carpe-noctem-cassel/cnc-circuit-boards/optical_flow_sensor/matlab_eval/fussball.jpg

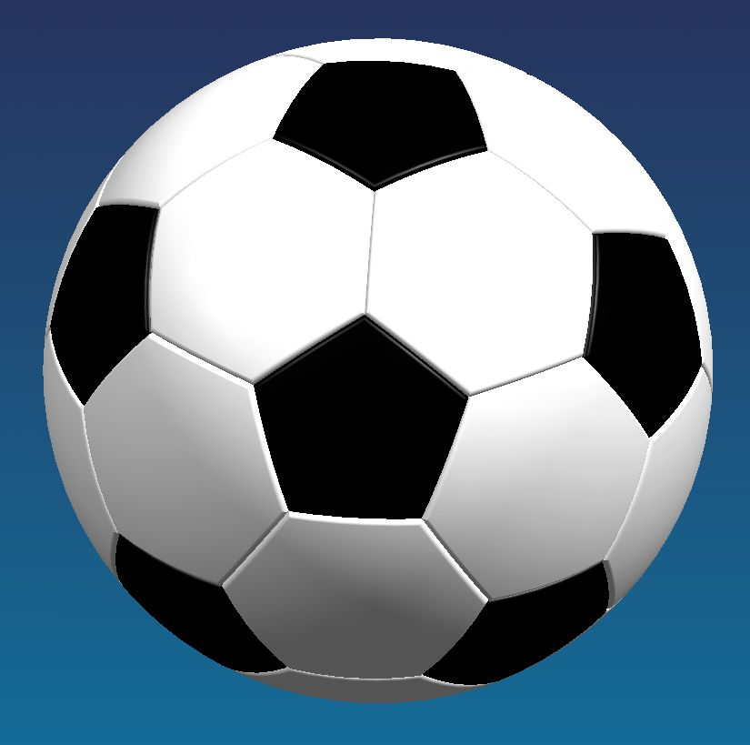
optical_flow_sensor/matlab_eval/fussball.jpg
