carpe-noctem-cassel/cnc-circuit-boards/actuator/actuator/fuses.png

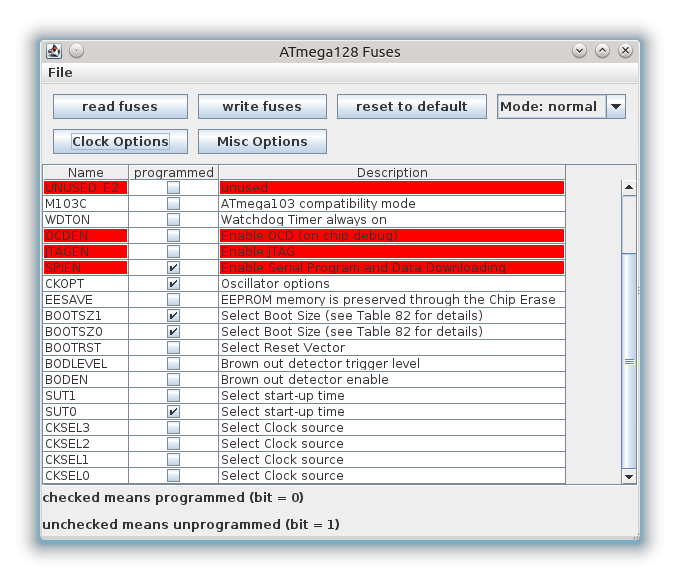
actuator/actuator/fuses.png
