carpe-noctem-cassel/cnc-circuit-boards/eth2can/eth2can/src/uip-0.9/doc/html/a00104.png

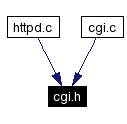
eth2can/eth2can/src/uip-0.9/doc/html/a00104.png
