carpe-noctem-cassel/cnc-circuit-boards/optical_flow_sensor/matlab_eval/Logfiles/20130215T172330/image_000.csv.png

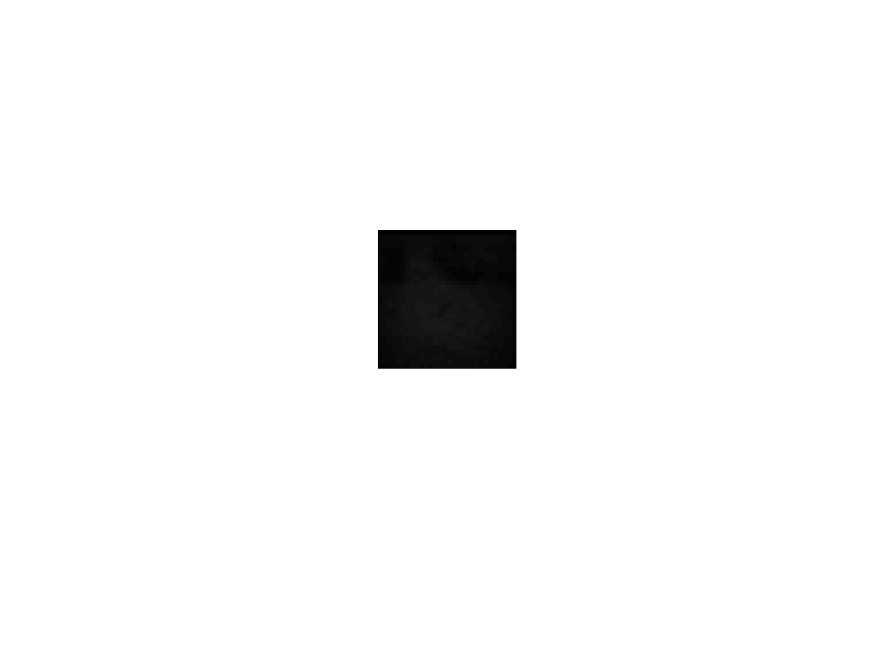
optical_flow_sensor/matlab_eval/Logfiles/20130215T172330/image_000.csv.png
