carpe-noctem-cassel/cnc-circuit-boards/powerSwitch/fuses.png

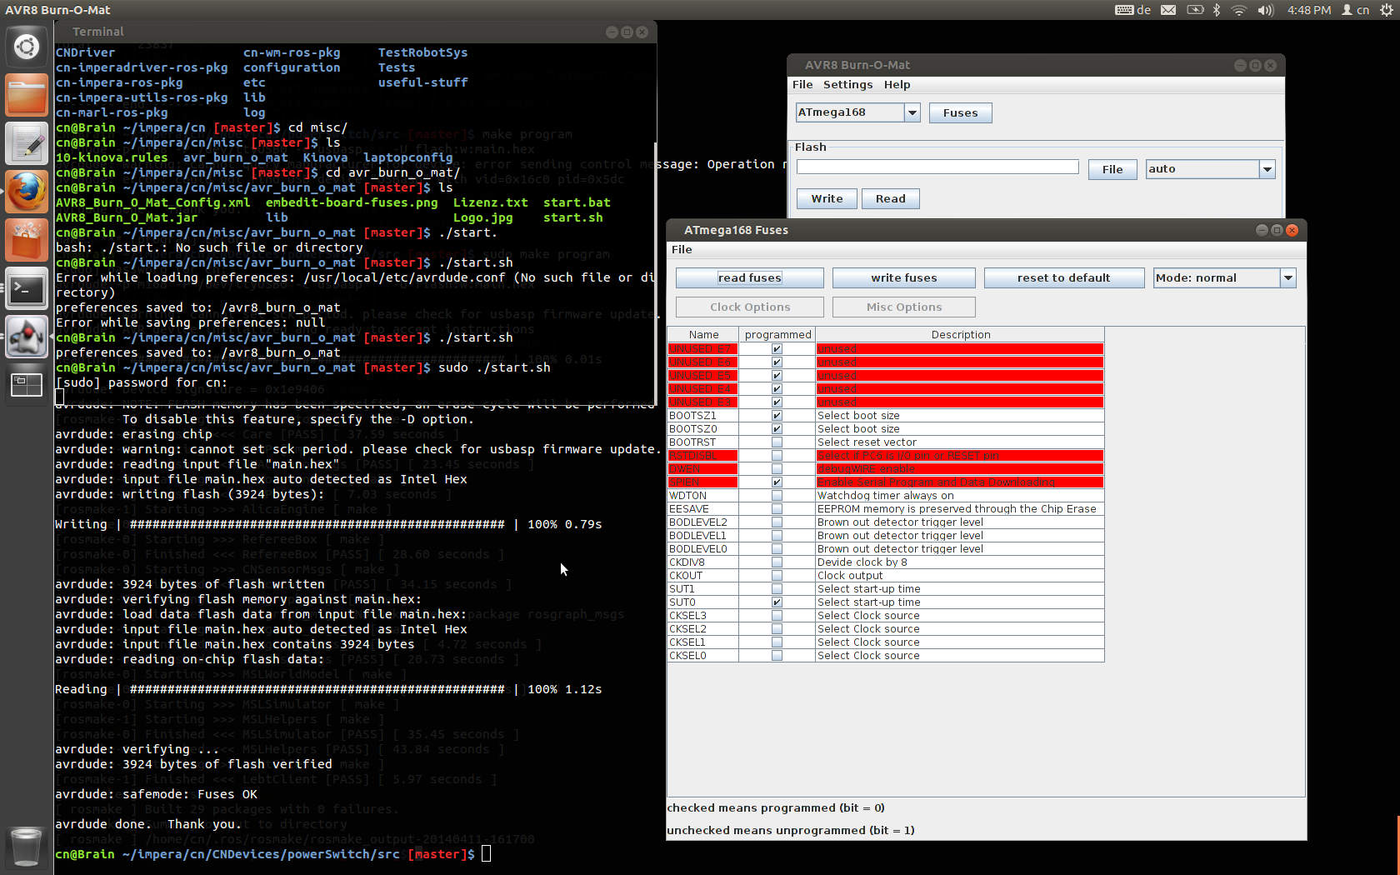
powerSwitch/fuses.png
