carpe-noctem-cassel/cnc-circuit-boards/kicker/rekick2017/pcb/BOM-rekick2017-v0.2.ods

Rekick 2017
Anzahl Boards: | 1
Typ | Name | Bauform | Menge | Menge Ges. | Preis p. Stk | Preis p. Board | Preis Ges. | Lieferant | Artikel-Nr/Bestell-Nr | URL
Operationsverstärker | MCP602-I/SN | SOIC-8 | 1 | 1 | 0.57 € | 0.57 € | 0.57 € | Farnell | 9758666 | http://de.farnell.com/microchip/mcp602-i-sn/op-amp-cmos-rro-p-smd-soic8-602/dp/9758666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
Operationsverstärker, isolierend | ADUM 4190 | SOIC-16N | 1 | 1 | 3.36 € | 3.36 € | 3.36 € | Farnell | 2293509 | http://de.farnell.com/analog-devices/adum4190ariz/getrennter-fehlerverst-5kv-16soic/dp/2293509?st=ADUM%204190
CAN Transceiver | MCP2551 | SOIC-8N | 1 | 1 | 1.10 € | 1.10 € | 1.10 € | Reichelt | MCP 2551-I/SN | http://www.reichelt.de/MCP-2551-I-SN/3/index.html?ACTION=3;ARTICLE=90069;SEARCH=MCP%202551-I/SN
MCU | ATMEGA32M1 | TQFP-32 | 1 | 1 | 6.51 € | 6.51 € | 6.51 € | Farnell | 2443180 | http://de.farnell.com/atmel/atmega32m1-au/mcu-8bit-atmega-16mhz-tqfp-32/dp/2443180?ost=atmega32m1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
Quarz 16MHz | HC49SM | HC49/4SMX | 1 | 1 | 0.36 € | 0.36 € | 0.36 € | Farnell | 1667017 | http://de.farnell.com/multicomp/hc49sm-16-30-50-60-16-atf/quarz-hc-49-4hsmx-16-0mhz/dp/1667017
NOR-Gatter | SN74LVC1G02DBVR | SOT-23-5 | 1 | 1 | 0.28 € | 0.28 € | 0.28 € | Farnell | 1287579 | http://de.farnell.com/texas-instruments/sn74lvc1g02dbvr/nor-gate-single-2-input-smd/dp/1287579
Quad NOR RS Latch | CD4043BD | SOIC-16N | 1 | 1 | 0.44 € | 0.44 € | 0.44 € | Farnell | 1741580 | http://de.farnell.com/texas-instruments/cd4043bd/logik-nor-r-s-latch-3st-quad-16soic/dp/1741580?st=CD4043B
Capacitor Charger | LT3751 | TSSOP-20 | 1 | 1 | 7.10 € | 7.10 € | 7.10 € | Mouser | 584-LT3751EFE#PBF | https://www.mouser.de/ProductDetail/Analog-Devices-Linear-Technology/LT3751EFEPBF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
Stecker ML | ML 10pol | RM 2.54 | 1 | 1 | 0.09 € | 0.09 € | 0.09 € | Reichelt | WSL 10G | http://www.reichelt.de/Pfosten-Wannenstecker/WSL-10G/3/index.html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
Molex Mini-Fit 6 Pin, Gehäuse | Molex Mini-Fit Jr., 6 Pin, Steckverbindergehäuse | 4.2mm | 1 | 1 | 0.27 € | 0.27 € | 0.27 € | Farnell | 151868 | http://de.farnell.com/molex/39-01-2060/mini-fit-geh-use-6pol-crimp/dp/151868
Molex Mini-Fit 6 Pin | Molex Mini-Fit Jr. 5569 6 Pin, Stiftleiste | 4.2mm | 1 | 1 | 1.04 € | 1.04 € | 1.04 € | Farnell | 1697135 | http://de.farnell.com/molex/39-30-0060/stecker-mini-fit-r-a-2reih-6kont/dp/1697135
Molex Mini-Fit 8 Pin, Gehäuse | Molex Mini-Fit Jr., 8 Pin, Steckverbindergehäuse | 4.2mm | 1 | 1 | 0.32 € | 0.32 € | 0.32 € | Farnell | 151869 | http://de.farnell.com/molex/39-01-2080/buchsengeh-use-8pol-crimpbar-mini/dp/151869?st=39-01-2080
Molex Mini-Fit 8 Pin | Molex Mini-Fit Jr. 5569 8 Pin, Stiftleiste | 4.2mm | 1 | 1 | 0.65 € | 0.65 € | 0.65 € | Farnell | 1697136 | http://de.farnell.com/molex/39-30-0080/stecker-mini-fit-r-a-2reih-8kont/dp/1697136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
Fuse | RUEF135 | bedrahtet RM 5.08 | 1 | 1 | 0.53 € | 0.53 € | 0.53 € | Farnell | 1175845 | http://de.farnell.com/te-connectivity-raychem/ruef135/polyswitch-sicherung-ptc-radial/dp/1175845
Diode | ES1A | SMA/DO-214AC | 5 | 5 | 0.13 € | 0.63 € | 0.63 € | Farnell | 1625028 | http://de.farnell.com/multicomp/es1a/diode-ultrakurze-erholzeit-1a/dp/1625028
Diode | DSEI30-10A | TO-247AD | 1 | 1 | 3.59 € | 3.59 € | 3.59 € | Farnell | 9359346 | http://de.farnell.com/ixys-semiconductor/dsei30-10a/diode-kurze-erholzeit-30a/dp/9359346
Diode, Zener 5V | BZX84-A5V1 | SOT23/TO236 | 2 | 2 | 0.16 € | 0.32 € | 0.32 € | Farnell | 2463546 | http://de.farnell.com/on-semiconductor/bzx84b5v1lt1g/zener-diode-225mw-5-1v-sot-23/dp/2463546?st=BZX84
Diode, Zener 12V | SZBZX84C12LT1G | SOT23/TO236 | 2 | 2 | 0.06 € | 0.12 € | 0.12 € | Farnell | 2728101 | http://de.farnell.com/on-semiconductor/szbzx84c12lt1g/zener-diode-aec-q101-12v-0-25w/dp/2728101
Diode, 1kV/8A | STTH810DI | TO-220 | 1 | 1 | 1.12 € | 1.12 € | 1.12 € | Farnell | 1295298 | http://de.farnell.com/stmicroelectronics/stth810di/diode-ultrakurze-erholzeit-8a/dp/1295298?st=STTH810D
LED, 2mA, grün | KP-2012LSGC | 0805 | 7 | 7 | 0.07 € | 0.52 € | 0.52 € | Farnell | 2463991 | http://de.farnell.com/kingbright/kp-2012lsgc/led-gr-n-0-8mcd-568nm-smd/dp/2463991
LED, 2mA, rot | KPT-2012LVSECK-J3-PRV | 0805 | 1 | 1 | 0.30 € | 0.30 € | 0.30 € | Farnell | 2610416 | http://de.farnell.com/kingbright/kpt-2012lvseck-j3-prv/led-rot-40mcd-625nm-smd/dp/2610416
Transistor n-Kanal, 30V/5A | IRLML6344TRPBF | SOT-23 | 4 | 4 | 0.33 € | 1.33 € | 1.33 € | Farnell | 1857299 | http://de.farnell.com/infineon/irlml6344trpbf/mosfet-n-kanal-30v-5a-sot23/dp/1857299
Transistor pnp, 30V/0.1A | BC 859B | SOT-23 | 1 | 1 | 0.03 € | 0.03 € | 0.03 € | Reichelt | BC 859B SMD | https://www.reichelt.de/BC-Transistoren/BC-859B-SMD/3/index.html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
Transistor -40V/-90A | IPD90P04P4L04ATMA1 | TO-252AA | 1 | 1 | 1.64 € | 1.64 € | 1.64 € | Farnell | 2480841 | http://de.farnell.com/infineon/ipd90p04p4l04atma1/mosfet-p-kanal-40v-90a-to-252/dp/2480841
Transistor 120V/70A | PSMN7R8-120PS | TO-220-3 | 2 | 2 | 1.21 € | 2.42 € | 2.42 € | Farnell | 2319894 | http://de.farnell.com/nxp/psmn7r8-120ps/mosfet-n-kanal-120v-70-to-220/dp/2319894?selectedCategoryId=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
Transistor 500V/8A | IRF840PBF | TO-220AB | 1 | 1 | 1.48 € | 1.48 € | 1.48 € | Farnell | 8648581 | http://de.farnell.com/vishay/irf840pbf/mosfet-n-kanal-500v-8a-to-220/dp/8648581
Transistor IGBT 1.2kV/100A | NGTB50N120FL2WG | TO-247 | 1 | 1 | 8.48 € | 8.48 € | 8.48 € | Farnell | 2399116 | http://de.farnell.com/on-semiconductor/ngtb50n120fl2wg/transistor-igbt-2-2v-100a-to-247/dp/2399116
Taster 24V/50mA, 1.47N | B3F-1022 | BF3 (6x6) | 1 | 1 | 0.24 € | 0.24 € | 0.24 € | Farnell | 1829495 | http://de.farnell.com/omron-electronic-components/b3f-1022/taster-6x6-spno-5mm-st-ssel/dp/1829495
Isolated Driver | SI8261ABC | SOIC-8 | 2 | 2 | 1.16 € | 2.32 € | 2.32 € | Farnell | 2423180 | http://de.farnell.com/silicon-labs/si8261abc-c-is/digital-isolator-40ns-nsoic-8/dp/2423180
DC/DC-Wandler 3.3V | LM1117MP-3.3 | SOT-223 | 1 | 1 | 0.90 € | 0.90 € | 0.90 € | Farnell | 9778195 | http://de.farnell.com/texas-instruments/lm1117mp-3-3/v-reg-ldo-3-3v-1117-sot223-3/dp/9778195
DC/DC-Wandler 5V | OKI515W36C | RM 2.54 | 2 | 2 | 5.35 € | 10.70 € | 10.70 € | Reichelt | OKI515W36C | https://www.reichelt.de/Wandler-groesser-1-W/OKI515W36C/3/index.html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
DC/DC-Wandler 12V | R-7812-05 | RM 2.54 | 1 | 1 | 8.60 € | 8.60 € | 8.60 € | Reichelt | R-7812-05 | https://www.reichelt.de/Wandler-bis-1-W/R-7812-05/3/index.html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
DC/DC-Wandler | TMH 2412S | SIP | 1 | 1 | 6.20 € | 6.20 € | 6.20 € | Farnell | 1007565 | http://de.farnell.com/tracopower/tmh-2412s/wandler-dc-dc-2w-12v-0-2a/dp/1007565?selectedCategoryId=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
Transformator | GA3459-BL (alternativ GA3460-BL) |  | 1 | 1 | 5.53 € | 5.53 € | 5.53 € | Farnell | 2458040 | http://de.farnell.com/coilcraft/ga3459-bl/transformator-flyback-lt3751-smd/dp/2458040?ost=GA3459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
Kondensator 10pF/10V | MC0603N100J500CT | 0603 | 2 | 2 | 0.01 € | 0.02 € | 0.02 € | Farnell | 2320799 | http://de.farnell.com/multicomp/mc0603n100j500ct/kondensator-mlcc-c0g-np0-10pf/dp/2320799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
Kondensator 22pF/10V | MCMT18N220F100CT | 0603 | 2 | 2 | 0.06 € | 0.13 € | 0.13 € | Farnell | 1856082 | http://de.farnell.com/multicomp/mcmt18n220f100ct/kondensator-mlcc-c0g-np0-22pf/dp/1856082
Kondensator 22pF/120V | MC1206N220J631CT | 1206 | 1 | 1 | 0.17 € | 0.17 € | 0.17 € | Farnell | 1855816 | http://de.farnell.com/multicomp/mc1206n220j631ct/kondensator-mlcc-c0g-np0-22pf/dp/1855816
Kondensator 100nF/16V | MC0603B104K160CT | 0603 | 15 | 15 | 0.01 € | 0.21 € | 0.21 € | Farnell | 1759016 | http://de.farnell.com/multicomp/mc0603b104k160ct/kondensator-mlcc-x7r-100nf-16v/dp/1759016
Kondensator 1µF/16V | MC0603F105Z100CT | 0603 | 5 | 5 | 0.02 € | 0.11 € | 0.11 € | Farnell | 1759398 | http://de.farnell.com/multicomp/mc0603f105z100ct/kondensator-mlcc-y5v-1uf-10v-0603/dp/1759398
Kondensator 10µF/10V | ZRB18AR61E106ME01L | 0603 | 2 | 2 | 0.27 € | 0.54 € | 0.54 € | Farnell | 2469398 | http://de.farnell.com/murata/zrb18ar61e106me01l/kondensator-mlcc-x5r-10uf-25v/dp/2469398
Kondensator 10µF/50V | GRM31CC8YA106KA12L | 1206 | 10 | 10 | 0.32 € | 3.21 € | 3.21 € | Farnell | 1889298 | http://de.farnell.com/murata/grm31cc8ya106ka12l/kondensator-mlcc-x6s-10uf-35v/dp/1889298
Kondensator 47µF/35V | VF 47/35 P-D | Panasonic D | 5 | 5 | 0.18 € | 0.90 € | 0.90 € | Reichelt | VF 47/35 P-D | http://www.reichelt.de/Elkos-SMD-Low-ESR-105-C/VF-47-35-P-D/3/index.html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
Kondensator 100µF/35V | ECA1VM101 | E2.5-7 | 3 | 3 | 0.17 € | 0.51 € | 0.51 € | Farnell | 9693670 | http://de.farnell.com/panasonic-electronic-components/eca1vm101/kondensator-alu-elko-100uf-35v/dp/9693670
Kondensator 0.1µF/450V | GRM55DR73A104KW01L | 2220 | 1 | 1 | 1.19 € | 1.19 € | 1.19 € | Farnell | 2456120 | http://de.farnell.com/murata/grm55dr73a104kw01l/kondensator-mlcc-x7r-0-1uf-1kv/dp/2456120
Kondensator 10µF/450V | EEU-EE2W100U | E6-10.5 | 1 | 1 | 0.96 € | 0.96 € | 0.96 € | Farnell | 1673499 | http://de.farnell.com/panasonic-electronic-components/eeuee2w100u/kondensator-alu-elko-10uf-450v/dp/1673499
Widerstand 0.002 | LRMAT2512-R002FT4 | 2512 | 2 | 2 | 0.31 € | 0.63 € | 0.63 € | Farnell | 2079420 | http://de.farnell.com/welwyn/lrmat2512-r002ft4/chipwiderstand-metalllegierung/dp/2079420
Widerstand 3.6 | ERJB1BF3R6U | 1020 | 3 | 3 | 0.44 € | 1.32 € | 1.32 € | Farnell | 2294017 | http://de.farnell.com/panasonic-electronic-components/erjb1bf3r6u/dickschichtwiderst-3r6-1-2w-2010/dp/2294017
Widerstand 4.7 | ASC0805-4R7FT5 | 0805 | 2 | 2 | 0.03 € | 0.06 € | 0.06 € | Farnell | 2078939 | http://de.farnell.com/welwyn/asc0805-4r7ft5/dickschichtwiderstand-4r7-1-0/dp/2078939
Widerstand 82Ohm, 5W | RKH214-8R | KH214R-8 | 6 | 6 | 0.44 € | 2.64 € | 2.64 € | Bürklin | 44 E 250 | https://www.buerklin.com/en/wire-wound-resistor/p/44e250
Widerstand 390, 1% | MCWR08X3900FTL | 0805 | 2 | 2 | 0.01 € | 0.01 € | 0.01 € | Farnell | 2447645 | http://de.farnell.com/multicomp/mcwr08x3900ftl/dickschichtwiderst-390-ohm-1-0/dp/2447645
Widerstand 1k, 1% | MC01W080511K | 0805 | 5 | 5 | 0.00 € | 0.01 € | 0.01 € | Farnell | 9332383 | http://de.farnell.com/multicomp/mc01w080511k/dickschichtwiderstand-1k-1-0-1w/dp/9332383
Widerstand 3.3k, 1% | MCWR08X3301FTL | 0805 | 2 | 2 | 0.01 € | 0.01 € | 0.01 € | Farnell | 2447651 | http://de.farnell.com/multicomp/mcwr08x3301ftl/dickschichtwiderstand-3k3-1-0/dp/2447651
Widerstand 4.7k, 1% | MC01W080514K7 | 0805 | 5 | 5 | 0.00 € | 0.01 € | 0.01 € | Farnell | 9333266 | http://de.farnell.com/multicomp/mc01w080514k7/dickschichtwiderstand-4k7-1-0/dp/9333266
Widerstand 5.6k, 1% | MC01W080555K6 | 0805 | 10 | 10 | 0.01 € | 0.05 € | 0.05 € | Farnell | 9334696 | http://de.farnell.com/multicomp/mc01w080555k6/dickschichtwiderstand-5k6-5-0/dp/9334696
Widerstand 10k, 1% | MCWR08X1002FTL | 0805 | 6 | 6 | 0.01 € | 0.04 € | 0.04 € | Farnell | 2447553 | http://de.farnell.com/multicomp/mcwr08x1002ftl/dickschichtwiderstand-10k-1-0/dp/2447553
Widerstand 14k, 1% | MCWR08X1402FTL | 0805 | 1 | 1 | 0.01 € | 0.01 € | 0.01 € | Farnell | 2447571 | http://de.farnell.com/multicomp/mcwr08x1402ftl/dickschichtwiderst-14kohm-1-0/dp/2447571
Widerstand 36.5k, 1% | MCWR08X3652FTL | 0805 | 1 | 1 | 0.01 € | 0.01 € | 0.01 € | Farnell | 2695046 | http://de.farnell.com/multicomp/mcwr08x3652ftl/dicksch-widerstand-36k5-1-0-125w/dp/2695046
Widerstand 50k, 1% | MCWR08X4992FTL | 0805 | 10 | 10 | 0.01 € | 0.07 € | 0.07 € | Farnell | 2447668 | http://de.farnell.com/multicomp/mcwr08x4992ftl/dickschichtwiderst-49k9-1-0-125w/dp/2447668
Widerstand 56k, 1% | MCWR08X5602FTL | 0805 | 1 | 1 | 0.01 € | 0.01 € | 0.01 € | Farnell | 2447687 | http://de.farnell.com/multicomp/mcwr08x5602ftl/dickschichtwiderstand-56k-1-0/dp/2447687
Widerstand 80.6k, 1% | MCMR08X8062FTL | 0805 | 2 | 2 | 0.02 € | 0.04 € | 0.04 € | Farnell | 2073847 | http://de.farnell.com/multicomp/mcmr08x8062ftl/keramikwiderstand-80k6-1-0-125w/dp/2073847
Widerstand 150k, 1% | MCWR08X1503FTL | 0805 | 1 | 1 | 0.01 € | 0.01 € | 0.01 € | Farnell | 2447573 | http://de.farnell.com/multicomp/mcwr08x1503ftl/dickschichtwiderst-150kohm-1-0/dp/2447573
Widerstand 180k, 1% | MCWR08X1803FTL | 0805 | 1 | 1 | 0.01 € | 0.01 € | 0.01 € | Farnell | 2447582 | http://de.farnell.com/multicomp/mcwr08x1803ftl/dickschichtwiderst-180kohm-1-0/dp/2447582
Widerstand 240k, 1% | MC01W08051240K | 0805 | 1 | 1 | 0.00 € | 0.00 € | 0.00 € | Farnell | 9332910 | http://de.farnell.com/multicomp/mc01w08051240k/dickschichtwiderstand-240k-1-0/dp/9332910
Widerstand 330k, 1% | MCWR08X3303FTL | 0805 | 2 | 2 | 0.01 € | 0.01 € | 0.01 € | Farnell | 2447637 | http://de.farnell.com/multicomp/mcwr08x3303ftl/dickschichtwiderst-330kohm-1-0/dp/2447637
Widerstand 560k, 1% | MC01W08051560K | 0805 | 1 | 1 | 0.00 € | 0.00 € | 0.00 € | Farnell | 9333398 | http://de.farnell.com/multicomp/mc01w08051560k/dickschichtwiderstand-560k-1-0/dp/9333398
Widerstand 1M. 1% | MC01W08051910K | 1206 | 3 | 3 | 0.00 € | 0.01 € | 0.01 € | Farnell | 9333657 | http://de.farnell.com/multicomp/mc01w08051910k/dickschichtwiderstand-910k-1-0/dp/9333657
Widerstand, NTC | B57211P0250M301 | - | 1 | 1 | 1.08 € | 1.08 € | 1.08 € | Farnell | 2101623 | http://de.farnell.com/epcos/b57211p0250m301/thermistor-disc-ntc-25-ohm-20/dp/2101623?st=ntc
Ethernet-Modul
Levelshifter
Molex Mini-Fit, Crimpkontakt, Female | Molex Mini-Fit Jr. 5556 Female Crimpkontakt 100Stk
Varistor
Widerstand 120
PinHeader 1x3 |  | RM 2.54 | 2
BuchsenHeader 1x5 |  | RM 2.54 | 2
