carpe-noctem-cassel/cnc-circuit-boards/beagle2can/beagle2can.ods

Beagle2CAN
Anzahl Boards: | 1
Typ | Name | Bauform | Menge | Menge Ges. | Preis p. Stk | Preis p. Board | Preis Ges. | Vorrätig | Lieferant | Artikel-Nr/Bestell-Nr | URL
LED, Diode, Transistor
LED, 2mA, grün | KP-2012LSGC | 0805 | 3 | 3 | 0.07 € | 0.22 € | 0.22 € |  | Farnell | 2463991 | http://de.farnell.com/kingbright/kp-2012lsgc/led-gr-n-0-8mcd-568nm-smd/dp/2463991
IC
CAN Transceiver | MCP2551 | SOIC-8N | 2 | 2 | 1.10 € | 2.20 € | 2.20 € |  | Reichelt | MCP 2551-I/SN | http://www.reichelt.de/MCP-2551-I-SN/3/index.html?ACTION=3;ARTICLE=90069;SEARCH=MCP%202551-I/SN
Pegelwandler | TXB0108PWR | SOP-20N | 1 | 0 | 1.52 € | 1.52 € | 1.52 € | ja | Farnell | 1494945 | http://de.farnell.com/texas-instruments/txb0108pwr/translator-8bit-bidirectional/dp/1494945
BeagleBoard Black | BeagleBoard Black | RM 2,54 2x23 | 1 | 1 | 43.07 € | 43.07 € | 43.07 € |  | Farnell | 2422228 | https://de.farnell.com/element14/bbone-black-4g/beaglebone-black-rev-c-cortex/dp/2422228
Stecker
CAN-Stecker | RJ10 | ? | 2 | 0 |  | 0.00 € | 0.00 € | ja
Stecker ML, gewinkelt | ML 10pol, gewinkelt | RM 2.54 | 1 | 1 | 0.15 € | 0.15 € | 0.15 € |  | Reichelt | WSL 10W | http://www.reichelt.de/?ACTION=3;ARTICLE=22818;SEARCH=Wannenstecker,%2010-polig,%20gew
Stiftleiste | Stiftleiste 2x23 | RM 2.54 | 2 | 2 | 0.24 € | 0.48 € | 0.48 € |  | Reichelt | SL 2X25G 2,54 | http://www.reichelt.de/?ACTION=3;ARTICLE=19494;SEARCH=SL%202X25
Molex Mini-Fit 4 Pin | Molex Mini-Fit Jr. 5569 4 Pin, Stiftleiste | 4.2mm | 2 | 2 | 0.57 € | 1.14 € | 1.14 € |  | Farnell | 1697133 | http://de.farnell.com/molex/39-30-0040/stecker-mini-fit-r-a-2reih-4kont/dp/1697133
Molex Mini-Fit 4 Pin, Gehäuse | Molex Mini-Fit Jr., 4 Pin, Steckverbindergehäuse | 4.2mm | 2 | 2 | 0.19 € | 0.39 € | 0.39 € |  | Farnell | 151867 | http://de.farnell.com/molex/39-01-2040/mini-fit-geh-use-4pol-crimp/dp/151867
Fuse | RUEF135 | bedrahtet RM 5.08 | 1 | 1 | 0.42 € | 0.42 € | 0.42 € |  | Farnell | 1175845 | http://de.farnell.com/te-connectivity-raychem/ruef135/polyswitch-sicherung-ptc-radial/dp/1175845
DC/DC-Wanler 5V, 2.5W | R-78E5.0-0.5 | TO-220 | 1 | 1 | 2.51 € | 2.51 € | 2.51 € |  | Farnell | 2078564 | http://de.farnell.com/recom-power/r-78e5-0-0-5/dc-dc-wandler-5v-2-5w/dp/2078564
Widerstände
Widerstand 120 | MC01W08051120R | 0805 | 2 | 0 | 0.00 € | 0.00 € | 0.00 € | ja | Farnell | 9332480 | http://de.farnell.com/multicomp/mc01w08051120r/dickschichtwiderstand-120r-1-0/dp/9332480
Widerstand 560 | MC01W08051560R | 0805 | 1 | 1 | 0.00 € | 0.00 € | 0.00 € |  | Farnell | 9333363 | http://de.farnell.com/multicomp/mc01w08051560r/dickschichtwiderstand-560r-1-0/dp/9333363
Widerstand 1k, 1% | MC01W080511K | 0805 | 3 | 3 | 0.00 € | 0.01 € | 0.01 € |  | Farnell | 9332383 | http://de.farnell.com/multicomp/mc01w080511k/dickschichtwiderstand-1k-1-0-1w/dp/9332383
Widerstand 10k, 1% | WF08P1002FTL | 0805 | 3 | 3 | 0.01 € | 0.02 € | 0.02 € |  | Farnell | 2502786 | http://de.farnell.com/walsin/wf08p1002ftl/dickschichtwiderstand-10k-1-150v/dp/2502786
Kondensatoren
Kondensator 100nF/16V | MC0603B104K160CT | 0603 | 6 | 6 | 0.01 € | 0.08 € | 0.08 € |  | Farnell | 1759016 | http://de.farnell.com/multicomp/mc0603b104k160ct/kondensator-mlcc-x7r-100nf-16v/dp/1759016
Kondensator 47µF/35V | VF 47/35 P-D | Panasonic D | 2 | 2 | 0.18 € | 0.36 € | 0.36 € |  | Reichelt | VF 47/35 P-D | http://www.reichelt.de/Elkos-SMD-Low-ESR-105-C/VF-47-35-P-D/3/index.html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
 |  |  |  |  | 50.06 € | 52.58 € | 52.58 €
