carpe-noctem-cassel/cnc-circuit-boards/powerSwitch/2016-v0.95.ods

PowerSwitch
Anzahl Boards: | 1
Typ | Name | Bauform | Menge | Menge Ges. | Preis p. Stk | Preis p. Board | Preis Ges. | Vorrätig | Lieferant | Artikel-Nr/Bestell-Nr | URL
LED, Diode, Transistor
LED, 2mA, grün | KP-2012LSGC | 0805 | 4 | 4 | 0.07 € | 0.30 € | 0.30 € |  | Farnell | 2463991 | http://de.farnell.com/kingbright/kp-2012lsgc/led-gr-n-0-8mcd-568nm-smd/dp/2463991
LED, 2mA, gelb | KPT-2012LVSYCK-J3-PRV | 0805 | 2 | 2 | 0.30 € | 0.59 € | 0.59 € |  | Farnell | 2610418 | http://de.farnell.com/kingbright/kpt-2012lvsyck-j3-prv/led-gelb-25mcd-590nm-smd/dp/2610418
LED, 2mA, rot | KPT-2012LVSECK-J3-PRV | 0805 | 1 | 1 | 0.30 € | 0.30 € | 0.30 € |  | Farnell | 2610416 | http://de.farnell.com/kingbright/kpt-2012lvseck-j3-prv/led-rot-40mcd-625nm-smd/dp/2610416
LED, 2mA, blau | KPT-2012LVVBC-D | 0805 | 1 | 1 | 0.35 € | 0.35 € | 0.35 € |  | Farnell | 2610420 | http://de.farnell.com/kingbright/kpt-2012lvvbc-d/led-blau-24mcd-470nm-smd/dp/2610420
Diode | ES1A | SMA/DO-214AC | 3 | 3 | 0.13 € | 0.38 € | 0.38 € |  | Farnell | 1625028 | http://de.farnell.com/multicomp/es1a/diode-ultrakurze-erholzeit-1a/dp/1625028
Spannungsreferenz | TL431FDT | SOT-23 | 6 | 6 | 0.07 € | 0.41 € | 0.41 € |  | Farnell | 2095479 | http://de.farnell.com/nxp/tl431fdt/spannungsref-shunt-2-495v-36v/dp/2095479
Zenerdiode 3.3V | BZX84-A3V3,215 | SOT-23 | 1 | 1 | 0.37 € | 0.37 € | 0.37 € |  | Farnell | 2463632 | http://de.farnell.com/nxp/bzx84-a3v3-215/zener-diode-0-25w-3-3v-sot-23/dp/2463632
Transistor n-Kanal 60V, 270mA | NX7002BK (alternative zu BC 849B SMD) | SOT-23 | 1 | 1 | 0.06 € | 0.06 € | 0.06 € |  | Farnell | 2469640 | http://de.farnell.com/nxp/nx7002bk/mosfet-n-kanal-60v-0-27a-sot-23/dp/2469640?ost=2469640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
Transistor p-Kanal 50V, 130mA | BSS84 (alternative zu BC 859B SMD) | SOT-23 | 2 | 2 | 0.07 € | 0.13 € | 0.13 € |  | Farnell | 1094997 | http://de.farnell.com/fairchild-semiconductor/bss84/mosfet-p-kanal-50v-0-13a-sot23/dp/1094997?ost=1094997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
Transistor n-Kanal | BTS555 | TO220-51 | 1 | 1 | 8.35 € | 8.35 € | 8.35 € |  | Reichelt | BTS 555 | http://www.reichelt.de/BS-Transistoren/BTS-555/3/index.html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
Transistor n-Kanal | BTS6133 | TO252-51 | 2 | 2 | 2.44 € | 4.88 € | 4.88 € |  | Farnell | 1440811 | http://de.farnell.com/infineon/bts6133d/profet-p-to252-5/dp/1440811
Transistor p-Kanal | IPP80P03P4L04AKSA1 | TO-220BV | 4 | 4 | 1.47 € | 5.88 € | 5.88 € |  | Farnell | 2443406 | http://de.farnell.com/infineon/ipp80p03p4l-04/mosfet-p-kanal-30v-80a-to-220/dp/2443406
IC
CAN Transceiver | MCP2551 | SOIC-8N | 1 | 1 | 1.10 € | 1.10 € | 1.10 € |  | Reichelt | MCP 2551-I/SN | http://www.reichelt.de/MCP-2551-I-SN/3/index.html?ACTION=3;ARTICLE=90069;SEARCH=MCP%202551-I/SN
MCU | ATMEGA16M1 | TQFP-32 | 1 | 1 | 6.51 € | 6.51 € | 6.51 € |  | Farnell | 2443180 | http://de.farnell.com/atmel/atmega32m1-au/mcu-8bit-atmega-16mhz-tqfp-32/dp/2443180?exaMfpn=true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
Operationsverstärker | LM 1458D | SOIC-8 | 1 | 1 | 0.12 € | 0.12 € | 0.12 € |  | Reichelt | LM 1458 D | http://www.reichelt.de/index.html?ACTION=3;ARTICLE=39428;SEARCH=LM%201458%20D
Pegelwandler | TXB0108PWR | SOP-20N | 1 | 0 | 1.52 € | 1.52 € | 1.52 € | ja | Farnell | 1494945 | http://de.farnell.com/texas-instruments/txb0108pwr/translator-8bit-bidirectional/dp/1494945
Stecker
CAN-Stecker | RJ10 | ? | 1 | 0 |  | 0.00 € | 0.00 € | ja
Stecker ML | ML 10pol | RM 2.54 | 1 | 1 | 0.09 € | 0.09 € | 0.09 € |  | Reichelt | WSL 10G | http://www.reichelt.de/Pfosten-Wannenstecker/WSL-10G/3/index.html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
Stecker ML, gewinkelt | ML 10pol, gewinkelt | RM 2.54 | 1 | 1 | 0.15 € | 0.15 € | 0.15 € |  | Reichelt | WSL 10W | http://www.reichelt.de/?ACTION=3;ARTICLE=22818;SEARCH=Wannenstecker,%2010-polig,%20gew
Stiftleiste | Stiftleiste 1x5 | RM 2.54 | 2 | 0 | 0.37 € | 0.74 € | 0.74 € | ja | Reichelt | SL 1X50G 2,54 | http://www.reichelt.de/Stiftleisten/SL-1X50G-2-54/3/index.html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
Molex Mini-Fit 4 Pin | Molex Mini-Fit Jr. 5569 4 Pin, Stiftleiste | 4.2mm | 2 | 2 | 0.57 € | 1.14 € | 1.14 € |  | Farnell | 1697133 | http://de.farnell.com/molex/39-30-0040/stecker-mini-fit-r-a-2reih-4kont/dp/1697133
Molex Mini-Fit 6 Pin | Molex Mini-Fit Jr. 5569 6 Pin, Stiftleiste | 4.2mm | 2 | 2 | 1.04 € | 2.08 € | 2.08 € |  | Farnell | 1697135 | http://de.farnell.com/molex/39-30-0060/stecker-mini-fit-r-a-2reih-6kont/dp/1697135
Molex Mini-Fit 4 Pin, Gehäuse | Molex Mini-Fit Jr., 4 Pin, Steckverbindergehäuse | 4.2mm | 2 | 2 | 0.19 € | 0.39 € | 0.39 € |  | Farnell | 151867 | http://de.farnell.com/molex/39-01-2040/mini-fit-geh-use-4pol-crimp/dp/151867
Molex Mini-Fit 6 Pin, Gehäuse | Molex Mini-Fit Jr., 6 Pin, Steckverbindergehäuse | 4.2mm | 2 | 2 | 0.27 € | 0.55 € | 0.55 € |  | Farnell | 151868 | http://de.farnell.com/molex/39-01-2060/mini-fit-geh-use-6pol-crimp/dp/151868
Molex Mini-Fit, Crimpkontakt, Female | Molex Mini-Fit Jr. 5556 Female Crimpkontakt 100Stk | - | 1 | 1 | 8.80 € | 8.80 € | 8.80 € |  | Farnell | 9732195 | http://de.farnell.com/molex/39-00-0039/crimpkontak-buchse-minfit-pk100/dp/9732195
Fuse | RUEF135 | bedrahtet RM 5.08 | 1 | 1 | 0.42 € | 0.42 € | 0.42 € |  | Farnell | 1175845 | http://de.farnell.com/te-connectivity-raychem/ruef135/polyswitch-sicherung-ptc-radial/dp/1175845
Quarz 16MHz | HC49SM | HC49/4SMX | 1 | 1 | 0.36 € | 0.36 € | 0.36 € |  | Farnell | 1667017 | http://de.farnell.com/multicomp/hc49sm-16-30-50-60-16-atf/quarz-hc-49-4hsmx-16-0mhz/dp/1667017
Summer | MCKPX-G1205A-3700 | RM7.6 | 1 | 1 | 0.59 € | 0.59 € | 0.59 € |  | Farnell | 2135914 | http://de.farnell.com/multicomp/mckpx-g1205a-3700/summer-4v-8v-30ma-bei-5vdc/dp/2135914
DC/DC-Wanler 3.3V, 1.65W | R-78E3.3-0.5 | TO-220 | 1 | 1 | 2.53 € | 2.53 € | 2.53 € |  | Farnell | 2218602 | http://de.farnell.com/recom-power/r-78e3-3-0-5/dc-dc-wandler-3-3v-500ma-aus-durchst/dp/2218602
DC/DC-Wanler 5V, 2.5W | R-78E5.0-0.5 | TO-220 | 1 | 1 | 2.51 € | 2.51 € | 2.51 € |  | Farnell | 2078564 | http://de.farnell.com/recom-power/r-78e5-0-0-5/dc-dc-wandler-5v-2-5w/dp/2078564
Ethernet-Modul | ENC28J60-H | Stiftleisten (2x 1x5) | 1 | 1 | 18.17 € | 18.17 € | 18.17 € |  | Farnell | 1701543 | http://de.farnell.com/olimex/enc28j60-h/modul-enc28j60-spi-ethernet/dp/1701543
Kühlkörper | SK 95 25 TO 220 | für TO-220 | 4 | 4 | 2.03 € | 8.12 € | 8.12 € |  | Farnell | 4621554 | http://de.farnell.com/fischer-elektronik/sk-95-25sa-220/k-hlk-rper-to-220-36-c-w/dp/4621554?ost=sk95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
Widerstände
Widerstand 0.002 | LRMAT2512-R002FT4 | 2512 | 1 | 1 | 0.31 € | 0.31 € | 0.31 € |  | Farnell | 2079420 | http://de.farnell.com/welwyn/lrmat2512-r002ft4/chipwiderstand-metalllegierung/dp/2079420
Widerstand 120 | MC01W08051120R | 0805 | 1 | 0 | 0.00 € | 0.00 € | 0.00 € | ja | Farnell | 9332480 | http://de.farnell.com/multicomp/mc01w08051120r/dickschichtwiderstand-120r-1-0/dp/9332480
Widerstand 150 | MC01W08051150R | 0805 | 0 | 0 | 0.00 € | 0.00 € | 0.00 € |  | Farnell | 9332596 | http://de.farnell.com/multicomp/mc01w08051150r/dickschichtwiderstand-150r-1-0/dp/9332596
Widerstand 560 | MC01W08051560R | 0805 | 3 | 3 | 0.00 € | 0.01 € | 0.01 € |  | Farnell | 9333363 | http://de.farnell.com/multicomp/mc01w08051560r/dickschichtwiderstand-560r-1-0/dp/9333363
Widerstand 1k, 1% | MC01W080511K | 0805 | 6 | 6 | 0.00 € | 0.01 € | 0.01 € |  | Farnell | 9332383 | http://de.farnell.com/multicomp/mc01w080511k/dickschichtwiderstand-1k-1-0-1w/dp/9332383
Widerstand 4.7k, 1% | MC01W080514K7 | 0805 | 4 | 4 | 0.00 € | 0.01 € | 0.01 € |  | Farnell | 9333266 | http://de.farnell.com/multicomp/mc01w080514k7/dickschichtwiderstand-4k7-1-0/dp/9333266
Widerstand 10k, 1% | WF08P1002FTL | 0805 | 8 | 8 | 0.01 € | 0.06 € | 0.06 € |  | Farnell | 2502786 | http://de.farnell.com/walsin/wf08p1002ftl/dickschichtwiderstand-10k-1-150v/dp/2502786
Widerstand 20k, 1% | MC01W0805120K | 0805 | 3 | 3 | 0.00 € | 0.01 € | 0.01 € |  | Farnell | 9332774 | http://de.farnell.com/multicomp/mc01w0805120k/dickschichtwiderstand-20k-1-0/dp/9332774
Widerstand 50k, 1% | MC01W0805149K9 | 0805 | 0 | 0 | 0.00 € | 0.00 € | 0.00 € |  | Farnell | 2141884 | http://de.farnell.com/multicomp/mc01w0805149k9/dickschichtwiderstand-49k9-1-0/dp/2141884
Widerstand 100k, 1% | MC01W08051100K | 0805 | 7 | 7 | 0.00 € | 0.02 € | 0.02 € |  | Farnell | 9332405 | http://de.farnell.com/multicomp/mc01w08051100k/dickschichtwiderstand-100k-1-0/dp/9332405
Widerstand 240k, 1% | MC01W08051240K | 0805 | 2 | 2 | 0.00 € | 0.00 € | 0.00 € |  | Farnell | 9332910 | http://de.farnell.com/multicomp/mc01w08051240k/dickschichtwiderstand-240k-1-0/dp/9332910
Widerstand 560k, 1% | MC01W08051560K | 0805 | 1 | 1 | 0.00 € | 0.00 € | 0.00 € |  | Farnell | 9333398 | http://de.farnell.com/multicomp/mc01w08051560k/dickschichtwiderstand-560k-1-0/dp/9333398
Widerstand 910k. 1% | MC01W08051910K | 0805 | 1 | 1 | 0.00 € | 0.00 € | 0.00 € |  | Farnell | 9333657 | http://de.farnell.com/multicomp/mc01w08051910k/dickschichtwiderstand-910k-1-0/dp/9333657
Induktivitäten
Induktivität 68µH | SMD-Power-Induktivität, PISM, Ferrit, 68µ | PISM | 1 | 1 | 0.79 € | 0.79 € | 0.79 € |  | Reichelt | L-PISM 68µ | http://www.reichelt.de/L-PISM-68-/3/index.html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
Kondensatoren
Kondensator 22pF/10V | MCMT18N220F100CT | 0603 | 2 | 2 | 0.06 € | 0.13 € | 0.13 € |  | Farnell | 1856082 | http://de.farnell.com/multicomp/mcmt18n220f100ct/kondensator-mlcc-c0g-np0-22pf/dp/1856082
Kondensator 10nF/50V | MC0603B103K500CT | 0603 | 0 | 0 | 0.01 € | 0.00 € | 0.00 € |  | Farnell | 1759102 | http://de.farnell.com/multicomp/mc0603b103k500ct/kondensator-mlcc-x7r-10nf-50v/dp/1759102
Kondensator 100nF/16V | MC0603B104K160CT | 0603 | 8 | 8 | 0.01 € | 0.11 € | 0.11 € |  | Farnell | 1759016 | http://de.farnell.com/multicomp/mc0603b104k160ct/kondensator-mlcc-x7r-100nf-16v/dp/1759016
Kondensator 47µF/35V | VF 47/35 P-D | Panasonic D | 3 | 3 | 0.18 € | 0.54 € | 0.54 € |  | Reichelt | VF 47/35 P-D | http://www.reichelt.de/Elkos-SMD-Low-ESR-105-C/VF-47-35-P-D/3/index.html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
Kondensator 1000µF/25V | MCGPR25V108M10X21 | E5-10 | 1 | 1 | 0.41 € | 0.41 € | 0.41 € |  | Farnell | 9451226 | http://de.farnell.com/multicomp/mcgpr25v108m10x21/alu-elko-1000uf-25v-radial/dp/9451226
 |  |  |  |  | 63.13 € | 80.29 € | 80.29 €
