carpe-noctem-cassel/cnc-circuit-boards/usbasp_smd/Bestellliste_Reichelt.xls

Part | Reichelt Bestellnummer | Anzahl | Einzelpreis | Gesamtpreis | Note
C1 | RAD 4,7/35 | 1 | 0.041 € | 0.04 € | falsches Rastermaß
C3 | X7R-G0603 100N | 1 | 0.051 € | 0.05 €
C4, C5 | NPO-G0603 22P | 2 | 0.051 € | 0.10 €
IC1 | ATMEGA 48-20 AU | 1 | 1.450 € | 1.45 €
JP1 | JUMPER 2,54 RT | 1 | 0.041 € | 0.04 €
JP2 | JUMPER 2,54 SW | 1 | 0.041 € | 0.04 €
JP3 | JUMPER 2,54 GN | 1 | 0.041 € | 0.04 €
JP* | SL 1X36G 2,54 | 1 | 0.170 € | 0.17 €
L1 | L-PIS2408 47µ |  |  | 0.00 € | nicht lieferbar, egal
LED1 | LED 3MM 2MA GN | 1 | 0.092 € | 0.09 €
LED2 | LED 3MM 2MA RT | 1 | 0.092 € | 0.09 €
Q1 | 12,0000-HC49U-S | 1 | 0.240 € | 0.24 €
R1, R2 | SMD-0805 100 | 2 | 0.100 € | 0.20 €
R3 | SMD-0805 1,50K | 1 | 0.100 € | 0.10 €
R4, R5, R7 | SMD-0805 1,00K | 1 | 0.100 € | 0.10 €
R4, R5, R7 | SMD-0805 2,70K | 2 | 0.100 € | 0.20 €
R6 | SMD-0805 10,0K | 1 | 0.100 € | 0.10 €
S1 | TASTER 3301 | 1 | 0.082 € | 0.08 €
X1 | USB BW | 1 | 0.250 € | 0.25 €
X2 | WSL 10W | 1 | 0.100 € | 0.10 €
 |  |  |  | 3.49 €
