carpe-noctem-cassel/cnc-circuit-boards/usbasp_smd/Bestellliste_Reichelt02.xls

Part | Reichelt Bestellnummer | Anzahl | Einzelpreis | Gesamtpreis | Note
C1 | RAD 4,7/35 | 1 | 0.041 | 0.041 | falsches Rastermaß
C3 | X7R-G0603 100N | 1 | 0.051 | 0.051
C4, C5 | NPO-G0603 22P | 2 | 0.051 | 0.102
D1, D2 | SMD ZD 3,6 | 2 | 0.092 | 0.184
IC1 | ATMEGA 48-20 AU | 1 | 1.45 | 1.45
JP1 | JUMPER 2,54 RT | 1 | 0.041 | 0.041
JP2 | JUMPER 2,54 SW | 1 | 0.041 | 0.041
JP3 | JUMPER 2,54 GN | 1 | 0.041 | 0.041
JP* | SL 1X36G 2,54 | 1 | 0.17 | 0.17
LED1 | LP L2965 | 1 | 0.1 | 0.1
LED2 | LY L29K | 1 | 0.1 | 0.1
LED1 | LED 3MM 2MA GN | 1 | 0.092 | 0.092
LED2 | LED 3MM 2MA RT | 1 | 0.092 | 0.092
Q1 | 12,0000-HC49U-S | 1 | 0.24 | 0.24
R1, R2 | SMD-0805 68,0 | 2 | 0.1 | 0.2
R3 | SMD-0805 2,20K | 1 | 0.1 | 0.1
R7 | SMD-0805 1,00K | 1 | 0.1 | 0.1
R4, R5 | SMD-0805 2,70K | 2 | 0.1 | 0.2
R6 | SMD-0805 10,0K | 1 | 0.1 | 0.1
S1 | TASTER 3301 | 1 | 0.082 | 0.082
X1 | USB BW | 1 | 0.25 | 0.25
X2 | WSL 10W | 1 | 0.1 | 0.1
 |  |  |  | 3.877
