carpe-noctem-cassel/cnc-circuit-boards/actuator/BBB_Cape/CN-Cape1.1.ods

Part List for BBB Cape
Typ | Name | Bauform | Menge | Lieferant | Artikel-Nr/Bestell-Nr | URL
Digital Isolator | ADUM1200 | SOIC-8N | 2 | Farnell | 1078204 | http://de.farnell.com/analog-devices/adum1200arz/digital-isolator-2ch-1200-soic8/dp/1078204?ost=1078204
Digital Isolator | ADUM1300 | SOIC-16N | 2 | Farnell | 1226209 | http://de.farnell.com/analog-devices/adum1300arwz/digital-isolator-3ch-smd-adum1300/dp/1226209
JST Stecker | JST EH Series 7pol Stecker | 7 Pin stehend | 1 | Farnell | 1830717 | http://de.farnell.com/jst-japan-solderless-terminals/b7b-eh-a/stecker-eh-top-7kont-2-5mm/dp/1830717
JST Stecker | JST EH Series 7pol Gehäuse | 7 Pin Gehäuse | 1 | Farnell | 1830709 | http://de.farnell.com/jst-japan-solderless-terminals/ehr-7/steckverbindergeh-eh-7kont-2-5mm/dp/1830709
JST Stecker | JST EH Series 8pol Stecker | 8 Pin liegend | 1 | Farnell | 1830722 | http://de.farnell.com/jst-japan-solderless-terminals/s8b-eh/stecker-eh-side-8kont-2-5mm/dp/1830722
JST Stecker | JST EH Series 8pol Gehäuse | 8 Pin Gehäuse | 1 | Farnell | 1830710 | http://de.farnell.com/jst-japan-solderless-terminals/ehr-8/steckverbindergeh-eh-8kont-2-5mm/dp/1830710
JST Stecker | JST EH Series Krimpkontakt | Krimpkontakt | 15 | Farnell | 2399172 | http://de.farnell.com/jst-japan-solderless-terminals/beh-001t-p0-6/eh-contact-loose-piece/dp/2399172
LED | MULTICOMP LED GRÜN | 0603 | 4 | Farnell | 2112121 | http://de.farnell.com/multicomp/703-0109/led-0603-gr-n-11mcd-572nm/dp/2112121
Pegelwandler | TXB0108PWR | SOP-20N | 2 | Farnell | 1494945 | http://de.farnell.com/texas-instruments/txb0108pwr/translator-8bit-bidirectional/dp/1494945
Spannungsregler 5V 1A | LM340 | SOT-223 | 1 | Farnell | 1469097 | http://de.farnell.com/texas-instruments/lm340mp-5-0-nopb/spannungsregler-linear-5v-smd/dp/1469097
CAN Transceiver | MCP2551 | SOIC-8N | 1 | Reichelt | MCP 2551-I/SN | http://www.reichelt.de/MCP-2551-I-SN/3/index.html?ACTION=3;ARTICLE=90069;SEARCH=MCP%202551-I/SN
Diode | MBRS140 | SMB, DO-214 AA | 1 | Reichelt | MBRS 140 SMD | http://www.reichelt.de/index.html?ACTION=3;ARTICLE=41969;SEARCH=MBRS%20140%20SMD
Diode | MBRS360 | SMC, DO-214 AB | 1 | Reichelt | MBRS 360 SMD | http://www.reichelt.de/index.html?ACTION=3;ARTICLE=41973;SEARCH=MBRS%20360%20SMD
Diode | SD 101BW | SOD123 | 3 | Reichelt | SD 101BW | http://www.reichelt.de/MCP-2551-I-SN/3/index.html?ACTION=3;ARTICLE=95362;SEARCH=SD%20101BW
Diode | BY 550-50 | DO-201AD | 1 | Reichelt | BY 550-50 | http://www.reichelt.de/MCP-2551-I-SN/3/index.html?ACTION=3;ARTICLE=41920;SEARCH=BY%20550-50
Induktivität 100µH | SMD-Power-Induktivität, PISR, Ferrit, 100µ | L-PISR | 1 | Reichelt | L-PISR 100µ | http://www.reichelt.de/Controller-Speicher/0/16/index.html?ACTION=3;ARTICLE=73070;SEARCH=L-PISR%20100%C2%B5
Induktivität 330µH | SMD-Power-Induktivität, PISR, Ferrit, 330µ | L-PISR | 1 | Reichelt | L-PISR 330µ | http://www.reichelt.de/Controller-Speicher/0/16/index.html?ACTION=3;ARTICLE=73073;SEARCH=L-PISR%20330%C2%B5
Schaltregler 5V 1A | LM2575 T5.0 | TO-220-5 | 1 | Reichelt | LM 2575 T5,0 | http://www.reichelt.de/index.html?ACTION=3;ARTICLE=10424;SEARCH=LM%202575%20T5,0
Schaltregler 5V 3A | LM2576 T5.0 | TO-220-5 | 1 | Reichelt | LM 2576 T5,0 | http://www.reichelt.de/index.html?ACTION=3;ARTICLE=10425;SEARCH=LM%202576%20T5,0
Stecker ML | ML 6pol | RM 2.54 | 1 | Reichelt | WSL 6G | http://www.reichelt.de/Pfosten-Wannenstecker/WSL-6G/3/index.html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
Stecker ML | ML 10pol | RM 2.54 | 1 | Reichelt | WSL 10G | http://www.reichelt.de/Pfosten-Wannenstecker/WSL-10G/3/index.html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
Stiftleiste | Stiftleiste 2x25 (für 2x23) | RM 2.54 | 2 | Reichelt | SL 2X25G 2,54 | http://www.reichelt.de/MPE-087-2-064/3/index.html?ACTION=3;ARTICLE=19494;SEARCH=SL%202x25G
Stiftleiste | Stiftleiste 1x02 | RM 2.54 | 3 | Reichelt | MPE 087-1-002 | http://www.reichelt.de/Stiftleisten/MPE-087-1-002/3/index.html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
Stiftleiste | Stiftleiste 1x03 | RM 2.54 | 5 | Reichelt | MPE 087-1-003 | http://www.reichelt.de/Stiftleisten/MPE-087-1-003/3/index.html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
Stiftleiste | Stiftleiste 1x08 | RM 2.54 | 2 | Reichelt | MPE 087-1-008 | http://www.reichelt.de/Stiftleisten/MPE-087-1-008/3/index.html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
Transistor | N-Kanal IRLML 6244 | SOT-23 | 4 | Reichelt | IRLML 6244 | http://www.reichelt.de/IRL-IRFZ-Transistoren/IRLML-6244/3/index.html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
Transistor | P-Kanel IRLML 2244 | SOT-23 | 4 | Reichelt | IRLML 2244 | http://www.reichelt.de/IRL-IRFZ-Transistoren/IRLML-2244/3/index.html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
Kondensatoren
Kondensator | 100nF | 0603 | 12 | Reichelt | X7R-G0603 100N | http://www.reichelt.de/Vielschicht-SMD-G0603/X7R-G0603-100N/3/index.html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
Kondensator | 220µF/35V | E 3.5-8 | 2 | Reichelt | RAD FR 220/35 | http://www.reichelt.de/RAD-FR-220-35/3/index.html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
Kondensator | 220µF/16V | E 2.5-6.3 | 2 | Reichelt | RAD FR 220/16 | http://www.reichelt.de/RAD-FR-220-16/3/index.html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
Kondensator | 470µF/16V | E 3.5-8 | 2 | Reichelt | RAD FR 470/16 | http://www.reichelt.de/RAD-FR-470-16/3/index.html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
Widerstände
Widerstand | 120 | 0805 | 4 | Conrad | 439249 – 62 | http://www.conrad.de/ce/de/product/439249/Dickschicht-Widerstand-120-SMD-0805-0125-W-1-100-ppm-Samsung-Electro-Mechanics-RC2012F1200CS-RC2012F121CS-1-St
Widerstand | 330 | 0805 | 2 | Conrad | 1208657 – 62 | http://www.conrad.de/ce/de/product/1208657/Dickschicht-Widerstand-330-SMD-0805-0125-W-1-100-ppmC-Royalohm-0805S8F3300T5E-1-St
Widerstand | 1000 | 0805 | 5 | Conrad | 440242 - 62 | http://www.conrad.de/ce/de/product/440242/Dickschicht-Widerstand-1-k-SMD-0805-0125-W-1-100-ppm-Samsung-Electro-Mechanics-RC2012F1001CS-RC2012F102CS-1-St
Widerstand | 1200 | 0805 | 1 | Conrad | 440327 - 62 | http://www.conrad.de/ce/de/product/440327/Dickschicht-Widerstand-12-k-SMD-0805-0125-W-1-100-ppm-Samsung-Electro-Mechanics-RC2012F1201CS-RC2012F122CS-1-St
Widerstand | 1800 | 0805 | 4 | Conrad | 1208677 - 62 | http://www.conrad.de/ce/de/product/1208677/Dickschicht-Widerstand-18-k-SMD-0805-0125-W-1-Royalohm-0805S8F1801T5E-1-St
Widerstand | 10000 | 0805 | 18 | Conrad | 439073 - 62 | http://www.conrad.de/ce/de/product/439073/Dickschicht-Widerstand-10-k-SMD-0805-0125-W-1-100-ppm-Samsung-Electro-Mechanics-RC2012F1002CS-RC2012F103CS-1-St
Lichtschranke
Fotodiode | IS471FE |  | 0 | Farnell | 9707840 | http://de.farnell.com/sharp/is471fe/photodiode-lichtdetektor/dp/9707840?ost=is471
Infrarot LED | LD 274-3 | 5mm | 0 | Reichelt | LD 274-3 | http://www.reichelt.de/LD-274-3/3/index.html?ACTION=3&LA=446&ARTICLE=65174&artnr=LD+274-3&SEARCH=ld274
Beagle Board Black | BeagleBoard Black | 2x46 | 1 | Farnell | 2422228 | http://de.farnell.com/element14/bbone-black-4g/beaglebone-black-rev-c-cortex/dp/2422228
IMU | Adafruit LSM9DS0 |  | 0 | RobotShop | RB-Ada-175 | http://www.robotshop.com/eu/en/adafruit-lsm9ds0-9dof-2000-sec-16g-imu.html
Motortreiber | High Power Motortreiber |  | 0 | robotikhardware.de | FEHI24V12 | http://www.shop.robotikhardware.de/shop/catalog/product_info.php?cPath=65&products_id=220
Maussensor LED | VISHAY TLWR7600 | - | 5 | Farnell | 4467814 | http://de.farnell.com/vishay-semiconductor/tlwr7600/led-red-1-35mm-1-47cd-634nm/dp/4467814?ost=TLWR7600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
