carpe-noctem-cassel/cnc-circuit-boards/eth2can/eth2can/bestellung-6fach-ohnereserve-v2.ods

Sheet: Bestellung
Bauteil | Wert | Preis | Stückzahl | Summe | Bestellnr
Kühlkörper | SK104 | 1,15 | 6 | 6,90 | V PR32/25,4
can controler | MCP2515-E/SO | 2,55 | 6 | 15,30 | MCP 2515-I/SO
Can Treiber | PCA82C250 | 1,20 | 6 | 7,20 | PCA 82C250
Diode | BY550 | 0,09 | 6 | 0,54 | 1N 4007
Fuse | FUSESH22,5A | 1,25 | 6 | 7,50 | SMD-HASF 1,0A
Kondensator | 100n | 0,05 | 96 | 4,90 | X7R-G0603 100N
Kondensator | 10n | 0,05 | 24 | 1,22 | X7R-G0603 10N
Kondensator | 10uF/35V | 0,04 | 6 | 0,25 | RAD 10/35
Kondensator | 22 p | 0,05 | 36 | 1,84 | NPO-G0603 22P
Kondensator | 220 uF / 25V | 0,07 | 6 | 0,43 | RAD 220/25
Kondensator | 66p -> 68p | 0,05 | 6 | 0,31 | NPO-G0603 68P
LED_ACT | red | 0,09 | 12 | 1,08 | SMD-LED 0805 RT
LED_ACT | green | 0,09 | 12 | 1,08 | SMD-LED 0805 GN
Quartz | 16 mhz | 0,24 | 12 | 2,88 | 16,0000-HC49U-S
Quartz | 20 mhz | 0,24 | 6 | 1,44 | 20,0000-HC49U-S
rs232 treiber | MAX3232CSE | 1,20 | 6 | 7,20 | MAX 202 CSE
uC | At Mega 128 | 8,05 | 6 | 48,30 | ATMEGA 128-16 TQ
Widerstand | 200 | 0,10 | 6 | 0,60 | SMD 1/4W 200
Widerstand | 10k | 0,10 | 6 | 0,60 | SMD-0805 10,0K
Widerstand | 1k | 0,10 | 6 | 0,60 | SMD-0805 1,00K
Widerstand | 150 | 0,10 | 30 | 3,00 | SMD-0805 150
Widerstand | 4k7 | 0,10 | 30 | 3,00 | SMD-0805 4,70K
CAN |  | 0,36 | 6 | 2,16 | AKL 182-04
COM |  | 0,28 | 6 | 1,68 | D-SUB BU 09EU
ETH |  | 0,62 | 6 | 3,72 | MEBP 8-8G
Spannungswandler | 78XXS | 0,36 | 6 | 2,16 | µA 78S05
ISP | MA05-2 | 0,22 | 4 | 0,88 | SL 2X25G 2,54
Stecker | CAN | 0,63 | 30 | 18,90 | AKL 169-04
Sicherung |  | 0,40 | 6 | 2,40 | SMD-SF 1,0A
X2 | AK500/2-H | 0,17 | 6 | 1,02 | AKL 230-02
Stecker X2 |  | 0,38 | 6 | 2,28 | AKL 249-02
sockel für PCA82C250 |  | 0,03 | 6 | 0,19 | GS 8
Jumper |  | 0,04 | 12 | 0,49 | JUMPER 2,54 SW
Sub-D Buchse |  | 0,46 | 0 | 0,00 | D-SUB BU 09FB
Sub-D Stecker |  | 0,46 | 0 | 0,00 | D-SUB ST 09FB
Sub-D Stecker |  | 0,08 | 6 | 0,50 | D-SUB ST 09
Sub-D Buchse |  | 0,10 | 6 | 0,60 | D-SUB BU 09
 |  |  |  | 153,14

Sheet: Sheet1
Part | Value | Package | Library
R10 | 0 | R0805 | rcl
R1 | 200 | R0805 | rcl
C12 | 100n | C0603 | rcl
C13 | 100n | C0603 | rcl
C15 | 100n | C0603 | rcl
C16 | 100n | C0603 | rcl
C24 | 100n | C0603 | rcl
C25 | 100n | C0603 | rcl
C26 | 100n | C0603 | rcl
C27 | 100n | C0603 | rcl
C30 | 100n | C0603 | rcl
C31 | 100n | C0603 | rcl
C32 | 100n | C0603 | rcl
C33 | 100n | C0603 | rcl
C34 | 100n | C0603 | rcl
C37 | 100n | C0603 | rcl
C38 | 100n | C0603 | rcl
C39 | 100n | C0603 | rcl
C40 | 100n | C0603 | rcl
C41 | 100n | C0603 | rcl
C42 | 100n | C0603 | rcl
C5 | 100n | C0603 | rcl
C6 | 100n | C0603 | rcl
C7 | 100n | C0603 | rcl
R11 | 10k | R0805 | rcl
R2 | 10k | R0805 | rcl
C14 | 10n | C0603 | rcl
C2 | 10n | C0603 | rcl
C3 | 10n | C0603 | rcl
C4 | 10n | C0603 | rcl
C11 | 10µF/35V | E2-5 | rcl
Q4 | 12MHz | HC49/S | crystal
Q1 | 16MHz | HC49U-V | crystal
Q3 | 16MHz | HC49U-V | crystal
R3 | 1k | R0805 | rcl
Q2 | 20MHz | HC49U-V | crystal
C10 | 220µF/25V | E3,5-8 | rcl
C28 | 22p | C0603 | rcl
C29 | 22p | C0603 | rcl
C35 | 22p | C0603 | rcl
C36 | 22p | C0603 | rcl
C8 | 22p | C0603 | rcl
C9 | 22p | C0603 | rcl
R13 | 27k | R0805 | rcl
C17 | 27p | C0603 | rcl
C18 | 27p | C0603 | rcl
R15 | 2k7 | R0805 | rcl
R16 | 2k7 | R0805 | rcl
R17 | 2k7 | R0805 | rcl
R18 | 2k7 | R0805 | rcl
R7 | 2k7 | R0805 | rcl
R12 | 4k7 | R0805 | rcl
R14 | 4k7 | R0805 | rcl
R20 | 4k7 | R0805 | rcl
R4 | 4k7 | R0805 | rcl
R5 | 4k7 | R0805 | rcl
R6 | 4k7 | R0805 | rcl
R8 | 4k7 | R0805 | rcl
R9 | 4k7 | R0805 | rcl
C1 | 66p | C0603 | rcl
IC8 | ATMega48 | TQFP32-08 | atmel
D2 | BY550 | DO27-15 | diode
F1 | FUSESH22,5A | SH22,5A | fuse
POWER_LED1 | green | LED3MM | led
IC1 | MAX3232CSE | SO16 | maxim
IC9 | MAX3232CSE | SO16 | maxim
IC4 | MCP2515-E/SO | SO18L | mcp2515
IC2 | MEGA128-A | TQFP64 | atmel
H1 | MOUNT-PAD-ROUND3.0 | 3,0-PAD | holes
H2 | MOUNT-PAD-ROUND3.0 | 3,0-PAD | holes
H3 | MOUNT-PAD-ROUND3.0 | 3,0-PAD | holes
H4 | MOUNT-PAD-ROUND3.0 | 3,0-PAD | holes
IC5 | PCA82C250 | DIL08 | micro-philips
ACT_LED | red | LED3MM | led
LED199 | red | LED3MM | led
U$1 | RTL8019AS | RTL8019AS | rtl8019as
KK1 | SK104 | SK104 | heatsink
LED3 | yellow | LED3MM | led
LINK_LED | yellow | LED3MM | led
CAN |  | 90-4 | con-weidmueller-sl35
COM |  | F09HP | con-subd
ETH |  | 557786-1 | con-amp
IC3 |  | 78XXS | v-reg
ISP |  | MA05-2 | con-lstb
ISP_48 |  | MA05-2 | con-lstb
JTAG |  | MA05-2 | con-lstb
U$2 |  | DIL16/12 | Realtek
X2 |  | AK500/2-H | con-ptr500
