carpe-noctem-cassel/cnc-circuit-boards/eth2can/eth2can/eth2can-0.1.0/eth2can.ods

Sheet: Teile
Bauteil | Wert | Preis | Stückzahl | Summe | Bestellnr | Link
Kühlkörper | SK104 | 1,15 | 1 | 1,15 | V PR32/25,4 | http://www.reichelt.de/?ARTICLE=35374
can controler | MCP2515-E/SO | 2,55 | 1 | 2,55 | MCP 2515-I/SO | http://www.reichelt.de/
Can Treiber | PCA82C250 | 1,2 | 1 | 1,2 | PCA 82C250 | http://www.reichelt.de/
Diode | BY550 | 0,09 | 1 | 0,09 | BY 550-50 | http://www.reichelt.de/
Ethernet Treiber | RTL8019AS |  | 1 | 0 |  | -
Fuse | FUSESH22,5A | 0,57 | 1 | 0,57 | PL 112100 | http://www.reichelt.de/
Kondensator | 100n | 0,05 | 22 | 1,12 | X7R-G0603 100N | http://www.reichelt.de/
Kondensator | 10n | 0,05 | 4 | 0,2 | X7R-G0603 10N | http://www.reichelt.de/
Kondensator | 10uF/35V | 0,04 | 1 | 0,04 | RAD 10/35 | http://www.reichelt.de/
Kondensator | 22 p | 0,05 | 6 | 0,31 | NPO-G0603 22P | http://www.reichelt.de/
Kondensator | 220 uF / 25V | 0,07 | 1 | 0,07 | RAD 220/25 | http://www.reichelt.de/
Kondensator | 27p / 22p | 0,05 | 2 | 0,1 | NPO-G0603 22P | http://www.reichelt.de/
Kondensator | 66p -> 68p | 0,05 | 1 | 0,05 | NPO-G0603 68P | http://www.reichelt.de/
LED 199 | red | 0,09 | 1 | 0,09 | LS 336K | http://www.reichelt.de/
LED Act | red | 0,09 | 1 | 0,09 | LS 336K | http://www.reichelt.de/
LED_ACT | yellow | 0,09 | 1 | 0,09 | LY 336K | http://www.reichelt.de/
LED3 | yellow | 0,09 | 1 | 0,09 | LY 336K | http://www.reichelt.de/
Power LED 1 | green | 0,07 | 1 | 0,07 | LV 543C | http://www.reichelt.de/
Quartz | 12 mhz | 0,24 | 1 | 0,24 | 12,0000-HC49U-S | http://www.reichelt.de/
Quartz | 16 mhz | 0,24 | 2 | 0,48 | 16,0000-HC49U-S | http://www.reichelt.de/
Quartz | 20 mhz | 0,24 | 1 | 0,24 | 20,0000-HC49U-S | http://www.reichelt.de/
rs232 treiber | MAX3232CSE | 3,4 | 2 | 6,8 | MAX 3232 CSE | http://www.reichelt.de/
uC | At Mega 128 | 8,05 | 1 | 8,05 | ATMEGA 128-16 TQ | http://www.reichelt.de/
uC | At Mega 48 | 1,45 | 1 | 1,45 | ATMEGA 48-20 AU | http://www.reichelt.de/
Widerstand | 0 | 0,1 | 1 | 0,1 | SMD 1/4W 0,0 | http://www.reichelt.de/
Widerstand | 200 | 0,1 | 1 | 0,1 | SMD 1/4W 100 | http://www.reichelt.de/
Widerstand | 10k | 0,1 | 2 | 0,2 | SMD 1/4W 10K | http://www.reichelt.de/
Widerstand | 1k | 0,1 | 1 | 0,1 | SMD 1/4W 1,0K | http://www.reichelt.de/
Widerstand | 27 k | 0,1 | 1 | 0,1 | SMD 1/4W 27K | http://www.reichelt.de/
Widerstand | 2k7 | 0,1 | 4 | 0,4 | SMD 1/4W 2,7K | http://www.reichelt.de/
Widerstand | 4k7 | 0,1 | 8 | 0,8 | SMD 1/4W 2,4K | http://www.reichelt.de/
CAN??? | CAN??? | 0,34 | 1 | 0,34 | AKL 382-04 | http://www.reichelt.de/
COM??? | ??? | 0,28 | 1 | 0,28 | D-SUB BU 09EU | http://www.reichelt.de/
ETH?? | ??? | 0,62 | 1 | 0,62 | MEBP 8-8G | http://www.reichelt.de/
IC3 | 78XXS | 0,36 | 1 | 0,36 | µA 78S05 | http://www.reichelt.de/
ISP | MA05-2 | 0,22 | 1 | 0,22 | SL 2X17G 2,54 | http://www.reichelt.de/
ISP_48 | MA05-2 | 0,22 | 1 | 0,22 | SL 2X17G 2,54 | http://www.reichelt.de/
JTAG | MA05-2 | 0,22 | 1 | 0,22 | SL 2X17G 2,54 | http://www.reichelt.de/
U$2 | DIL16/12 | 0,3 | 1 | 0,3 |  | Galwanische Trennung
Stecker | CAN | 0,63 | 2 | 1,26 | AKL 369-04 | http://www.reichelt.de/
Sicherung |  | 0,07 | 1 | 0,07 | FLINK 1,0A | http://www.reichelt.de/
X2 -> Diode | AK500/2-H | 0,2 | 1 | 0,2 | 1N 4007 | http://www.reichelt.de/
 |  |  | 86 | 31,04

Sheet: Sheet1
Part | Value | Package | Library
R10 | 0 | R0805 | rcl
R1 | 200 | R0805 | rcl
C12 | 100n | C0603 | rcl
C13 | 100n | C0603 | rcl
C15 | 100n | C0603 | rcl
C16 | 100n | C0603 | rcl
C24 | 100n | C0603 | rcl
C25 | 100n | C0603 | rcl
C26 | 100n | C0603 | rcl
C27 | 100n | C0603 | rcl
C30 | 100n | C0603 | rcl
C31 | 100n | C0603 | rcl
C32 | 100n | C0603 | rcl
C33 | 100n | C0603 | rcl
C34 | 100n | C0603 | rcl
C37 | 100n | C0603 | rcl
C38 | 100n | C0603 | rcl
C39 | 100n | C0603 | rcl
C40 | 100n | C0603 | rcl
C41 | 100n | C0603 | rcl
C42 | 100n | C0603 | rcl
C5 | 100n | C0603 | rcl
C6 | 100n | C0603 | rcl
C7 | 100n | C0603 | rcl
R11 | 10k | R0805 | rcl
R2 | 10k | R0805 | rcl
C14 | 10n | C0603 | rcl
C2 | 10n | C0603 | rcl
C3 | 10n | C0603 | rcl
C4 | 10n | C0603 | rcl
C11 | 10µF/35V | E2-5 | rcl
Q4 | 12MHz | HC49/S | crystal
Q1 | 16MHz | HC49U-V | crystal
Q3 | 16MHz | HC49U-V | crystal
R3 | 1k | R0805 | rcl
Q2 | 20MHz | HC49U-V | crystal
C10 | 220µF/25V | E3,5-8 | rcl
C28 | 22p | C0603 | rcl
C29 | 22p | C0603 | rcl
C35 | 22p | C0603 | rcl
C36 | 22p | C0603 | rcl
C8 | 22p | C0603 | rcl
C9 | 22p | C0603 | rcl
R13 | 27k | R0805 | rcl
C17 | 27p | C0603 | rcl
C18 | 27p | C0603 | rcl
R15 | 2k7 | R0805 | rcl
R16 | 2k7 | R0805 | rcl
R17 | 2k7 | R0805 | rcl
R18 | 2k7 | R0805 | rcl
R7 | 2k7 | R0805 | rcl
R12 | 4k7 | R0805 | rcl
R14 | 4k7 | R0805 | rcl
R20 | 4k7 | R0805 | rcl
R4 | 4k7 | R0805 | rcl
R5 | 4k7 | R0805 | rcl
R6 | 4k7 | R0805 | rcl
R8 | 4k7 | R0805 | rcl
R9 | 4k7 | R0805 | rcl
C1 | 66p | C0603 | rcl
IC8 | ATMega48 | TQFP32-08 | atmel
D2 | BY550 | DO27-15 | diode
F1 | FUSESH22,5A | SH22,5A | fuse
POWER_LED1 | green | LED3MM | led
IC1 | MAX3232CSE | SO16 | maxim
IC9 | MAX3232CSE | SO16 | maxim
IC4 | MCP2515-E/SO | SO18L | mcp2515
IC2 | MEGA128-A | TQFP64 | atmel
H1 | MOUNT-PAD-ROUND3.0 | 3,0-PAD | holes
H2 | MOUNT-PAD-ROUND3.0 | 3,0-PAD | holes
H3 | MOUNT-PAD-ROUND3.0 | 3,0-PAD | holes
H4 | MOUNT-PAD-ROUND3.0 | 3,0-PAD | holes
IC5 | PCA82C250 | DIL08 | micro-philips
ACT_LED | red | LED3MM | led
LED199 | red | LED3MM | led
U$1 | RTL8019AS | RTL8019AS | rtl8019as
KK1 | SK104 | SK104 | heatsink
LED3 | yellow | LED3MM | led
LINK_LED | yellow | LED3MM | led
CAN |  | 90-4 | con-weidmueller-sl35
COM |  | F09HP | con-subd
ETH |  | 557786-1 | con-amp
IC3 |  | 78XXS | v-reg
ISP |  | MA05-2 | con-lstb
ISP_48 |  | MA05-2 | con-lstb
JTAG |  | MA05-2 | con-lstb
U$2 |  | DIL16/12 | Realtek
X2 |  | AK500/2-H | con-ptr500
