carpe-noctem-cassel/cnc-circuit-boards/eth2can/eth2can/eth2can-1.0.0/bestellung.ods

Sheet: Bestellung
Bauteil | Wert | Preis | Stückzahl | Summe | Bestellnr
Kühlkörper | SK104 | 1,15 | 3 | 3,45 | V PR32/25,4
can controler | MCP2515-E/SO | 2,55 | 8 | 20,40 | MCP 2515-I/SO | vorher Anzahl 2
Can Treiber | PCA82C250 | 1,20 | 2 | 2,40 | PCA 82C250
Diode | BY550 | 0,09 | 2 | 0,18 | 1N 4007
Fuse | FUSESH22,5A | 0,57 | 2 | 1,14 | PL 112100
Kondensator | 100n | 0,05 | 50 | 2,55 | X7R-G0603 100N
Kondensator | 10n | 0,05 | 10 | 0,51 | X7R-G0603 10N
Kondensator | 10uF/35V | 0,04 | 4 | 0,16 | RAD 10/35
Kondensator | 22 p | 0,05 | 20 | 1,02 | NPO-G0603 22P
Kondensator | 220 uF / 25V | 0,07 | 2 | 0,14 | RAD 220/25
Kondensator | 66p -> 68p | 0,05 | 2 | 0,10 | NPO-G0603 68P
LED 199 | red | 0,09 | 4 | 0,36 | LS 336K
LED_ACT | yellow | 0,09 | 4 | 0,36 | LY 336K
Power LED 1 | green | 0,07 | 2 | 0,14 | LV 543C
Quartz | 12 mhz | 0,24 | 2 | 0,48 | 12,0000-HC49U-S
Quartz | 16 mhz | 0,24 | 4 | 0,96 | 16,0000-HC49U-S
Quartz | 20 mhz | 0,24 | 2 | 0,48 | 20,0000-HC49U-S
rs232 treiber | MAX3232CSE | 1,20 | 4 | 4,80 | MAX 202 CSE
uC | At Mega 128 | 8,05 | 4 | 32,20 | ATMEGA 128-16 TQ
uC | At Mega 48 | 1,45 | 2 | 2,90 | ATMEGA 48-20 AU
 |  | 0,10 | 2 | 0,20 | SMD-0805 180
Widerstand | 200 | 0,10 | 2 | 0,20 | SMD 1/4W 200
Widerstand | 10k | 0,10 | 4 | 0,40 | SMD-0805 10,0K
Widerstand | 1k | 0,10 | 2 | 0,20 | SMD-0805 1,00K
Widerstand | 27 k | 0,10 | 2 | 0,20 | SMD-0805 27,0K
Widerstand | 2k7 | 0,10 | 10 | 1,00 | SMD-0805 2,70K | vorher Anzahl 8
Widerstand | 4k7 | 0,10 | 16 | 1,60 | SMD-0805 4,70K
CAN??? | CAN??? | 0,36 | 5 | 1,80 | AKL 182-04
COM??? | ??? | 0,28 | 2 | 0,56 | D-SUB BU 09EU
ETH?? | ??? | 0,62 | 2 | 1,24 | MEBP 8-8G
IC3 | 78XXS | 0,36 | 2 | 0,72 | µA 78S05
ISP | MA05-2 | 0,22 | 2 | 0,44 | SL 2X25G 2,54
Stecker | CAN | 0,63 | 5 | 3,15 | AKL 169-04
Sicherung |  | 0,07 | 10 | 0,72 | FLINK 1,0A
X2 | AK500/2-H | 0,17 | 2 | 0,34 | AKL 230-02 | vorher: akl 220-02 (ungewinkelt)
Stecker X2 |  | 0,38 | 2 | 0,76 | AKL 249-02
sockel für PCA82C250 |  | 0,03 | 4 | 0,12 | GS 8 | neu hinzu
Sub-D Buchse |  | 0,46 | 5 | 2,30 | D-SUB BU 09FB
Sub-D Stecker |  | 0,46 | 5 | 2,30 | D-SUB ST 09FB
Sub-D Stecker |  | 0,08 | 5 | 0,42 | D-SUB ST 09
Sub-D Buchse |  | 0,10 | 5 | 0,50 | D-SUB BU 09
Telefonkabel |  | 6,10 | 1 | 6,10 | YSTY 2X2-25
SMD Sicherung |  | 0,40 | 4 | 1,60 | SMD-SF 0,5A
 |  | 0,82 | 1 | 0,82 | SCHWAMM
 |  | 4,60 | 2 | 9,20 | ATMEGA 32-16 TQ
 |  |  |  | 111,63

Sheet: Sheet1
Part | Value | Package | Library
R10 | 0 | R0805 | rcl
R1 | 200 | R0805 | rcl
C12 | 100n | C0603 | rcl
C13 | 100n | C0603 | rcl
C15 | 100n | C0603 | rcl
C16 | 100n | C0603 | rcl
C24 | 100n | C0603 | rcl
C25 | 100n | C0603 | rcl
C26 | 100n | C0603 | rcl
C27 | 100n | C0603 | rcl
C30 | 100n | C0603 | rcl
C31 | 100n | C0603 | rcl
C32 | 100n | C0603 | rcl
C33 | 100n | C0603 | rcl
C34 | 100n | C0603 | rcl
C37 | 100n | C0603 | rcl
C38 | 100n | C0603 | rcl
C39 | 100n | C0603 | rcl
C40 | 100n | C0603 | rcl
C41 | 100n | C0603 | rcl
C42 | 100n | C0603 | rcl
C5 | 100n | C0603 | rcl
C6 | 100n | C0603 | rcl
C7 | 100n | C0603 | rcl
R11 | 10k | R0805 | rcl
R2 | 10k | R0805 | rcl
C14 | 10n | C0603 | rcl
C2 | 10n | C0603 | rcl
C3 | 10n | C0603 | rcl
C4 | 10n | C0603 | rcl
C11 | 10µF/35V | E2-5 | rcl
Q4 | 12MHz | HC49/S | crystal
Q1 | 16MHz | HC49U-V | crystal
Q3 | 16MHz | HC49U-V | crystal
R3 | 1k | R0805 | rcl
Q2 | 20MHz | HC49U-V | crystal
C10 | 220µF/25V | E3,5-8 | rcl
C28 | 22p | C0603 | rcl
C29 | 22p | C0603 | rcl
C35 | 22p | C0603 | rcl
C36 | 22p | C0603 | rcl
C8 | 22p | C0603 | rcl
C9 | 22p | C0603 | rcl
R13 | 27k | R0805 | rcl
C17 | 27p | C0603 | rcl
C18 | 27p | C0603 | rcl
R15 | 2k7 | R0805 | rcl
R16 | 2k7 | R0805 | rcl
R17 | 2k7 | R0805 | rcl
R18 | 2k7 | R0805 | rcl
R7 | 2k7 | R0805 | rcl
R12 | 4k7 | R0805 | rcl
R14 | 4k7 | R0805 | rcl
R20 | 4k7 | R0805 | rcl
R4 | 4k7 | R0805 | rcl
R5 | 4k7 | R0805 | rcl
R6 | 4k7 | R0805 | rcl
R8 | 4k7 | R0805 | rcl
R9 | 4k7 | R0805 | rcl
C1 | 66p | C0603 | rcl
IC8 | ATMega48 | TQFP32-08 | atmel
D2 | BY550 | DO27-15 | diode
F1 | FUSESH22,5A | SH22,5A | fuse
POWER_LED1 | green | LED3MM | led
IC1 | MAX3232CSE | SO16 | maxim
IC9 | MAX3232CSE | SO16 | maxim
IC4 | MCP2515-E/SO | SO18L | mcp2515
IC2 | MEGA128-A | TQFP64 | atmel
H1 | MOUNT-PAD-ROUND3.0 | 3,0-PAD | holes
H2 | MOUNT-PAD-ROUND3.0 | 3,0-PAD | holes
H3 | MOUNT-PAD-ROUND3.0 | 3,0-PAD | holes
H4 | MOUNT-PAD-ROUND3.0 | 3,0-PAD | holes
IC5 | PCA82C250 | DIL08 | micro-philips
ACT_LED | red | LED3MM | led
LED199 | red | LED3MM | led
U$1 | RTL8019AS | RTL8019AS | rtl8019as
KK1 | SK104 | SK104 | heatsink
LED3 | yellow | LED3MM | led
LINK_LED | yellow | LED3MM | led
CAN |  | 90-4 | con-weidmueller-sl35
COM |  | F09HP | con-subd
ETH |  | 557786-1 | con-amp
IC3 |  | 78XXS | v-reg
ISP |  | MA05-2 | con-lstb
ISP_48 |  | MA05-2 | con-lstb
JTAG |  | MA05-2 | con-lstb
U$2 |  | DIL16/12 | Realtek
X2 |  | AK500/2-H | con-ptr500
