carpe-noctem-cassel/cnc-circuit-boards/powerSwitch/pcb/CNC-PowerSwitch-2016-v0.96.brd

## EAGLE design powerSwitch/pcb/CNC-PowerSwitch-2016-v0.96.brd (2017-02-09)

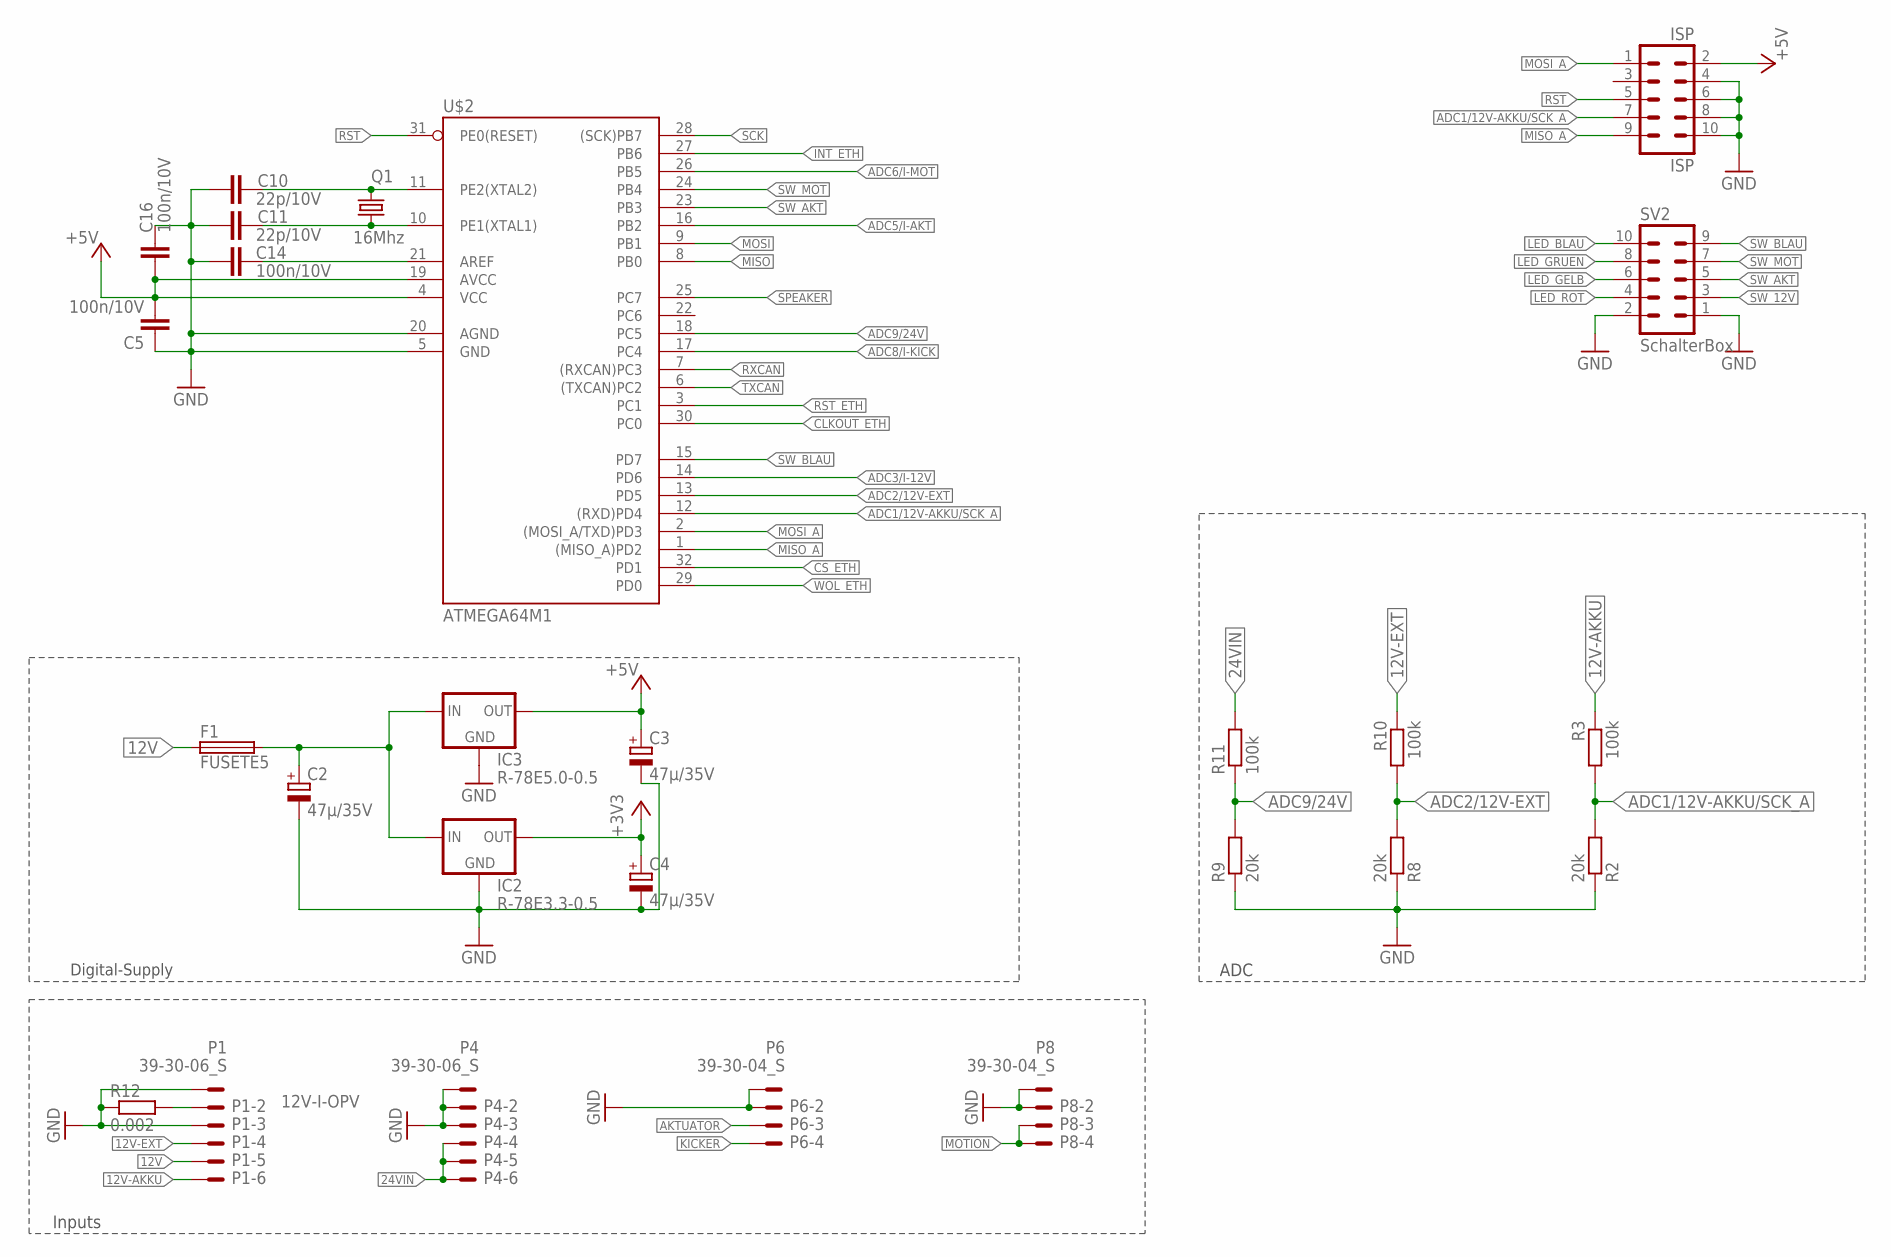
[picture p35: schematic CNC-PowerSwitch-2016-v0.96.sch, sheet 1]

Parts:
C2, C3, C4: 47µ/35V; PANASONIC_D
C5, C14, C16: 100n/10V; C0603
C10, C11: 22p/10V; C0603
F1: FUSETE5; TE5
IC2: R-78E3.3-0.5; SIP3
IC3: R-78E5.0-0.5; SIP3
ISP: ISP; ML10
P1, P4: 39-30-06_S; 39-30-?06?
P6, P8: 39-30-04_S; 39-30-?04?
Q1: 16Mhz; HC49UP
R2, R8, R9: 20k; R0805
R3, R10, R11: 100k; R0805
R12: 0.002; R2512
SV2: SchalterBox; ML10L
U$2: ATMEGA64M1; TQFP32-08

Connections:
12V: F1.1, P1.5; also elsewhere on the board
12V-AKKU: P1.6, R3.1; also elsewhere on the board
12V-EXT: P1.4, R10.1; also elsewhere on the board
12V-I-OPV: P1.2, R12.2; also elsewhere on the board
24VIN: P4.4, P4.5, P4.6, R11.2; also elsewhere on the board
+3V3: C4.+, IC2.3 (OUT); also elsewhere on the board
+5V: C3.+, C5.2, C16.1, IC3.3 (OUT), ISP.2, U$2.4 (VCC), U$2.19 (AVCC); also elsewhere on the board
ADC1/12V-AKKU/SCK_A: ISP.7, R2.2, R3.2, U$2.12 ((RXD)PD4)
ADC2/12V-EXT: R8.2, R10.2, U$2.13 (PD5)
ADC3/I-12V: U$2.14 (PD6); also elsewhere on the board
ADC5/I-AKT: U$2.16 (PB2); also elsewhere on the board
ADC6/I-MOT: U$2.26 (PB5); also elsewhere on the board
ADC8/I-KICK: U$2.17 (PC4); also elsewhere on the board
ADC9/24V: R9.2, R11.1, U$2.18 (PC5)
AKTUATOR: P6.3; also elsewhere on the board
CLKOUT_ETH: U$2.30 (PC0); also elsewhere on the board
CS_ETH: U$2.32 (PD1); also elsewhere on the board
GND: C2.-, C3.-, C4.-, C5.1, C10.1, C11.1, C14.1, C16.2, IC2.2 (GND), IC3.2 (GND), ISP.4, ISP.6, ISP.8, ISP.10, P1.1, P1.3, P4.1, P4.2, P4.3, P6.1, P6.2, P8.1, P8.2, R2.1, R8.1, R9.1, R12.1, SV2.1, SV2.2, U$2.5 (GND), U$2.20 (AGND); also elsewhere on the board
INT_ETH: U$2.27 (PB6); also elsewhere on the board
KICKER: P6.4; also elsewhere on the board
LED_BLAU: SV2.10; also elsewhere on the board
LED_GELB: SV2.6; also elsewhere on the board
LED_GRUEN: SV2.8; also elsewhere on the board
LED_ROT: SV2.4; also elsewhere on the board
MISO: U$2.8 (PB0); also elsewhere on the board
MISO_A: ISP.9, U$2.1 ((MISO_A)PD2)
MOSI: U$2.9 (PB1); also elsewhere on the board
MOSI_A: ISP.1, U$2.2 ((MOSI_A/TXD)PD3)
MOTION: P8.3, P8.4; also elsewhere on the board
unnamed: C10.2, Q1.2, U$2.11 (PE2(XTAL2))
unnamed: C11.2, Q1.1, U$2.10 (PE1(XTAL1))
unnamed: C14.2, U$2.21 (AREF)
unnamed: C2.+, F1.2, IC2.1 (IN), IC3.1 (IN)
RST: ISP.5, U$2.31 (PE0(RESET))
RST_ETH: U$2.3 (PC1); also elsewhere on the board
RXCAN: U$2.7 ((RXCAN)PC3); also elsewhere on the board
SCK: U$2.28 ((SCK)PB7); also elsewhere on the board
SPEAKER: U$2.25 (PC7); also elsewhere on the board
SW_12V: SV2.3; also elsewhere on the board
SW_AKT: SV2.5, U$2.23 (PB3); also elsewhere on the board
SW_BLAU: SV2.9, U$2.15 (PD7)
SW_MOT: SV2.7, U$2.24 (PB4); also elsewhere on the board
TXCAN: U$2.6 ((TXCAN)PC2); also elsewhere on the board
WOL_ETH: U$2.29 (PD0); also elsewhere on the board

Notes on the sheet:
Inputs
ADC
Digital-Supply
