carpe-noctem-cassel/cnc-circuit-boards/powerSwitch/pcb/CNC-PowerSwitch-2016-v0.96.brd

## EAGLE design powerSwitch/pcb/CNC-PowerSwitch-2016-v0.96.brd (continued)

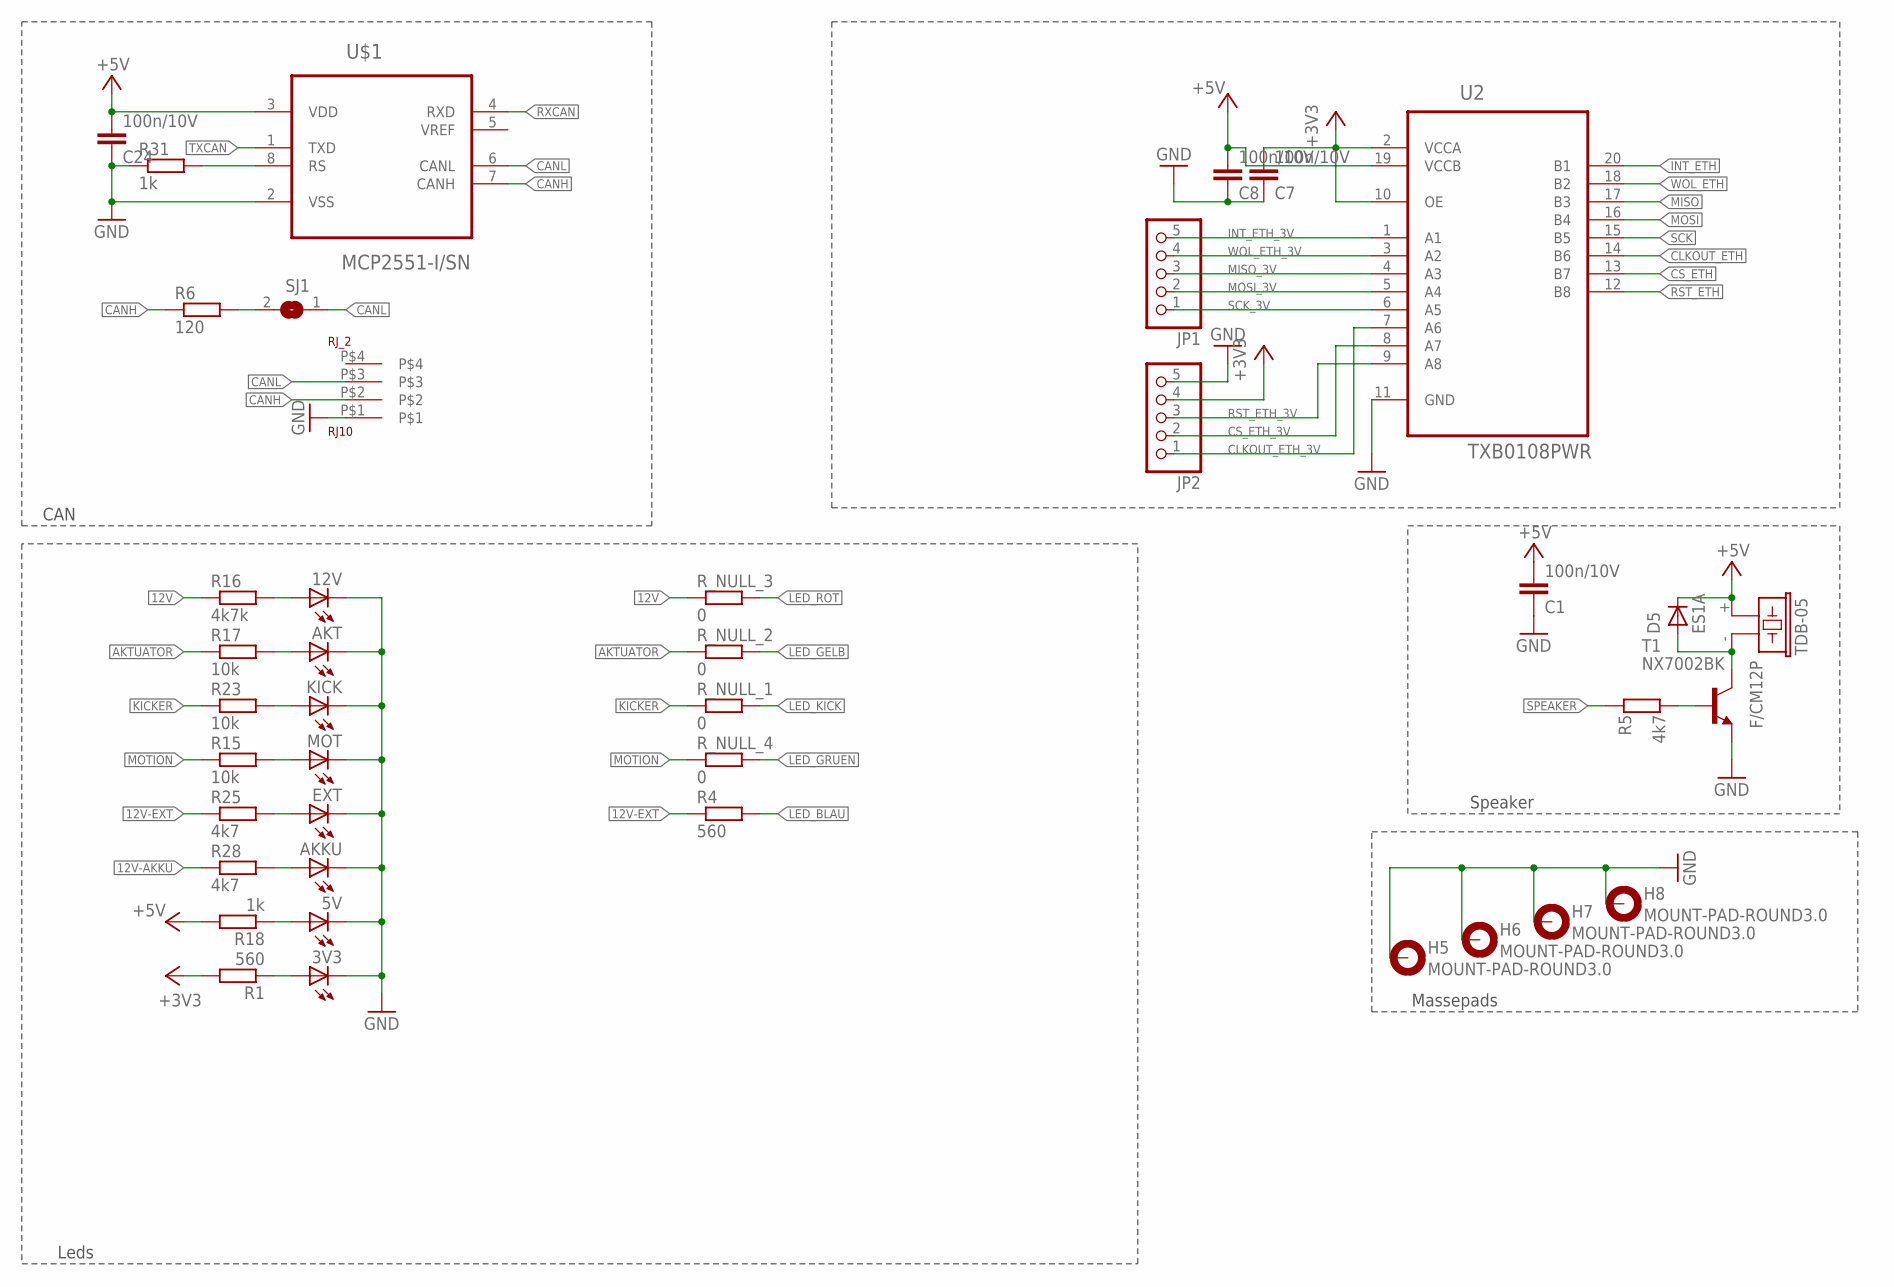
[picture p36: schematic CNC-PowerSwitch-2016-v0.96.sch, sheet 2]

Parts:
3V3, 5V, 12V: LEDCHIPLED_0805; CHIPLED_0805
AKKU: LEDCHIPLED_0805; CHIPLED_0805
AKT: LEDCHIPLED_0805; CHIPLED_0805
C1, C7, C8, C24: 100n/10V; C0603
D5: ES1A; SMA-DO214AC
EXT: LEDCHIPLED_0805; CHIPLED_0805
H5, H6, H7, H8: MOUNT-PAD-ROUND3.0; 3,0-PAD
JP1, JP2: PINHD-1X5; 1X05
KICK: LEDCHIPLED_0805; CHIPLED_0805
MOT: LEDCHIPLED_0805; CHIPLED_0805
R1, R4: 560; R0805
R5, R25, R28: 4k7; R0805
R6: 120; M0805
R15, R17, R23: 10k; R0805
R16: 4k7k; R0805
R18, R31: 1k; R0805
RJ_2: RJ10
R_NULL_1, R_NULL_2, R_NULL_3, R_NULL_4: 0; R0402
SJ1: SJ
T1: NX7002BK; SOT23
TDB-05: F/CM12P
U2: TXB0108PWR; SOP65P640X120-20N
U$1: MCP2551-I/SN; SOIC127P600X175-8N

Connections:
12V: R16.1, R_NULL_3.1; also elsewhere on the board
12V-AKKU: R28.1; also elsewhere on the board
12V-EXT: R4.1, R25.1; also elsewhere on the board
+3V3: C7.2, JP2.4, R1.2, U2.2 (VCCA), U2.10 (OE); also elsewhere on the board
+5V: C1.2, C8.2, C24.2, D5.K (C), R18.2, TDB-05.+ (1), U2.19 (VCCB), U$1.3 (VDD); also elsewhere on the board
AKTUATOR: R17.1, R_NULL_2.1; also elsewhere on the board
CANH: R6.1, RJ_2.P$2, U$1.7 (CANH)
CANL: RJ_2.P$3, SJ1.1, U$1.6 (CANL)
CLKOUT_ETH: U2.14 (B6); also elsewhere on the board
CLKOUT_ETH_3V: JP2.1, U2.7 (A6)
CS_ETH: U2.13 (B7); also elsewhere on the board
CS_ETH_3V: JP2.2, U2.8 (A7)
GND: 3V3.C, 5V.C, 12V.C, AKKU.C, AKT.C, C1.1, C7.1, C8.1, C24.1, EXT.C, H5.B3,0, H6.B3,0, H7.B3,0, H8.B3,0, JP2.5, KICK.C, MOT.C, R31.1, RJ_2.P$1, T1.2 (E), U2.11 (GND), U$1.2 (VSS); also elsewhere on the board
INT_ETH: U2.20 (B1); also elsewhere on the board
INT_ETH_3V: JP1.5, U2.1 (A1)
KICKER: R23.1, R_NULL_1.1; also elsewhere on the board
LED_BLAU: R4.2; also elsewhere on the board
LED_GELB: R_NULL_2.2; also elsewhere on the board
LED_GRUEN: R_NULL_4.2; also elsewhere on the board
LED_KICK: R_NULL_1.2
LED_ROT: R_NULL_3.2; also elsewhere on the board
MISO: U2.17 (B3); also elsewhere on the board
MISO_3V: JP1.3, U2.4 (A3)
MOSI: U2.16 (B4); also elsewhere on the board
MOSI_3V: JP1.2, U2.5 (A4)
MOTION: R15.1, R_NULL_4.1; also elsewhere on the board
unnamed: R5.2, T1.1 (B)
unnamed: EXT.A, R25.2
unnamed: KICK.A, R23.2
unnamed: 3V3.A, R1.1
unnamed: R31.2, U$1.8 (RS)
unnamed: R6.2, SJ1.2
unnamed: D5.A, T1.3 (C), TDB-05.- (2)
unnamed: AKKU.A, R28.2
unnamed: 12V.A, R16.2
unnamed: AKT.A, R17.2
unnamed: MOT.A, R15.2
unnamed: 5V.A, R18.1
RST_ETH: U2.12 (B8); also elsewhere on the board
RST_ETH_3V: JP2.3, U2.9 (A8)
RXCAN: U$1.4 (RXD); also elsewhere on the board
SCK: U2.15 (B5); also elsewhere on the board
SCK_3V: JP1.1, U2.6 (A5)
SPEAKER: R5.1; also elsewhere on the board
TXCAN: U$1.1 (TXD); also elsewhere on the board
WOL_ETH: U2.18 (B2); also elsewhere on the board
WOL_ETH_3V: JP1.4, U2.3 (A2)

Notes on the sheet:
CAN
Speaker
Massepads
Leds

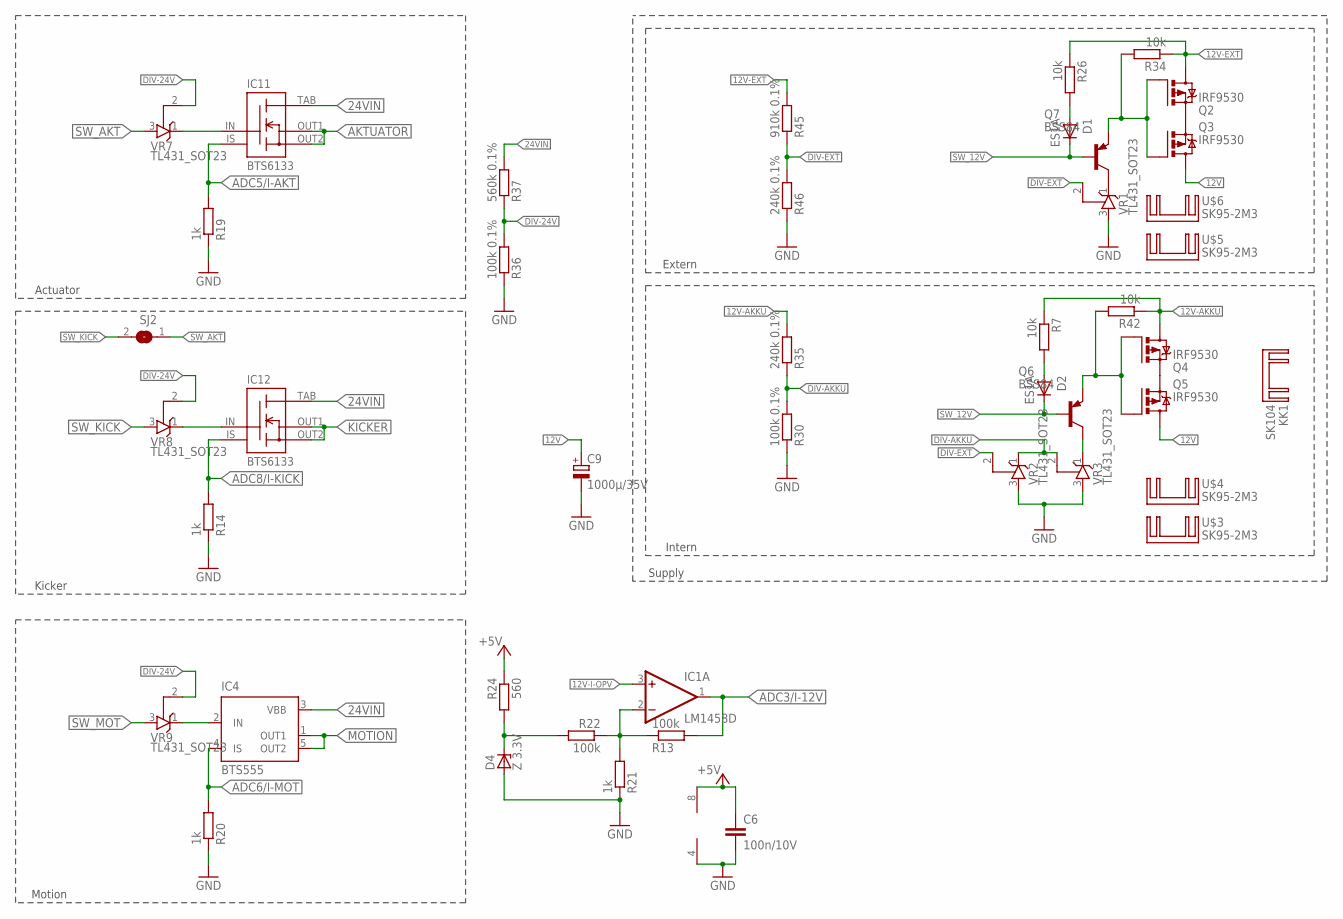
[picture p37: schematic CNC-PowerSwitch-2016-v0.96.sch, sheet 3]

Parts:
C6: 100n/10V; C0603
C9: 1000µ/35V; E5-10,5
D1, D2: ES1A; SMA-DO214AC
D4: Z 3.3V; SOT23
IC1: LM1458D; SO08
IC4: BTS555; TO220-51
IC11, IC12: BTS6133; TO252-51
KK1: SK104
Q2, Q3, Q4, Q5: IRF9530; TO220BV
Q6, Q7: BSS84; SOT23-BEC
R7, R26, R34, R42: 10k; R0805
R13, R22: 100k; R0805
R14, R19, R20, R21: 1k; R0805
R24: 560; R0805
R30, R36: 100k 0.1%; R0805
R35, R46: 240k 0.1%; R0805
R37: 560k 0.1%; R0805
R45: 910k 0.1%; R0805
SJ2: SJ
U$3, U$4, U$5, U$6: SK95-2M3
VR1, VR2, VR3, VR7, VR8, VR9: TL431_SOT23; SOT23

Connections:
12V: C9.+, Q3.D, Q5.D; also elsewhere on the board
12V-AKKU: Q4.D, R7.1, R35.2, R42.1; also elsewhere on the board
12V-EXT: Q2.D, R26.1, R34.1, R45.2; also elsewhere on the board
12V-I-OPV: IC1.3 (+IN); also elsewhere on the board
24VIN: IC4.3 (VBB), IC11.TAB (VBB), IC12.TAB (VBB), R37.2; also elsewhere on the board
+5V: C6.1, IC1.8 (V+), R24.1; also elsewhere on the board
ADC3/I-12V: IC1.1 (OUT), R13.2; also elsewhere on the board
ADC5/I-AKT: IC11.IS, R19.2; also elsewhere on the board
ADC6/I-MOT: IC4.4 (IS), R20.2; also elsewhere on the board
ADC8/I-KICK: IC12.IS, R14.2; also elsewhere on the board
AKTUATOR: IC11.OUT1 (OUT), IC11.OUT2 (OUT); also elsewhere on the board
DIV-24V: R36.2, R37.1, VR7.2 (R), VR8.2 (R), VR9.2 (R)
DIV-AKKU: R30.2, R35.1, VR2.1 (C), VR3.2 (R)
DIV-EXT: R45.1, R46.2, VR1.2 (R), VR2.2 (R)
GND: C6.2, C9.-, D4.1 (A), IC1.4 (V-), R14.1, R19.1, R20.1, R21.1, R30.1, R36.1, R46.1, VR1.3 (A), VR2.3 (A), VR3.3 (A); also elsewhere on the board
KICKER: IC12.OUT1 (OUT), IC12.OUT2 (OUT); also elsewhere on the board
MOTION: IC4.1 (OUT1), IC4.5 (OUT2); also elsewhere on the board
unnamed: Q7.C, VR1.1 (C)
unnamed: Q6.C, VR3.1 (C)
unnamed: D2.A, R7.2
unnamed: D1.A, R26.2
unnamed: IC1.2 (-IN), R13.1, R21.2, R22.1
unnamed: D4.3 (C), R22.2, R24.2
unnamed: Q2.S, Q3.S
unnamed: Q4.G, Q5.G, Q6.E, R42.2
unnamed: Q4.S, Q5.S
unnamed: IC12.IN, VR8.1 (C)
unnamed: IC4.2 (IN), VR9.1 (C)
unnamed: IC11.IN, VR7.1 (C)
unnamed: Q2.G, Q3.G, Q7.E, R34.2
SW_12V: D1.K (C), D2.K (C), Q6.B, Q7.B; also elsewhere on the board
SW_AKT: SJ2.1, VR7.3 (A); also elsewhere on the board
SW_KICK: SJ2.2, VR8.3 (A)
SW_MOT: VR9.3 (A); also elsewhere on the board

Notes on the sheet:
Intern
Extern
Supply
Motion
Kicker
Actuator

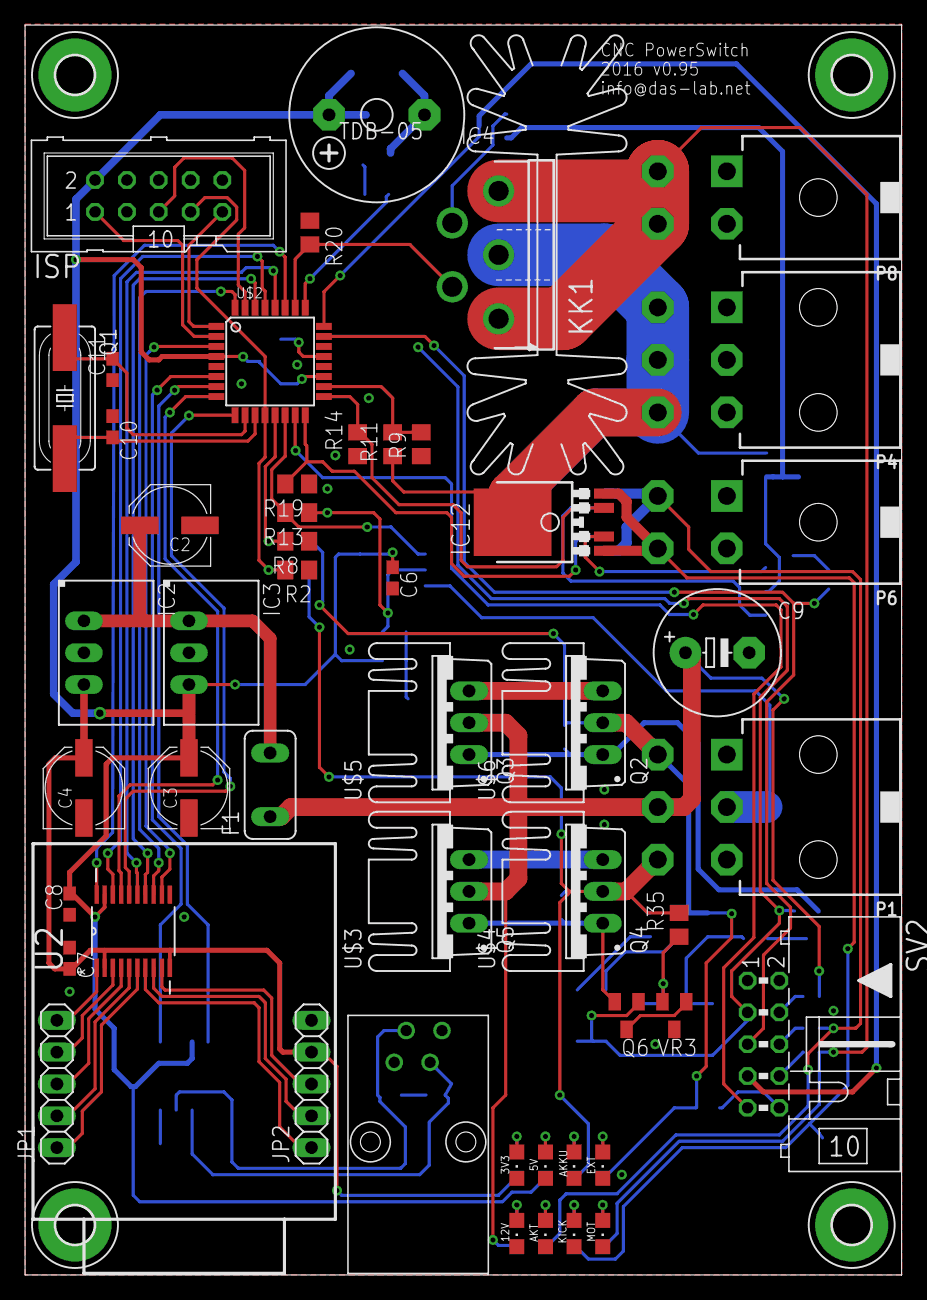
[picture p38: board CNC-PowerSwitch-2016-v0.96.brd from above]

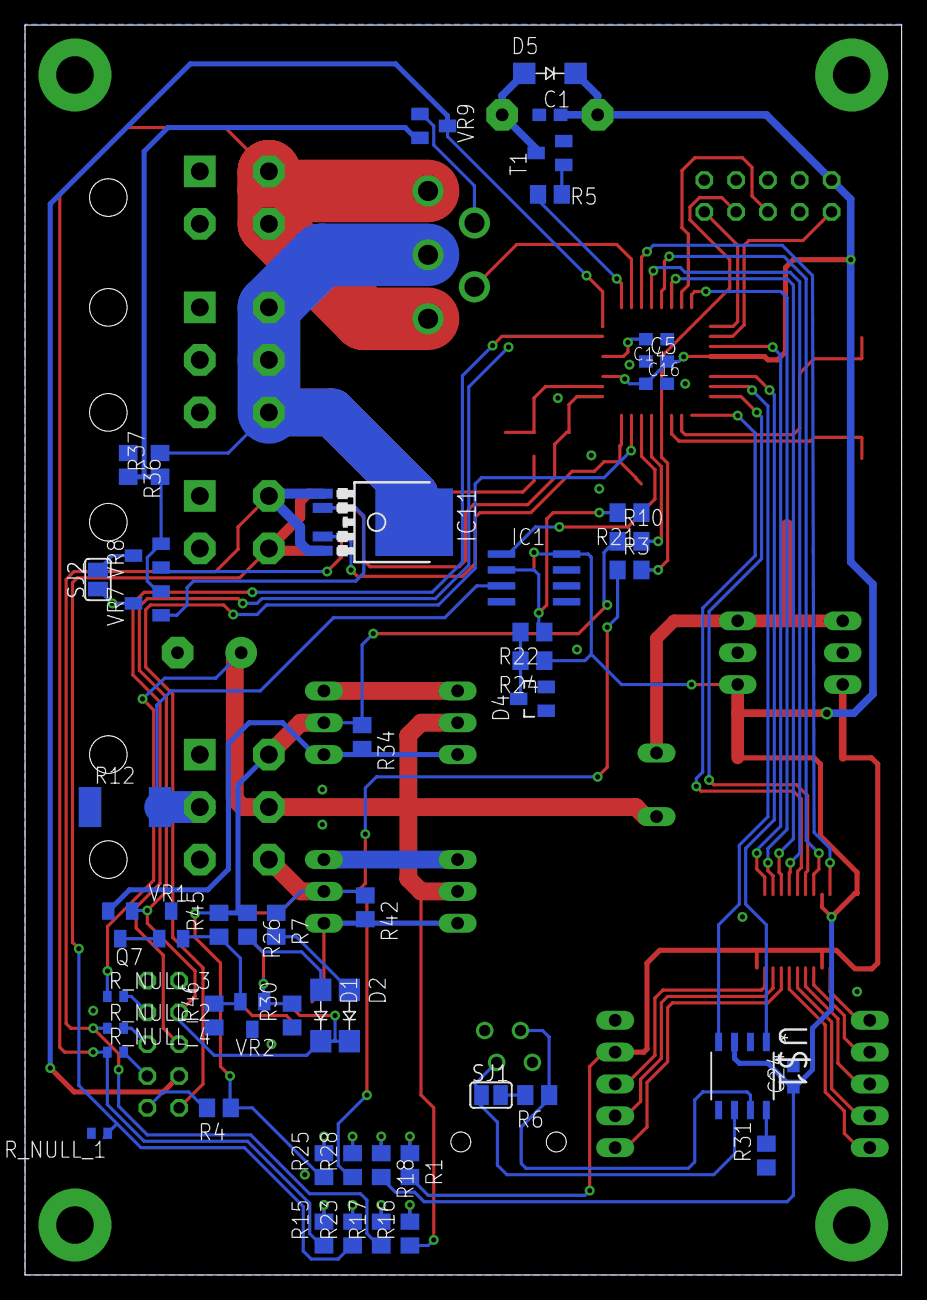
[picture p39: board CNC-PowerSwitch-2016-v0.96.brd from below]

Board: 2 copper layers, 70.0 x 99.7 mm, 111 parts (52 on the bottom side), 83 nets.
