carpe-noctem-cassel/cnc-circuit-boards/beagle2can/pcb/beagle2can.brd

## EAGLE design beagle2can/pcb/beagle2can.brd (2017-01-27)

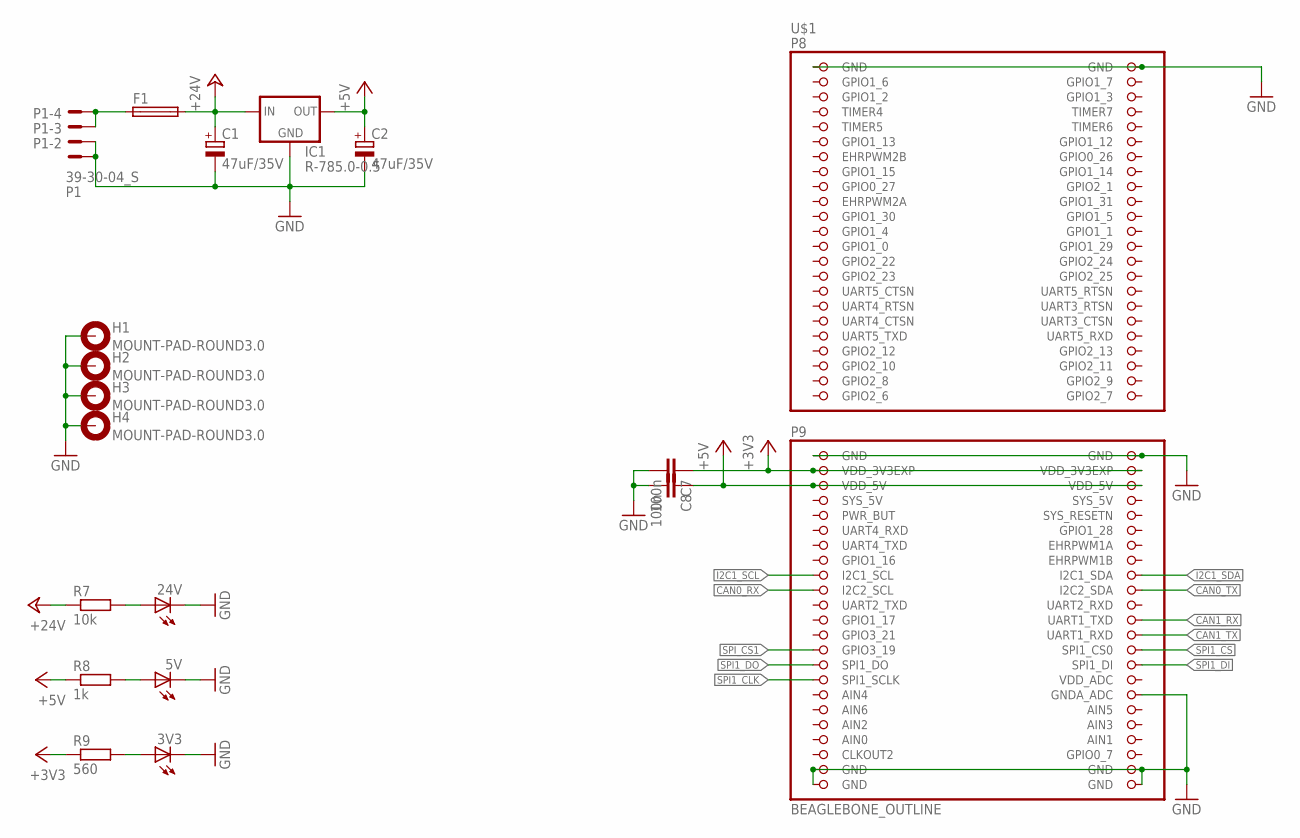
[picture p40: schematic beagle2can.sch, sheet 1]

Parts:
3V3, 5V, 24V: LEDCHIP-LED0805; CHIP-LED0805
C1, C2: 47uF/35V; PANASONIC_D
C7, C8: 100n; C0603
F1: TE5
H1, H2, H3, H4: MOUNT-PAD-ROUND3.0; 3,0-PAD
IC1: R-785.0-0.5; SIP3
P1: 39-30-04_S; 39-30-?04?
R7: 10k; R0805
R8: 1k; R0805
R9: 560; R0805
U$1: BEAGLEBONE_OUTLINE; BEAGLEBONE_SHIELD

Connections:
+3V3: C7.1, R9.1, U$1.49 (VDD_3V3EXP), U$1.50 (VDD_3V3EXP); also elsewhere on the board
+5V: C2.+, C8.1, IC1.3 (OUT), R8.1, U$1.51 (VDD_5V), U$1.52 (VDD_5V); also elsewhere on the board
+24V: C1.+, F1.2, IC1.1 (IN), R7.1
AIN0: U$1.85 (AIN0)
CAN0_RX: U$1.65 (I2C2_SCL); also elsewhere on the board
CAN0_TX: U$1.66 (I2C2_SDA); also elsewhere on the board
CAN1_RX: U$1.70 (UART1_TXD); also elsewhere on the board
CAN1_TX: U$1.72 (UART1_RXD); also elsewhere on the board
CON_24V: F1.1, P1.3, P1.4; also elsewhere on the board
GND: 3V3.C, 5V.C, 24V.C, C1.-, C2.-, C7.2, C8.2, H1.B3,0, H2.B3,0, H3.B3,0, H4.B3,0, IC1.2 (GND), P1.1, P1.2, U$1.1 (GND), U$1.2 (GND), U$1.47 (GND), U$1.48 (GND), U$1.80 (GNDA_ADC), U$1.89 (GND), U$1.90 (GND), U$1.91 (GND), U$1.92 (GND); also elsewhere on the board
I2C1_SCL: U$1.63 (I2C1_SCL); also elsewhere on the board
I2C1_SDA: U$1.64 (I2C1_SDA); also elsewhere on the board
unnamed: 5V.A, R8.2
unnamed: 24V.A, R7.2
unnamed: 3V3.A, R9.2
SPI1_CLK: U$1.77 (SPI1_SCLK); also elsewhere on the board
SPI1_CS: U$1.74 (SPI1_CS0); also elsewhere on the board
SPI1_DI: U$1.76 (SPI1_DI); also elsewhere on the board
SPI1_DO: U$1.75 (SPI1_DO); also elsewhere on the board
SPI_CS1: U$1.73 (GPIO3_19)
SYS_5V: U$1.53 (SYS_5V)

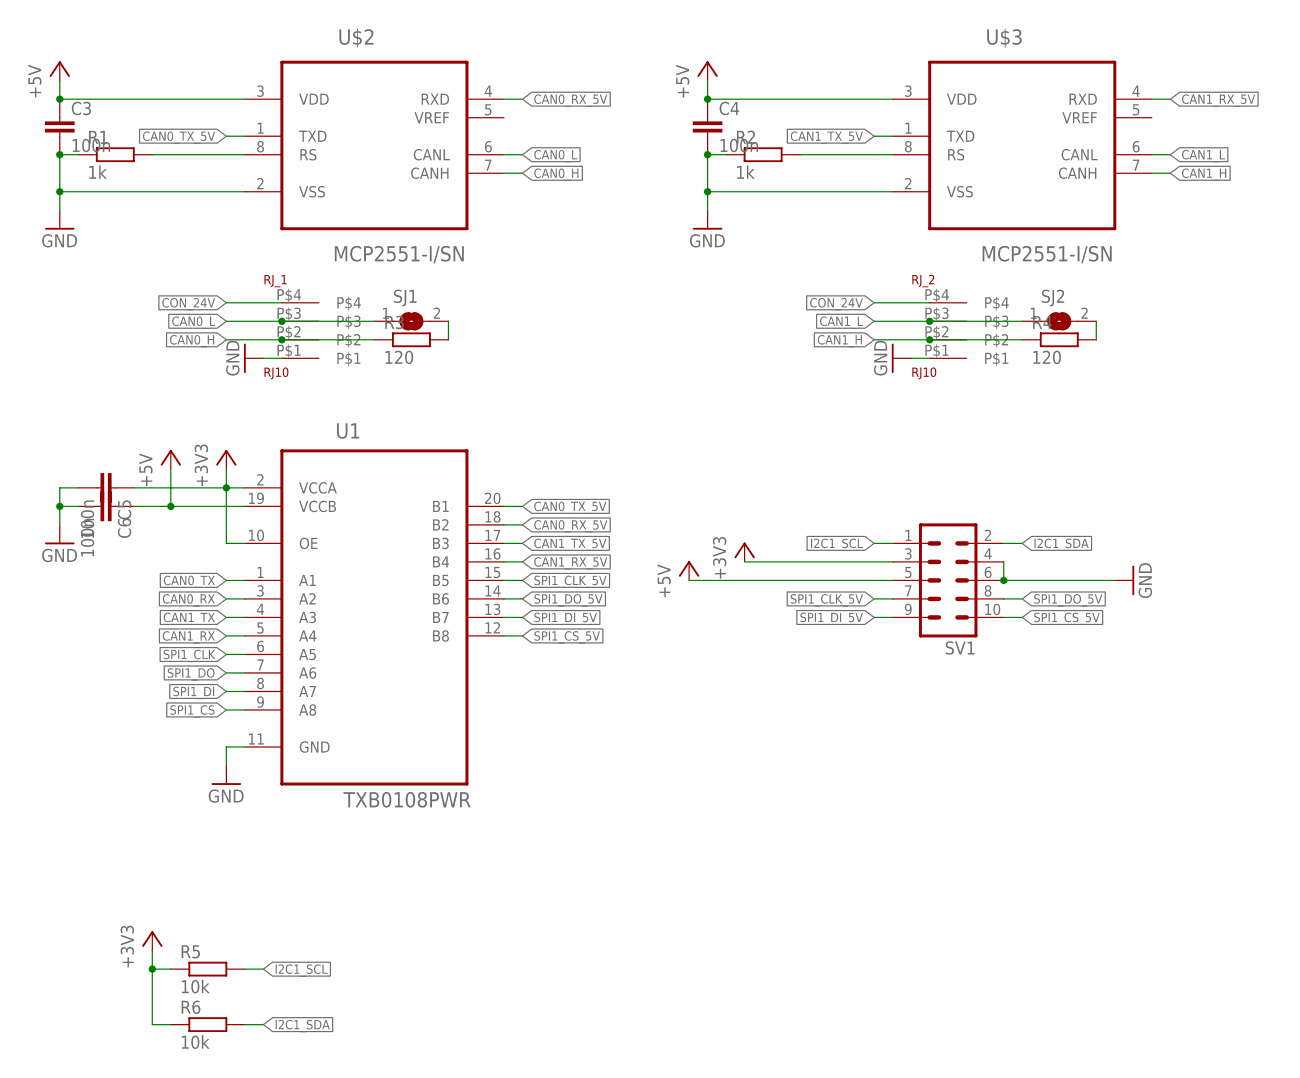
[picture p41: schematic beagle2can.sch, sheet 2]

Parts:
C3, C4, C5, C6: 100n; C0603
R1, R2: 1k; R0805
R3, R4: 120; R0805
R5, R6: 10k; R0805
RJ_1, RJ_2: RJ10
SJ1, SJ2: SJ
SV1: ML10L
U1: TXB0108PWR; SOP65P640X120-20N
U$2, U$3: MCP2551-I/SN; SOIC127P600X175-8N

Connections:
+3V3: C5.1, R5.1, R6.1, SV1.3, U1.2 (VCCA), U1.10 (OE); also elsewhere on the board
+5V: C3.1, C4.1, C6.1, SV1.5, U1.19 (VCCB), U$2.3 (VDD), U$3.3 (VDD); also elsewhere on the board
CAN0_H: R3.1, RJ_1.P$2, U$2.7 (CANH)
CAN0_L: RJ_1.P$3, SJ1.1, U$2.6 (CANL)
CAN0_RS: R1.2, U$2.8 (RS)
CAN0_RX: U1.3 (A2); also elsewhere on the board
CAN0_RX_5V: U1.18 (B2), U$2.4 (RXD)
CAN0_R_TERM: R3.2, SJ1.2
CAN0_TX: U1.1 (A1); also elsewhere on the board
CAN0_TX_5V: U1.20 (B1), U$2.1 (TXD)
CAN1_H: R4.1, RJ_2.P$2, U$3.7 (CANH)
CAN1_L: RJ_2.P$3, SJ2.1, U$3.6 (CANL)
CAN1_RS: R2.2, U$3.8 (RS)
CAN1_RX: U1.5 (A4); also elsewhere on the board
CAN1_RX_5V: U1.16 (B4), U$3.4 (RXD)
CAN1_R_TERM: R4.2, SJ2.2
CAN1_TX: U1.4 (A3); also elsewhere on the board
CAN1_TX_5V: U1.17 (B3), U$3.1 (TXD)
CON_24V: RJ_1.P$4, RJ_2.P$4; also elsewhere on the board
GND: C3.2, C4.2, C5.2, C6.2, R1.1, R2.1, RJ_1.P$1, RJ_2.P$1, SV1.4, SV1.6, U1.11 (GND), U$2.2 (VSS), U$3.2 (VSS); also elsewhere on the board
I2C1_SCL: R5.2, SV1.1; also elsewhere on the board
I2C1_SDA: R6.2, SV1.2; also elsewhere on the board
SPI1_CLK: U1.6 (A5); also elsewhere on the board
SPI1_CLK_5V: SV1.7, U1.15 (B5)
SPI1_CS: U1.9 (A8); also elsewhere on the board
SPI1_CS_5V: SV1.10, U1.12 (B8)
SPI1_DI: U1.8 (A7); also elsewhere on the board
SPI1_DI_5V: SV1.9, U1.13 (B7)
SPI1_DO: U1.7 (A6); also elsewhere on the board
SPI1_DO_5V: SV1.8, U1.14 (B6)

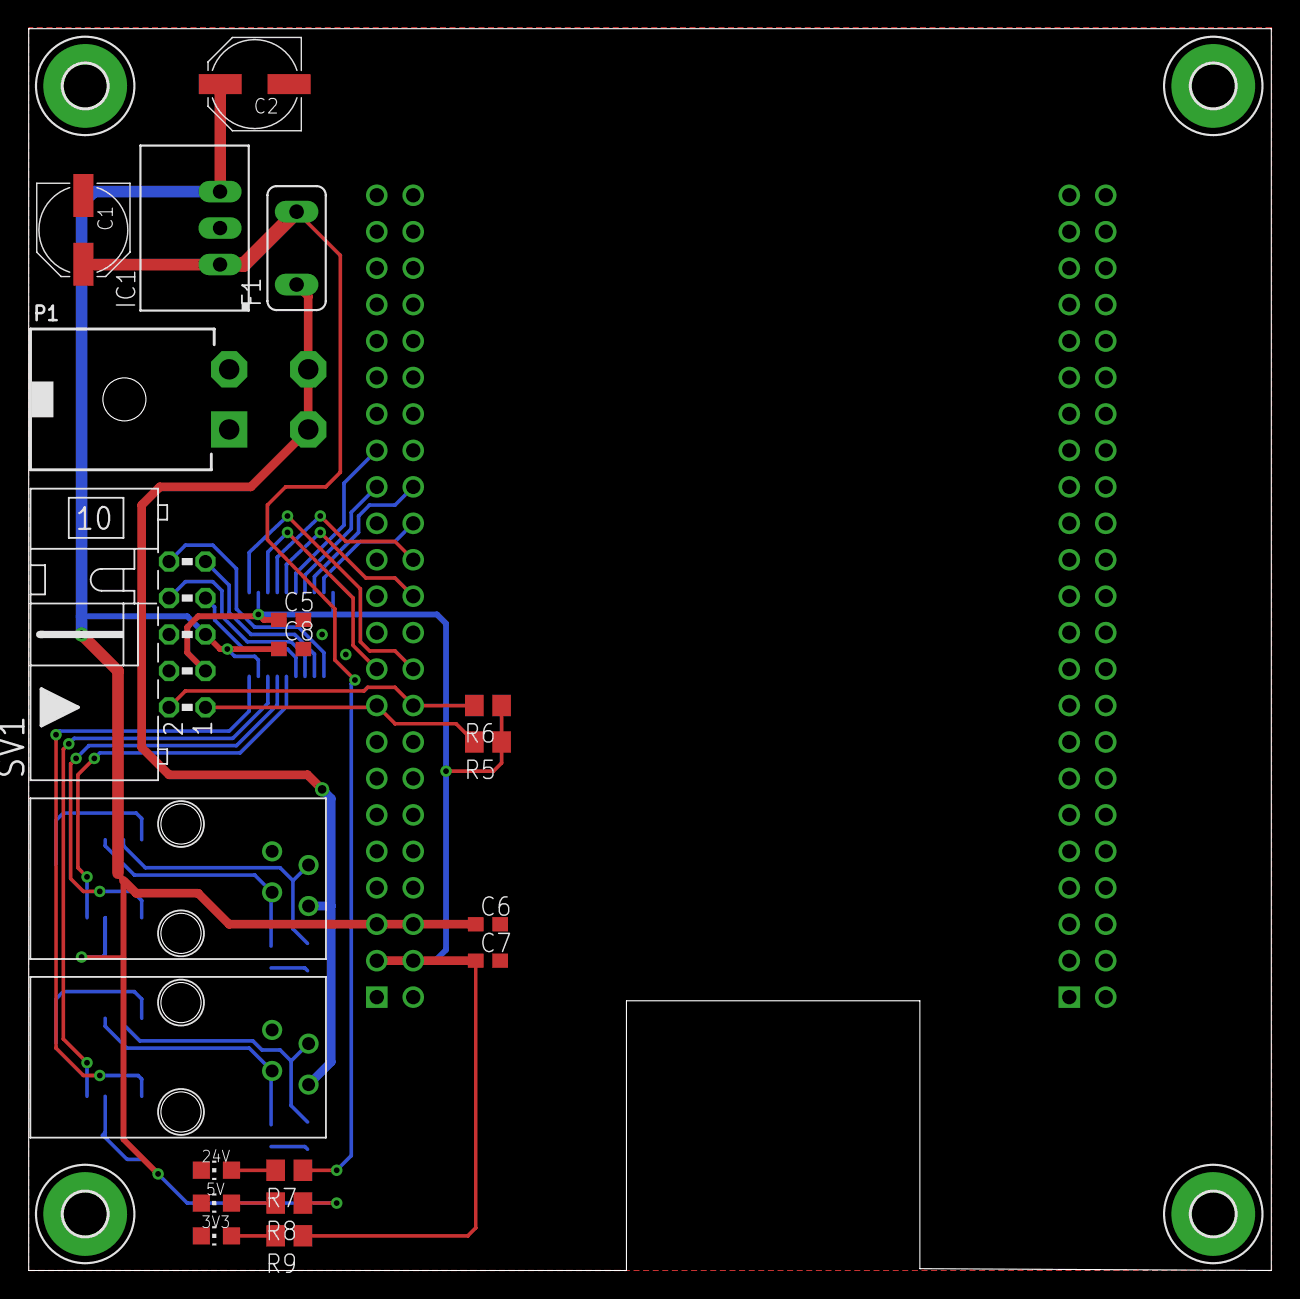
[picture p42: board beagle2can.brd from above]

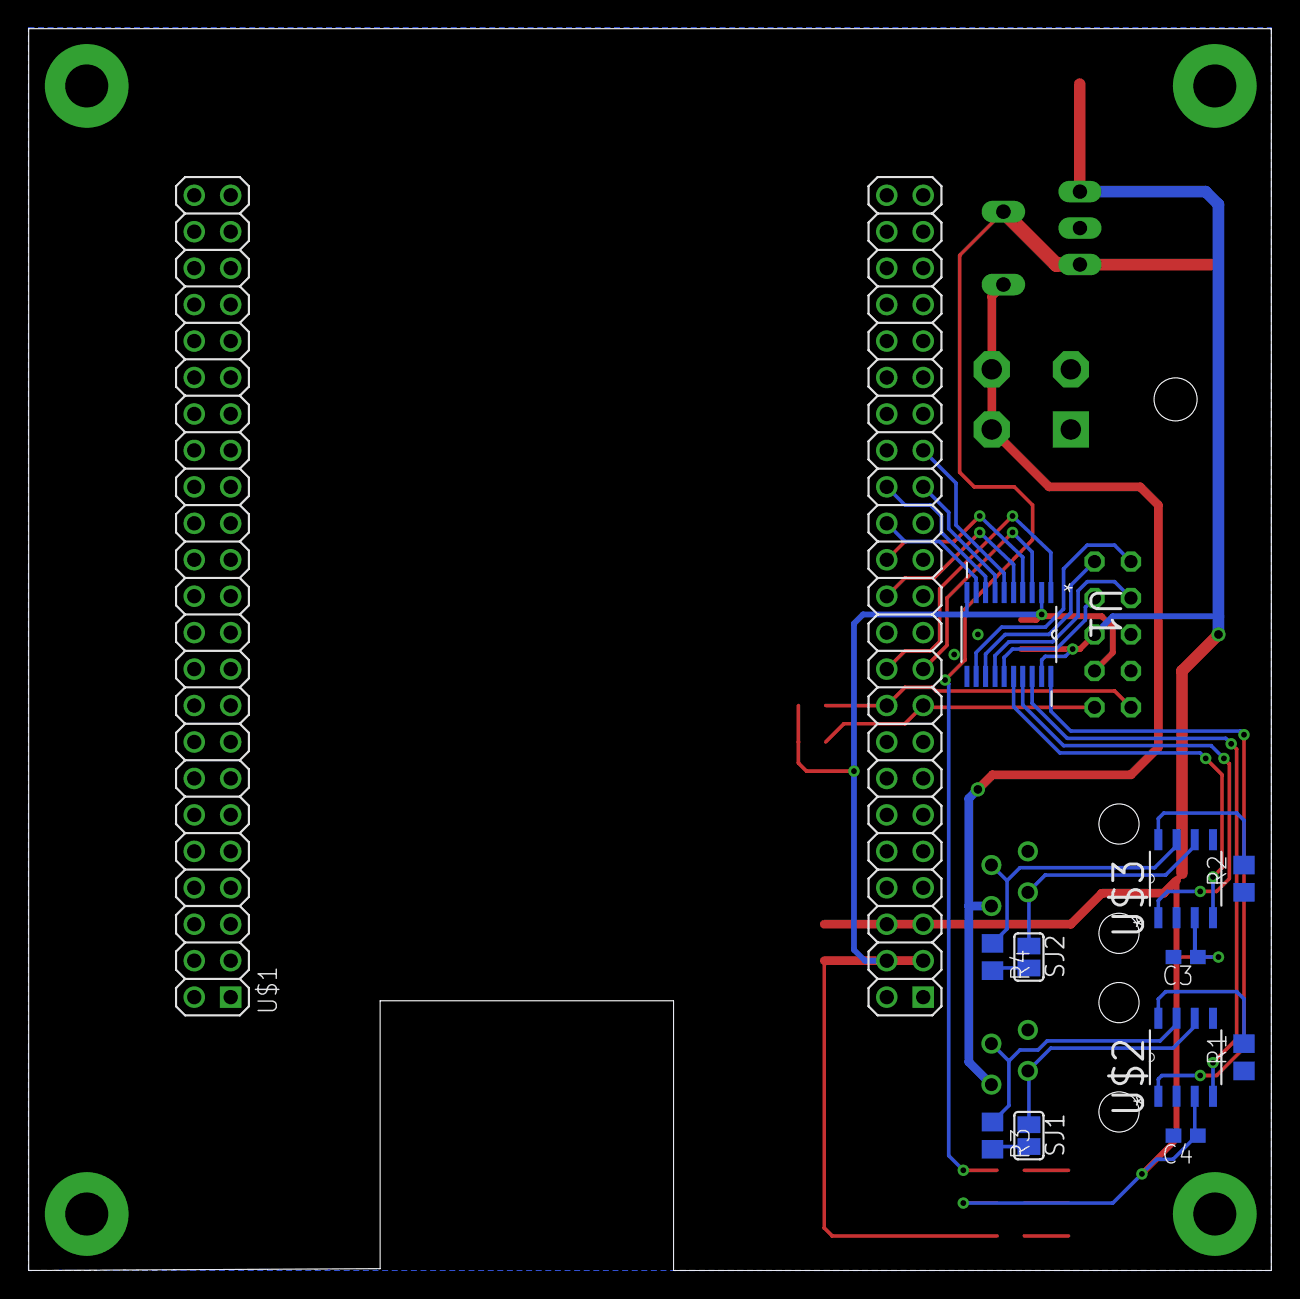
[picture p43: board beagle2can.brd from below]

Board: 2 copper layers, 86.6 x 86.5 mm, 36 parts (12 on the bottom side), 34 nets.
