carpe-noctem-cassel/cnc-circuit-boards/actuator/BBB_Cape/pcb/CN-Cape-1.1.brd

## EAGLE design actuator/BBB_Cape/pcb/CN-Cape-1.1.brd (2017-01-12)

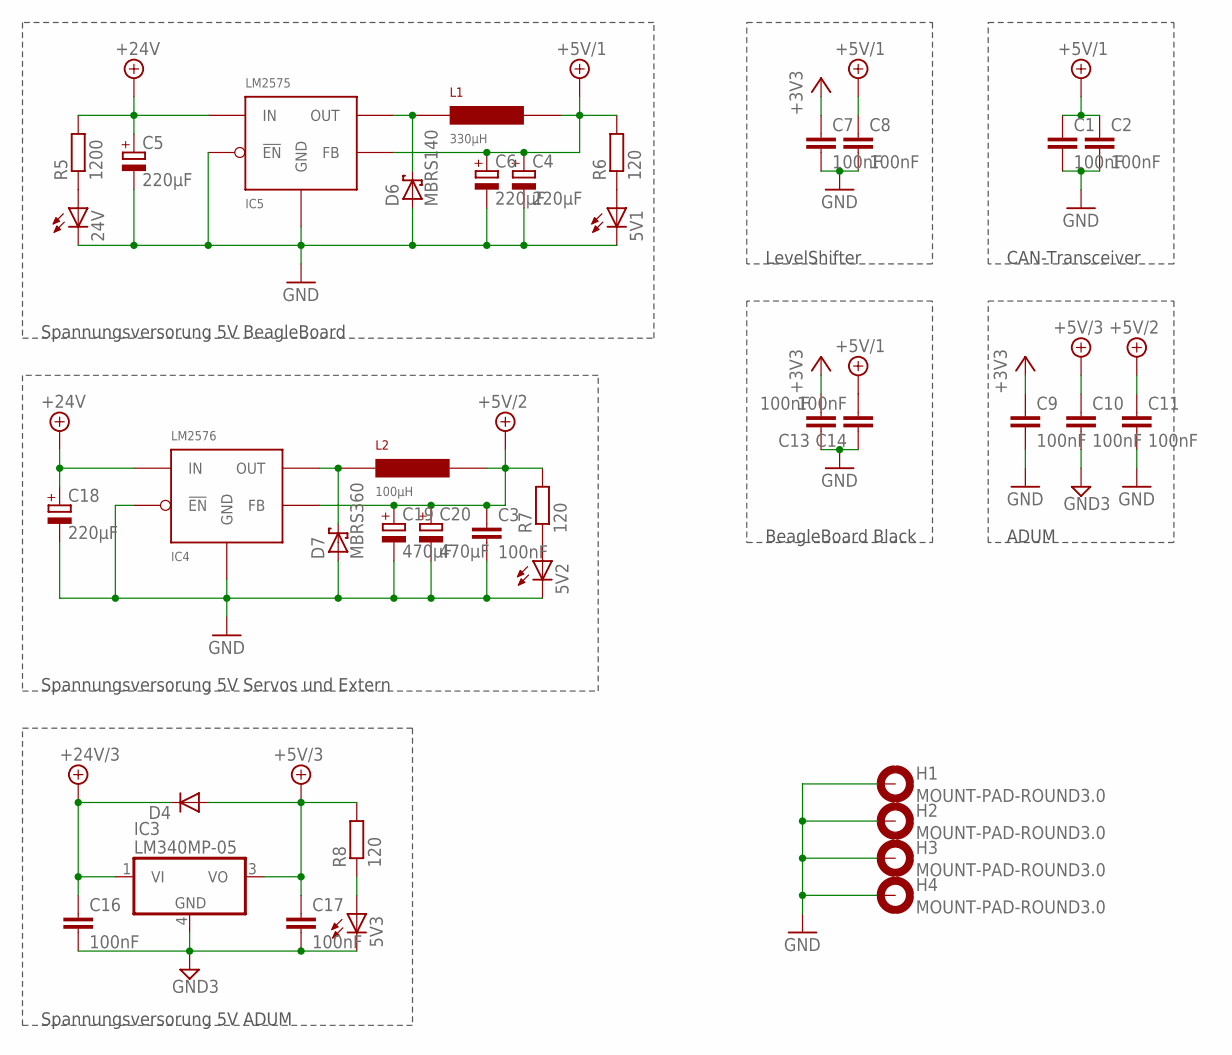
[picture p44: schematic CN-Cape-1.1.sch, sheet 1, Spannungsversorgung]

Parts:
5V1, 5V2, 5V3, 24V: LEDCHIP-LED0603; CHIP-LED0603
C1, C2, C3, C7, C8, C9, C10, C11, C13, C14, C16, C17: 100nF; C0603
C4, C6: 220µF; E2,5-6
C5, C18: 220µF; E3,5-8
C19, C20: 470µF; E3,5-8
D4: DIODE-SOD123; SOD123
D6: MBRS140; SMB
D7: MBRS360; SMC
H1, H2, H3, H4: MOUNT-PAD-ROUND3.0; 3,0-PAD
IC3: LM340MP-05; SOT223
IC4: LM2576; TO220-5_STAGGERED
IC5: LM2575; TO220-5_STAGGERED
L1: 330µH; PISR
L2: 100µH; PISR
R5: 1200; R0805
R6, R7, R8: 120; R0805

Connections:
+3V3: C7.1, C9.1, C13.2; also elsewhere on the board
+5V/1: C1.1, C2.1, C4.+, C6.+, C8.1, C14.2, IC5.FB, L1.P$2, R6.2; also elsewhere on the board
+5V/2: C3.1, C11.1, C19.+, C20.+, IC4.FB, L2.P$2, R7.2; also elsewhere on the board
+5V/3: C10.1, C17.1, D4.A, IC3.3 (VO), R8.2; also elsewhere on the board
+24V: C5.+, C18.+, IC4.IN, IC5.IN, R5.2; also elsewhere on the board
+24V/3: C16.1, D4.C, IC3.1 (VI); also elsewhere on the board
GND: 5V1.C, 5V2.C, 24V.C, C1.2, C2.2, C3.2, C4.-, C5.-, C6.-, C7.2, C8.2, C9.2, C11.2, C13.1, C14.1, C18.-, C19.-, C20.-, D6.A, D7.A, H1.B3,0, H2.B3,0, H3.B3,0, H4.B3,0, IC4.!EN, IC4.GND, IC5.!EN, IC5.GND; also elsewhere on the board
GND3: 5V3.C, C10.2, C16.2, C17.2, IC3.4 (GND); also elsewhere on the board
unnamed: 24V.A, R5.1
unnamed: 5V1.A, R6.1
unnamed: 5V2.A, R7.1
unnamed: D6.C, IC5.OUT, L1.P$1
unnamed: D7.C, IC4.OUT, L2.P$1
unnamed: 5V3.A, R8.1

Notes on the sheet:
LevelShifter
CAN-Transceiver
BeagleBoard Black
Spannungsversorung 5V BeagleBoard
Spannungsversorung 5V Servos und Extern
Spannungsversorung 5V ADUM
ADUM

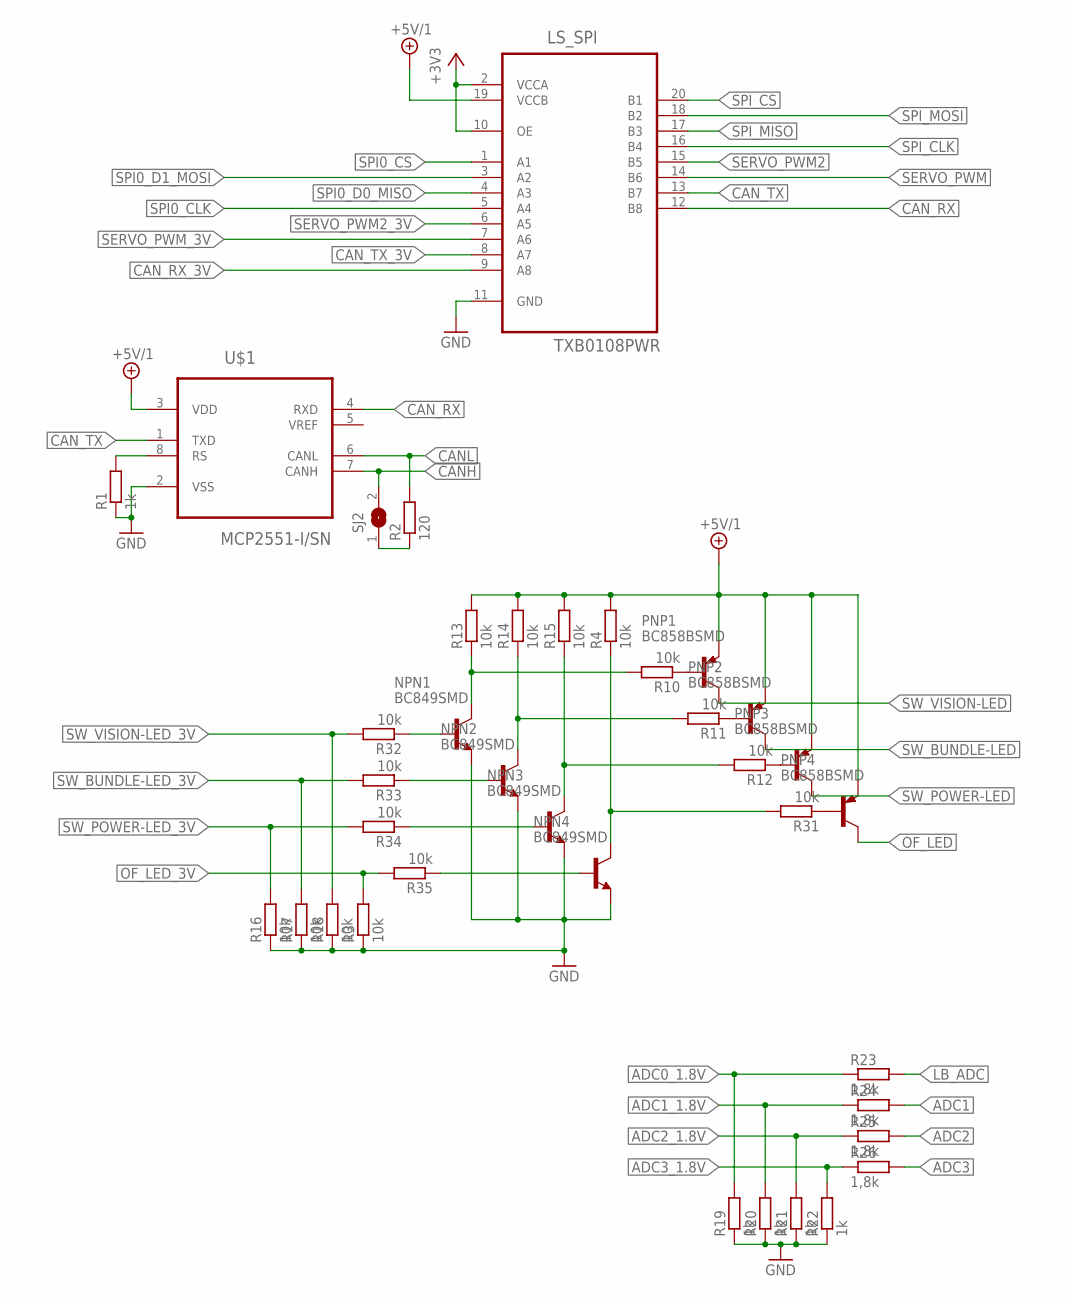
[picture p45: schematic CN-Cape-1.1.sch, sheet 2, LevelShifter, CAN, LEDs, ADC]

Parts:
LS_SPI: TXB0108PWR; SOP65P640X120-20N
NPN1, NPN2, NPN3, NPN4: BC849SMD; SOT23-BEC
PNP1, PNP2, PNP3, PNP4: BC858BSMD; SOT23-BEC
R1, R19, R20, R21, R22: 1k; R0805
R2: 120; R0805
R3, R4, R10, R11, R12, R13, R14, R15, R16, R17, R18, R31, R32, R33, R34, R35: 10k; R0805
R23, R24, R25, R26: 1,8k; R0805
SJ2: SJ
U$1: MCP2551-I/SN; SOIC127P600X175-8N

Connections:
+3V3: LS_SPI.2 (VCCA), LS_SPI.10 (OE); also elsewhere on the board
+5V/1: LS_SPI.19 (VCCB), PNP1.E, PNP2.E, PNP3.E, PNP4.E, R4.2, R13.2, R14.2, R15.2, U$1.3 (VDD); also elsewhere on the board
ADC0_1.8V: R19.2, R23.1; also elsewhere on the board
ADC1: R24.2; also elsewhere on the board
ADC1_1.8V: R20.2, R24.1; also elsewhere on the board
ADC2: R25.2; also elsewhere on the board
ADC2_1.8V: R21.2, R25.1; also elsewhere on the board
ADC3: R26.2; also elsewhere on the board
ADC3_1.8V: R22.2, R26.1; also elsewhere on the board
CANH: SJ2.2, U$1.7 (CANH); also elsewhere on the board
CANL: R2.2, U$1.6 (CANL); also elsewhere on the board
CAN_RX: LS_SPI.12 (B8), U$1.4 (RXD)
CAN_RX_3V: LS_SPI.9 (A8); also elsewhere on the board
CAN_TX: LS_SPI.13 (B7), U$1.1 (TXD)
CAN_TX_3V: LS_SPI.8 (A7); also elsewhere on the board
GND: LS_SPI.11 (GND), NPN1.E, NPN2.E, NPN3.E, NPN4.E, R1.1, R3.1, R16.1, R17.1, R18.1, R19.1, R20.1, R21.1, R22.1, U$1.2 (VSS); also elsewhere on the board
LB_ADC: R23.2; also elsewhere on the board
unnamed: NPN1.C, R10.2, R13.1
unnamed: NPN2.C, R11.2, R14.1
unnamed: NPN4.C, R4.1, R31.2
unnamed: NPN3.C, R12.2, R15.1
unnamed: R1.2, U$1.8 (RS)
unnamed: R2.1, SJ2.1
unnamed: PNP1.B, R10.1
unnamed: PNP2.B, R11.1
unnamed: PNP3.B, R12.1
unnamed: PNP4.B, R31.1
unnamed: NPN1.B, R32.1
unnamed: NPN2.B, R33.1
unnamed: NPN3.B, R34.1
unnamed: NPN4.B, R35.1
OF_LED: PNP4.C; also elsewhere on the board
OF_LED_3V: R3.2, R35.2; also elsewhere on the board
SERVO_PWM: LS_SPI.14 (B6); also elsewhere on the board
SERVO_PWM2: LS_SPI.15 (B5); also elsewhere on the board
SERVO_PWM2_3V: LS_SPI.6 (A5); also elsewhere on the board
SERVO_PWM_3V: LS_SPI.7 (A6); also elsewhere on the board
SPI0_CLK: LS_SPI.5 (A4); also elsewhere on the board
SPI0_CS: LS_SPI.1 (A1); also elsewhere on the board
SPI0_D0_MISO: LS_SPI.4 (A3); also elsewhere on the board
SPI0_D1_MOSI: LS_SPI.3 (A2); also elsewhere on the board
SPI_CLK: LS_SPI.16 (B4); also elsewhere on the board
SPI_CS: LS_SPI.20 (B1); also elsewhere on the board
SPI_MISO: LS_SPI.17 (B3); also elsewhere on the board
SPI_MOSI: LS_SPI.18 (B2); also elsewhere on the board
SW_BUNDLE-LED: PNP2.C; also elsewhere on the board
SW_BUNDLE-LED_3V: R17.2, R33.2; also elsewhere on the board
SW_POWER-LED: PNP3.C; also elsewhere on the board
SW_POWER-LED_3V: R16.2, R34.2; also elsewhere on the board
SW_VISION-LED: PNP1.C; also elsewhere on the board
SW_VISION-LED_3V: R18.2, R32.2; also elsewhere on the board
