carpe-noctem-cassel/cnc-circuit-boards/actuator/BBB_Cape/pcb/CN-Cape-1.1.brd

## EAGLE design actuator/BBB_Cape/pcb/CN-Cape-1.1.brd (continued)

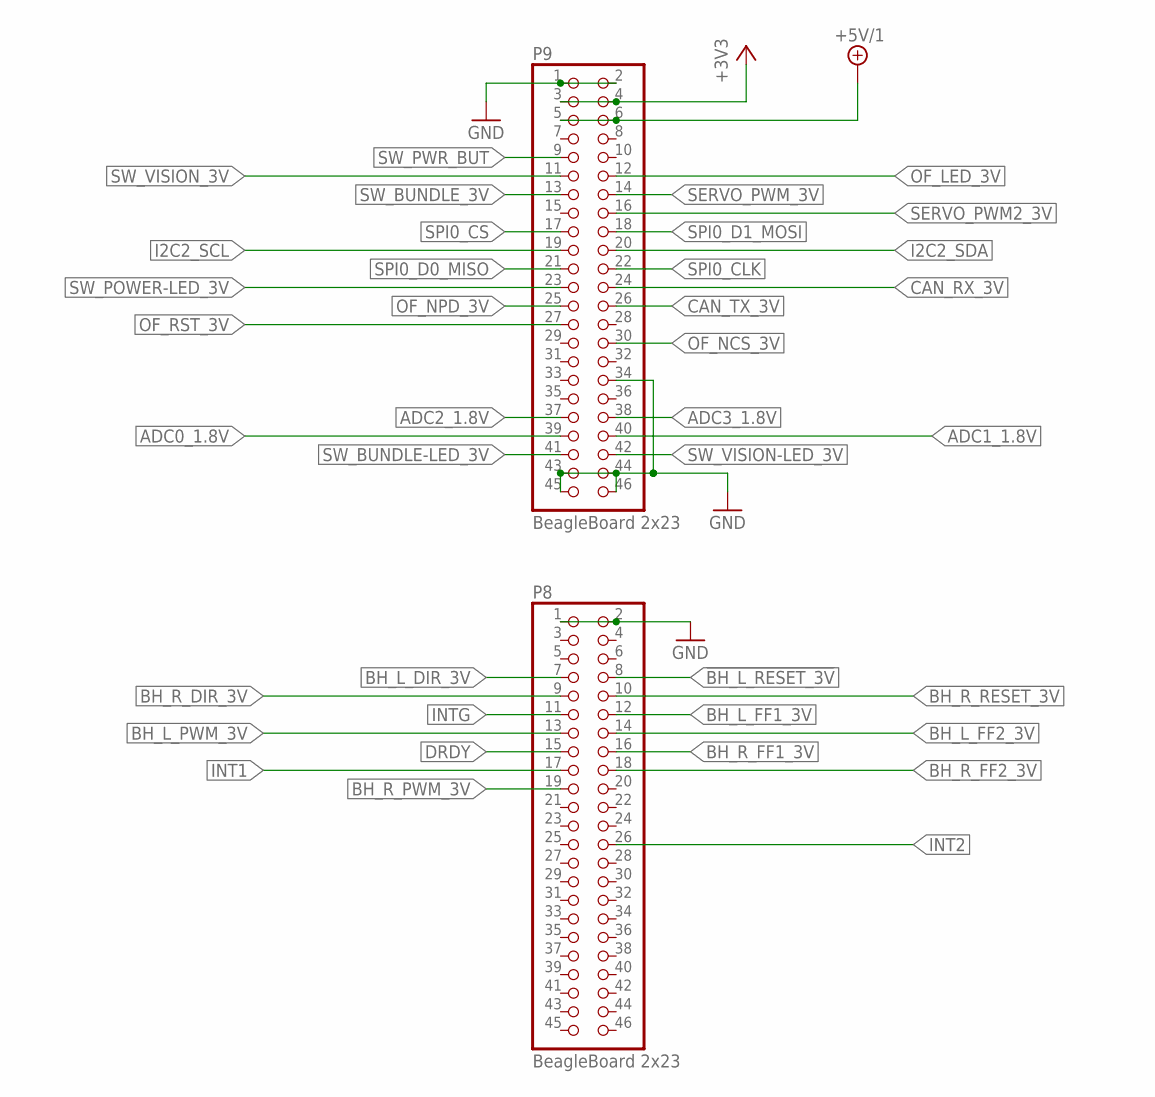
[picture p46: schematic CN-Cape-1.1.sch, sheet 3, Stecker BeagleBoard Black]

Parts:
P8, P9: BeagleBoard 2x23; 2X23

Connections:
!BH_L_RESET_3V: P8.8; also elsewhere on the board
!BH_R_RESET_3V: P8.10; also elsewhere on the board
+3V3: P9.3, P9.4; also elsewhere on the board
+5V/1: P9.5, P9.6; also elsewhere on the board
ADC0_1.8V: P9.39; also elsewhere on the board
ADC1_1.8V: P9.40; also elsewhere on the board
ADC2_1.8V: P9.37; also elsewhere on the board
ADC3_1.8V: P9.38; also elsewhere on the board
BH_L_DIR_3V: P8.7; also elsewhere on the board
BH_L_FF1_3V: P8.12; also elsewhere on the board
BH_L_FF2_3V: P8.14; also elsewhere on the board
BH_L_PWM_3V: P8.13; also elsewhere on the board
BH_R_DIR_3V: P8.9; also elsewhere on the board
BH_R_FF1_3V: P8.16; also elsewhere on the board
BH_R_FF2_3V: P8.18; also elsewhere on the board
BH_R_PWM_3V: P8.19; also elsewhere on the board
CAN_RX_3V: P9.24; also elsewhere on the board
CAN_TX_3V: P9.26; also elsewhere on the board
DRDY: P8.15; also elsewhere on the board
GND: P8.1, P8.2, P9.1, P9.2, P9.34, P9.43, P9.44, P9.45, P9.46; also elsewhere on the board
I2C2_SCL: P9.19; also elsewhere on the board
I2C2_SDA: P9.20; also elsewhere on the board
INT1: P8.17; also elsewhere on the board
INT2: P8.26; also elsewhere on the board
INTG: P8.11; also elsewhere on the board
OF_LED_3V: P9.12; also elsewhere on the board
OF_NCS_3V: P9.30; also elsewhere on the board
OF_NPD_3V: P9.25; also elsewhere on the board
OF_RST_3V: P9.27; also elsewhere on the board
SERVO_PWM2_3V: P9.16; also elsewhere on the board
SERVO_PWM_3V: P9.14; also elsewhere on the board
SPI0_CLK: P9.22; also elsewhere on the board
SPI0_CS: P9.17; also elsewhere on the board
SPI0_D0_MISO: P9.21; also elsewhere on the board
SPI0_D1_MOSI: P9.18; also elsewhere on the board
SW_BUNDLE-LED_3V: P9.41; also elsewhere on the board
SW_BUNDLE_3V: P9.13; also elsewhere on the board
SW_POWER-LED_3V: P9.23; also elsewhere on the board
SW_PWR_BUT: P9.9; also elsewhere on the board
SW_VISION-LED_3V: P9.42; also elsewhere on the board
SW_VISION_3V: P9.11; also elsewhere on the board

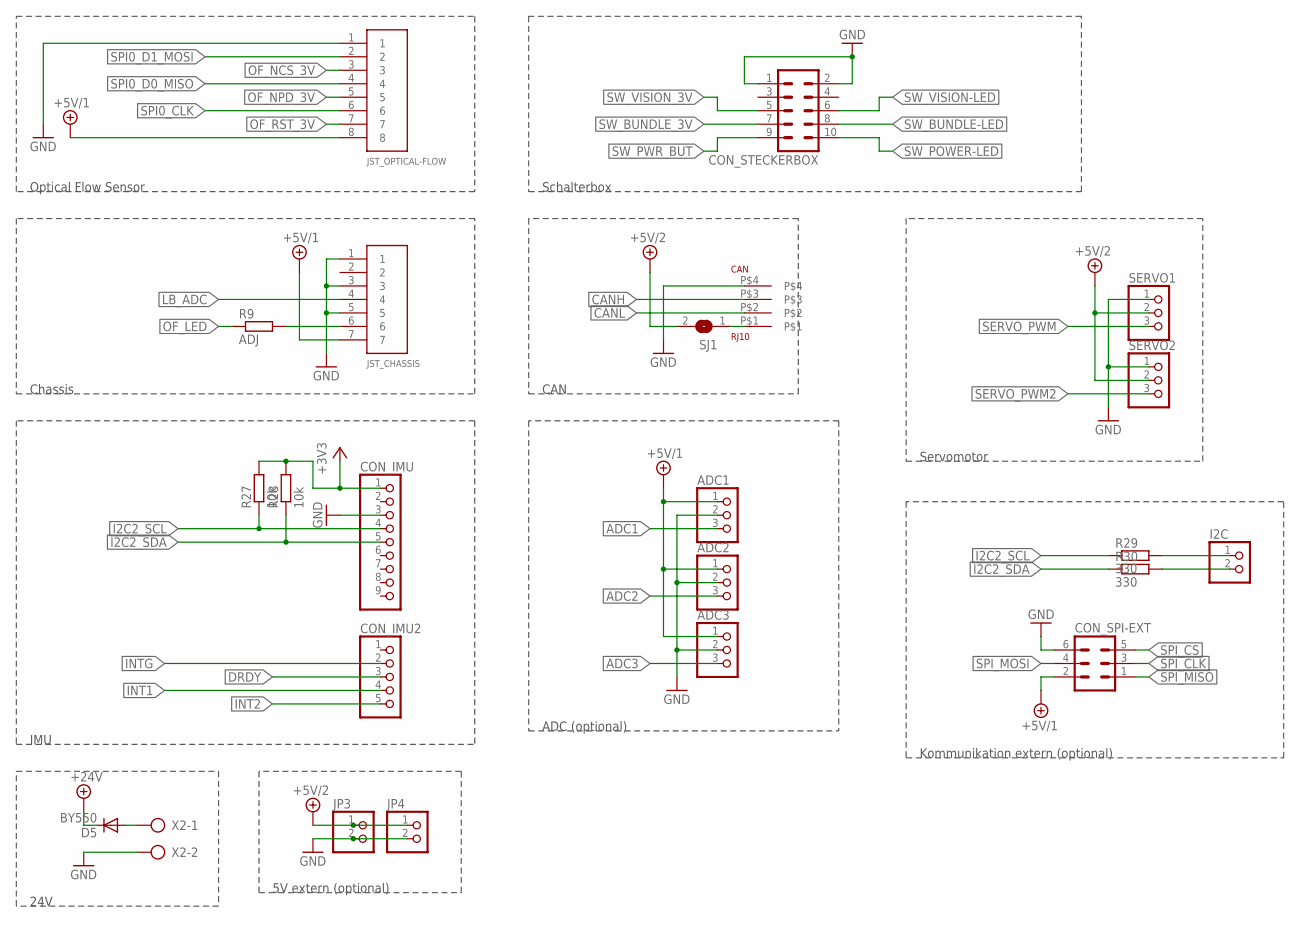
[picture p47: schematic CN-Cape-1.1.sch, sheet 4, Stecker]

Parts:
ADC1, ADC2, ADC3: PINHD-1X3; 1X03
CAN: RJ10
CON_IMU: PINHD-1X9; 1X09
CON_IMU2: PINHD-1X5; 1X05
CON_SPI-EXT: ML6
CON_STECKERBOX: ML10
D5: BY550; DO27-15
I2C: PINHD-1X2; 1X02
JP3, JP4: PINHD-1X2; 1X02
JST_CHASSIS: S7PIN; S7B-EH
JST_OPTICAL-FLOW: S8PIN; S8B-EH
R9: ADJ; R0805
R27, R28: 10k; R0805
R29, R30: 330; R0805
SERVO1, SERVO2: PINHD-1X3; 1X03
SJ1: SJ
X2: AK500/2-H

Connections:
+3V3: CON_IMU.1, R27.2, R28.2; also elsewhere on the board
+5V/1: ADC1.1, ADC2.1, ADC3.1, CON_SPI-EXT.2, JST_CHASSIS.7, JST_OPTICAL-FLOW.8; also elsewhere on the board
+5V/2: JP3.1, JP4.1, SERVO1.2, SERVO2.2, SJ1.2; also elsewhere on the board
+24V: D5.C; also elsewhere on the board
ADC1: ADC1.3; also elsewhere on the board
ADC2: ADC2.3; also elsewhere on the board
ADC3: ADC3.3; also elsewhere on the board
CANH: CAN.P$3; also elsewhere on the board
CANL: CAN.P$2; also elsewhere on the board
DRDY: CON_IMU2.3; also elsewhere on the board
GND: ADC1.2, ADC2.2, ADC3.2, CAN.P$4, CON_IMU.3, CON_SPI-EXT.6, CON_STECKERBOX.1, CON_STECKERBOX.2, JP3.2, JP4.2, JST_CHASSIS.1, JST_CHASSIS.3, JST_CHASSIS.5, JST_OPTICAL-FLOW.1, SERVO1.1, SERVO2.1, X2.2; also elsewhere on the board
I2C2_SCL: CON_IMU.4, R27.1, R29.1; also elsewhere on the board
I2C2_SDA: CON_IMU.5, R28.1, R30.1; also elsewhere on the board
INT1: CON_IMU2.4; also elsewhere on the board
INT2: CON_IMU2.5; also elsewhere on the board
INTG: CON_IMU2.2; also elsewhere on the board
LB_ADC: JST_CHASSIS.4; also elsewhere on the board
unnamed: D5.A, X2.1
unnamed: JST_CHASSIS.6, R9.2
unnamed: I2C.1, R29.2
unnamed: I2C.2, R30.2
unnamed: CAN.P$1, SJ1.1
OF_LED: R9.1; also elsewhere on the board
OF_NCS_3V: JST_OPTICAL-FLOW.3; also elsewhere on the board
OF_NPD_3V: JST_OPTICAL-FLOW.5; also elsewhere on the board
OF_RST_3V: JST_OPTICAL-FLOW.7; also elsewhere on the board
SERVO_PWM: SERVO1.3; also elsewhere on the board
SERVO_PWM2: SERVO2.3; also elsewhere on the board
SPI0_CLK: JST_OPTICAL-FLOW.6; also elsewhere on the board
SPI0_D0_MISO: JST_OPTICAL-FLOW.4; also elsewhere on the board
SPI0_D1_MOSI: JST_OPTICAL-FLOW.2; also elsewhere on the board
SPI_CLK: CON_SPI-EXT.3; also elsewhere on the board
SPI_CS: CON_SPI-EXT.5; also elsewhere on the board
SPI_MISO: CON_SPI-EXT.1; also elsewhere on the board
SPI_MOSI: CON_SPI-EXT.4; also elsewhere on the board
SW_BUNDLE-LED: CON_STECKERBOX.8; also elsewhere on the board
SW_BUNDLE_3V: CON_STECKERBOX.7; also elsewhere on the board
SW_POWER-LED: CON_STECKERBOX.10; also elsewhere on the board
SW_PWR_BUT: CON_STECKERBOX.9; also elsewhere on the board
SW_VISION-LED: CON_STECKERBOX.6; also elsewhere on the board
SW_VISION_3V: CON_STECKERBOX.5; also elsewhere on the board

Notes on the sheet:
Optical Flow Sensor
Chassis
IMU
24V
5V extern (optional)
ADC (optional)
Schalterbox
CAN
Servomotor
Kommunikation extern (optional)

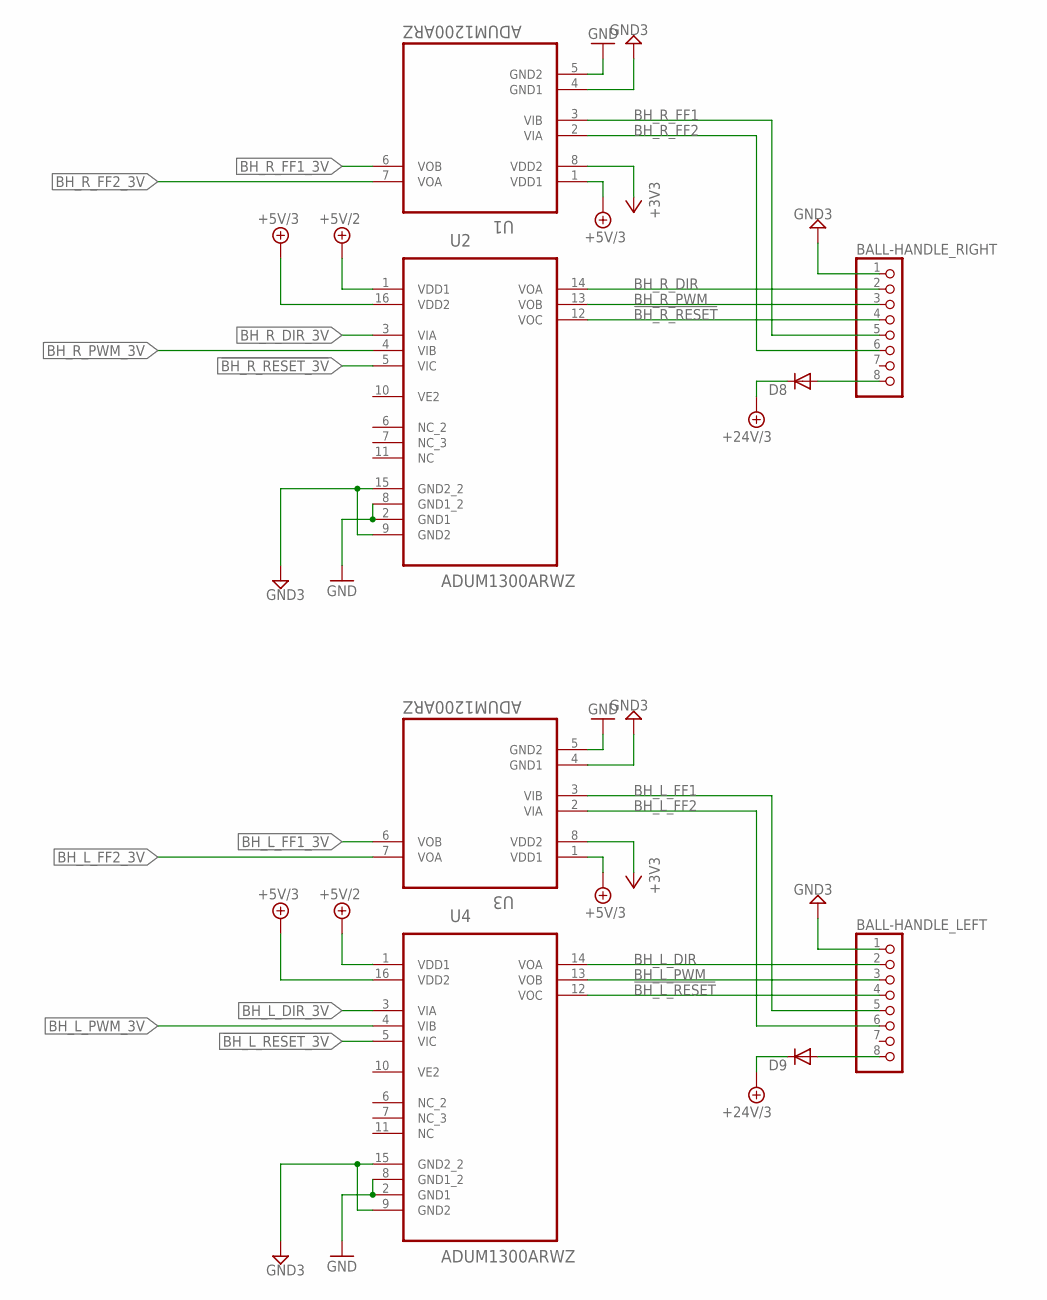
[picture p48: schematic CN-Cape-1.1.sch, sheet 5, Ballführung]

Parts:
BALL-HANDLE_LEFT: PINHD-1X8; 1X08
BALL-HANDLE_RIGHT: PINHD-1X8; 1X08
D8, D9: DIODE-SOD123; SOD123
U1, U3: ADUM1200ARZ; SOIC127P600X175-8N
U2, U4: ADUM1300ARWZ; SOIC127P1032X265-16N

Connections:
!BH_L_RESET: BALL-HANDLE_LEFT.4, U4.12 (VOC)
!BH_L_RESET_3V: U4.5 (VIC); also elsewhere on the board
!BH_R_RESET: BALL-HANDLE_RIGHT.4, U2.12 (VOC)
!BH_R_RESET_3V: U2.5 (VIC); also elsewhere on the board
+3V3: U1.8 (VDD2), U3.8 (VDD2); also elsewhere on the board
+5V/2: U2.1 (VDD1), U4.1 (VDD1); also elsewhere on the board
+5V/3: U1.1 (VDD1), U2.16 (VDD2), U3.1 (VDD1), U4.16 (VDD2); also elsewhere on the board
+24V/3: D8.C, D9.C; also elsewhere on the board
BH_L_DIR: BALL-HANDLE_LEFT.2, U4.14 (VOA)
BH_L_DIR_3V: U4.3 (VIA); also elsewhere on the board
BH_L_FF1: BALL-HANDLE_LEFT.5, U3.3 (VIB)
BH_L_FF1_3V: U3.6 (VOB); also elsewhere on the board
BH_L_FF2: BALL-HANDLE_LEFT.6, U3.2 (VIA)
BH_L_FF2_3V: U3.7 (VOA); also elsewhere on the board
BH_L_PWM: BALL-HANDLE_LEFT.3, U4.13 (VOB)
BH_L_PWM_3V: U4.4 (VIB); also elsewhere on the board
BH_R_DIR: BALL-HANDLE_RIGHT.2, U2.14 (VOA)
BH_R_DIR_3V: U2.3 (VIA); also elsewhere on the board
BH_R_FF1: BALL-HANDLE_RIGHT.5, U1.3 (VIB)
BH_R_FF1_3V: U1.6 (VOB); also elsewhere on the board
BH_R_FF2: BALL-HANDLE_RIGHT.6, U1.2 (VIA)
BH_R_FF2_3V: U1.7 (VOA); also elsewhere on the board
BH_R_PWM: BALL-HANDLE_RIGHT.3, U2.13 (VOB)
BH_R_PWM_3V: U2.4 (VIB); also elsewhere on the board
GND: U1.5 (GND2), U2.2 (GND1), U2.8 (GND1_2), U3.5 (GND2), U4.2 (GND1), U4.8 (GND1_2); also elsewhere on the board
GND3: BALL-HANDLE_LEFT.1, BALL-HANDLE_RIGHT.1, U1.4 (GND1), U2.9 (GND2), U2.15 (GND2_2), U3.4 (GND1), U4.9 (GND2), U4.15 (GND2_2); also elsewhere on the board
unnamed: BALL-HANDLE_LEFT.8, D9.A
unnamed: BALL-HANDLE_RIGHT.8, D8.A

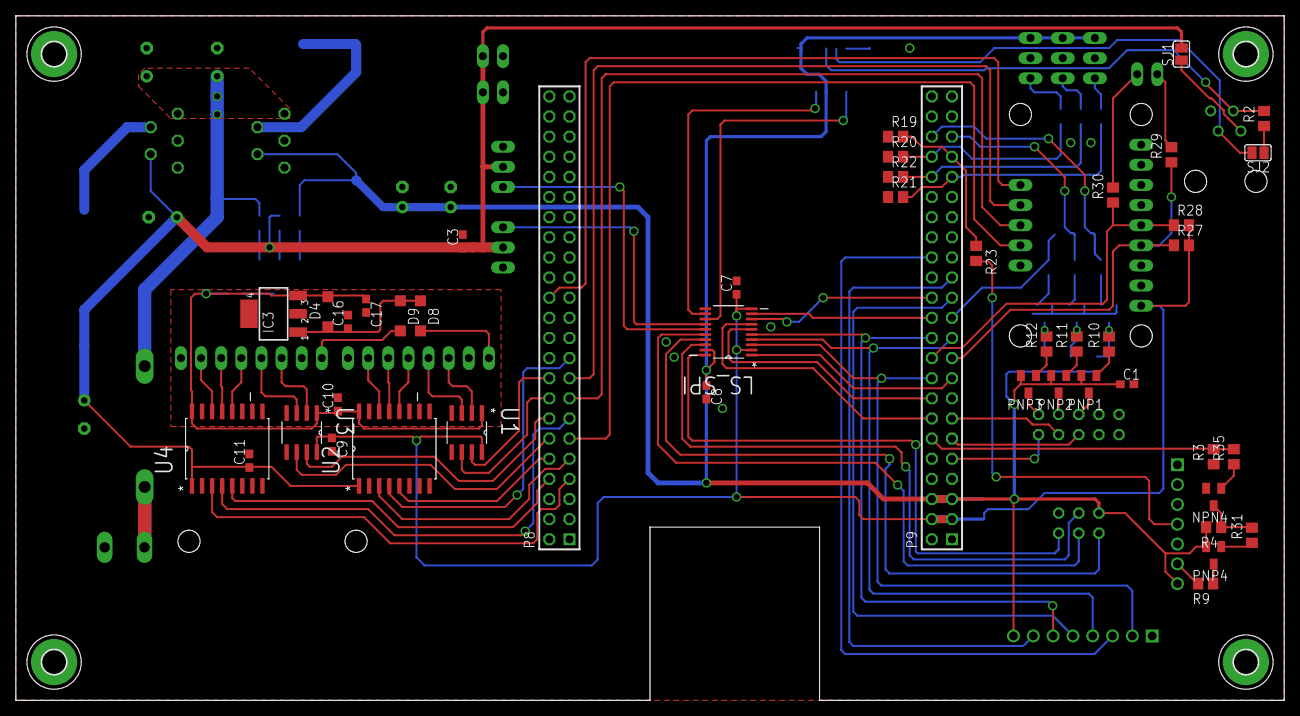
[picture p49: board CN-Cape-1.1.brd from above]

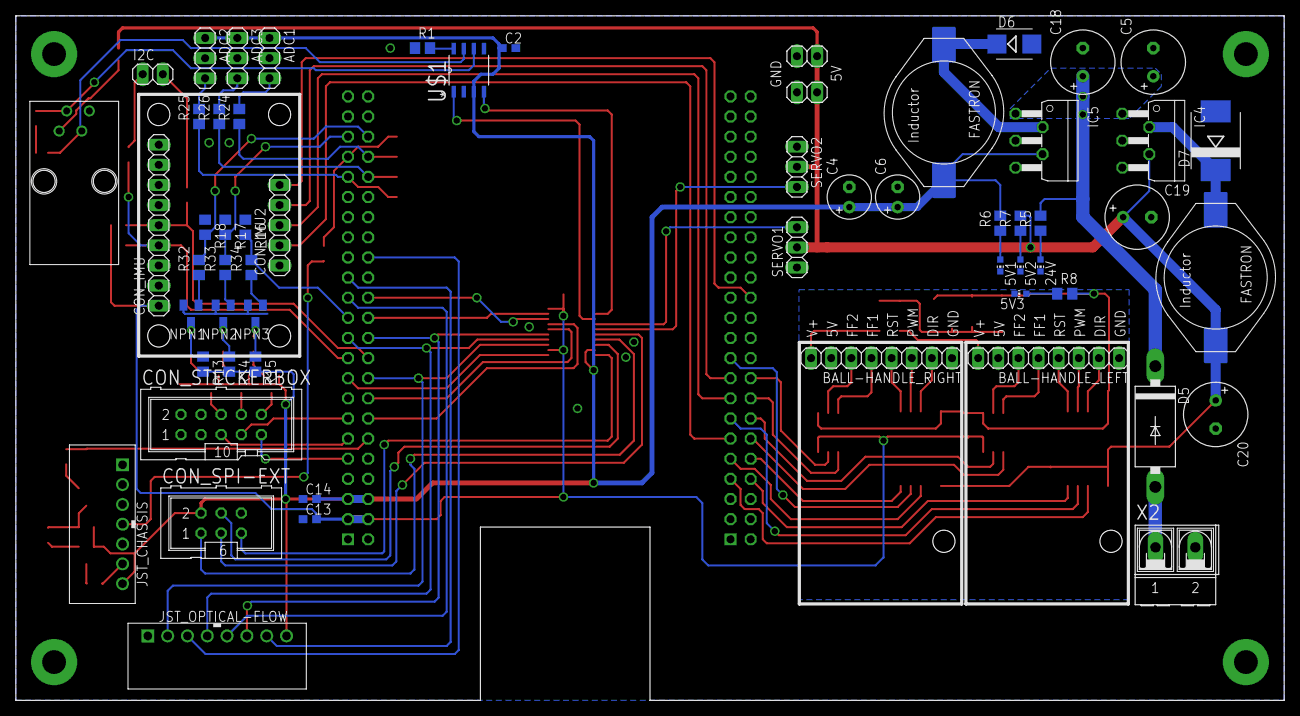
[picture p50: board CN-Cape-1.1.brd from below]

Board: 2 copper layers, 160.0 x 86.4 mm, 108 parts (59 on the bottom side), 101 nets.
