carpe-noctem-cassel/cnc-circuit-boards/powerSwitch/pcb/CNC-PowerSwitch-2016-v0.92.brd

## EAGLE design powerSwitch/pcb/CNC-PowerSwitch-2016-v0.92.brd (2016-11-24, an earlier design)

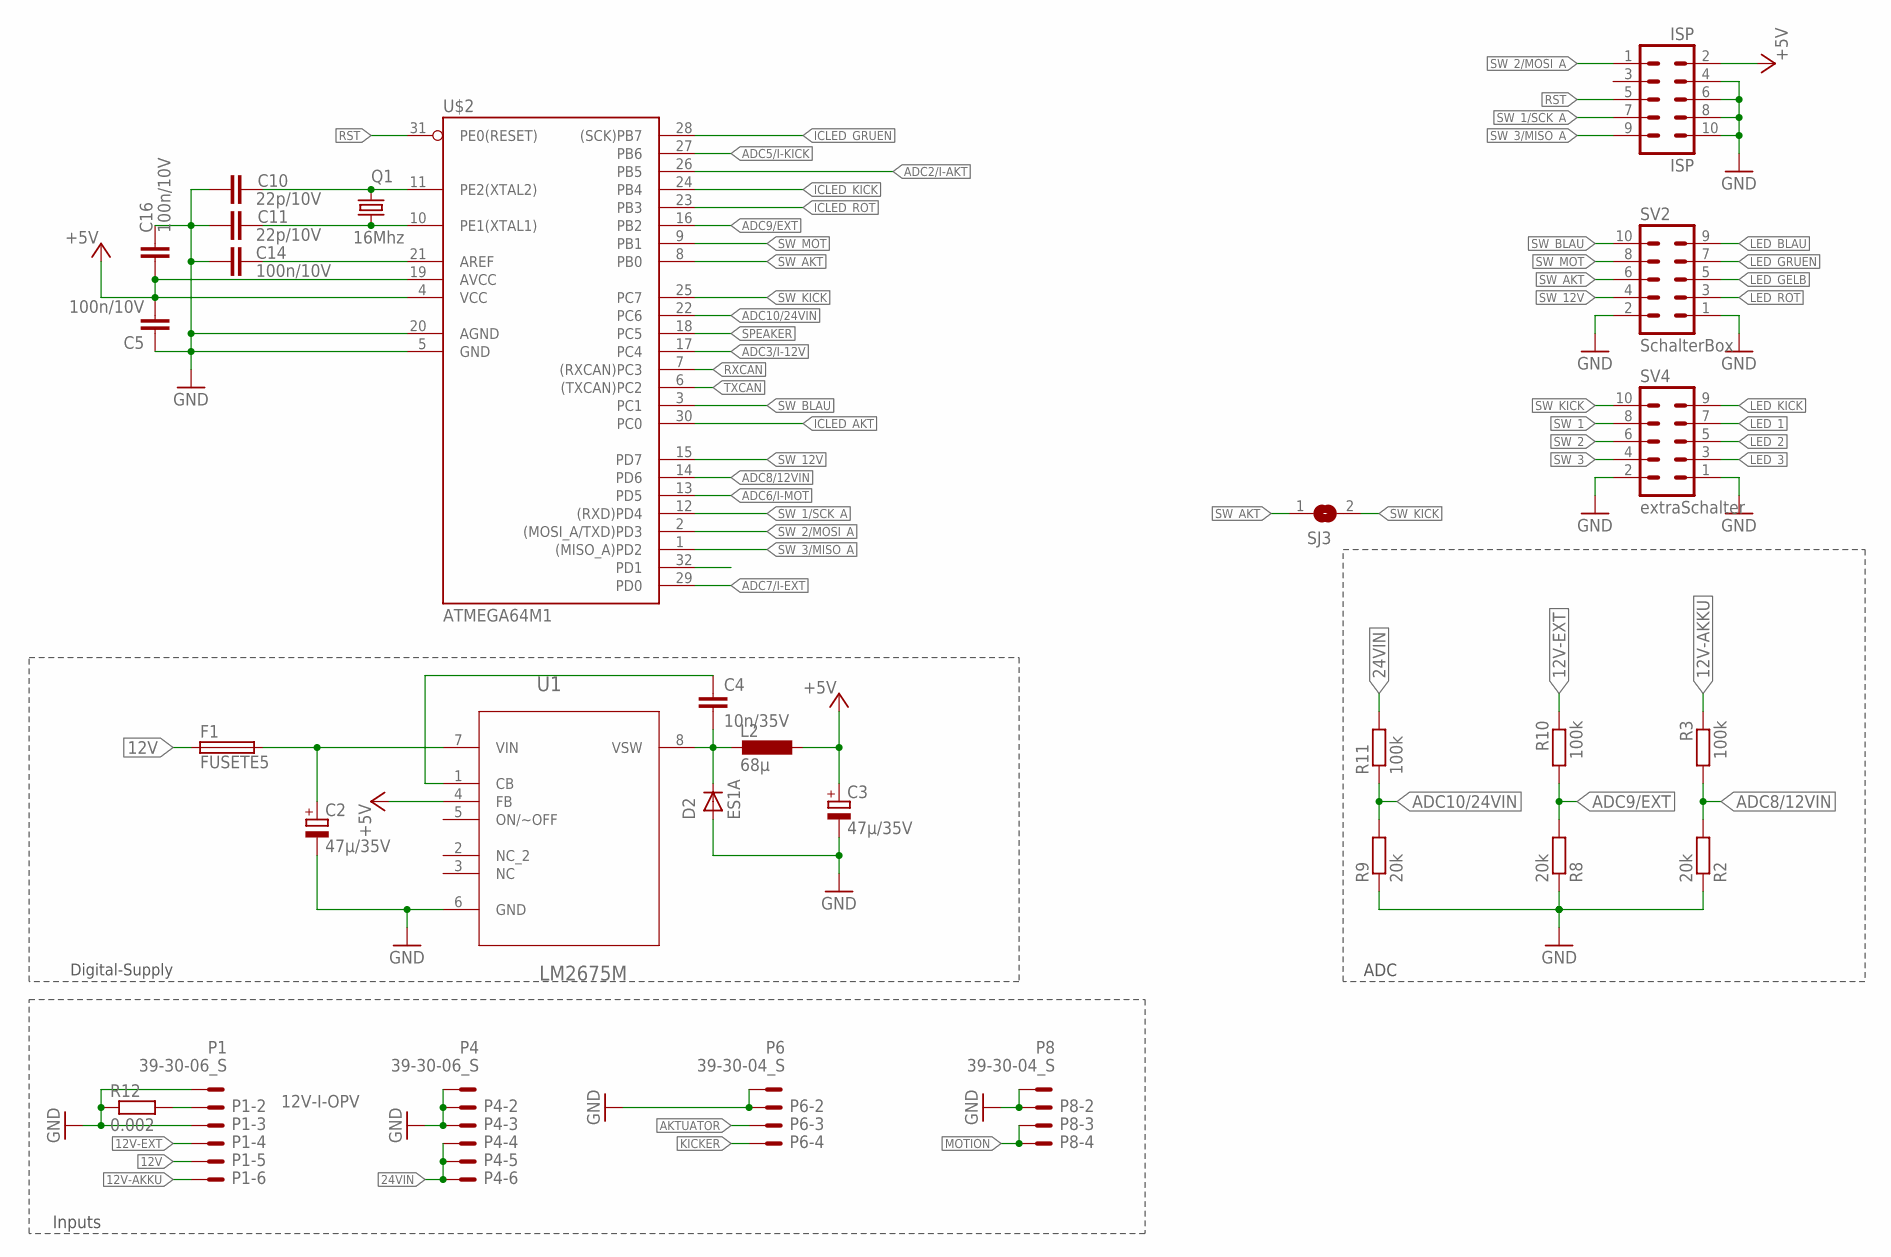
[picture p51: schematic CNC-PowerSwitch-2016-v0.92.sch, sheet 1]

Parts:
C2, C3: 47µ/35V; PANASONIC_D
C4: 10n/35V; C0603
C5, C14, C16: 100n/10V; C0603
C10, C11: 22p/10V; C0603
D2: ES1A; SMA-DO214AC
F1: FUSETE5; TE5
ISP: ISP; ML10
L2: 68µ; PISM
P1, P4: 39-30-06_S; 39-30-?06?
P6, P8: 39-30-04_S; 39-30-?04?
Q1: 16Mhz; HC49UP
R2, R8, R9: 20k; R0805
R3, R10, R11: 100k; R0805
R12: 0.002; R2512
SJ3: SJ
SV2: SchalterBox; ML10
SV4: extraSchalter; ML10
U1: LM2675M; SOIC127P620X175-8N
U$2: ATMEGA64M1; TQFP32-08

Connections:
12V: F1.1, P1.5; also elsewhere on the board
12V-AKKU: P1.6, R3.1; also elsewhere on the board
12V-EXT: P1.4, R10.1; also elsewhere on the board
12V-I-OPV: P1.2, R12.2; also elsewhere on the board
24VIN: P4.4, P4.5, P4.6, R11.2; also elsewhere on the board
+5V: C3.+, C5.2, C16.1, ISP.2, L2.1, U1.4 (FB), U$2.4 (VCC), U$2.19 (AVCC); also elsewhere on the board
ADC2/I-AKT: U$2.26 (PB5); also elsewhere on the board
ADC3/I-12V: U$2.17 (PC4); also elsewhere on the board
ADC5/I-KICK: U$2.27 (PB6); also elsewhere on the board
ADC6/I-MOT: U$2.13 (PD5); also elsewhere on the board
ADC7/I-EXT: U$2.29 (PD0)
ADC8/12VIN: R2.2, R3.2, U$2.14 (PD6)
ADC9/EXT: R8.2, R10.2, U$2.16 (PB2)
ADC10/24VIN: R9.2, R11.1, U$2.22 (PC6)
AKTUATOR: P6.3; also elsewhere on the board
GND: C2.-, C3.-, C5.1, C10.1, C11.1, C14.1, C16.2, D2.A, ISP.4, ISP.6, ISP.8, ISP.10, P1.1, P1.3, P4.1, P4.2, P4.3, P6.1, P6.2, P8.1, P8.2, R2.1, R8.1, R9.1, R12.1, SV2.1, SV2.2, SV4.1, SV4.2, U1.6 (GND), U$2.5 (GND), U$2.20 (AGND); also elsewhere on the board
ICLED_AKT: U$2.30 (PC0); also elsewhere on the board
ICLED_GRUEN: U$2.28 ((SCK)PB7); also elsewhere on the board
ICLED_KICK: U$2.24 (PB4); also elsewhere on the board
ICLED_ROT: U$2.23 (PB3); also elsewhere on the board
KICKER: P6.4; also elsewhere on the board
LED_1: SV4.7
LED_2: SV4.5
LED_3: SV4.3
LED_BLAU: SV2.9; also elsewhere on the board
LED_GELB: SV2.5; also elsewhere on the board
LED_GRUEN: SV2.7; also elsewhere on the board
LED_KICK: SV4.9; also elsewhere on the board
LED_ROT: SV2.3; also elsewhere on the board
MOTION: P8.3, P8.4; also elsewhere on the board
unnamed: C10.2, Q1.2, U$2.11 (PE2(XTAL2))
unnamed: C11.2, Q1.1, U$2.10 (PE1(XTAL1))
unnamed: C14.2, U$2.21 (AREF)
unnamed: C2.+, F1.2, U1.7 (VIN)
unnamed: C4.2, D2.K (C), L2.2, U1.8 (VSW)
unnamed: C4.1, U1.1 (CB)
RST: ISP.5, U$2.31 (PE0(RESET))
RXCAN: U$2.7 ((RXCAN)PC3); also elsewhere on the board
SPEAKER: U$2.18 (PC5); also elsewhere on the board
SW_1: SV4.8
SW_1/SCK_A: ISP.7, U$2.12 ((RXD)PD4)
SW_2: SV4.6
SW_2/MOSI_A: ISP.1, U$2.2 ((MOSI_A/TXD)PD3)
SW_3: SV4.4
SW_3/MISO_A: ISP.9, U$2.1 ((MISO_A)PD2)
SW_12V: SV2.4, U$2.15 (PD7); also elsewhere on the board
SW_AKT: SJ3.1, SV2.6, U$2.8 (PB0); also elsewhere on the board
SW_BLAU: SV2.10, U$2.3 (PC1)
SW_KICK: SJ3.2, SV4.10, U$2.25 (PC7); also elsewhere on the board
SW_MOT: SV2.8, U$2.9 (PB1); also elsewhere on the board
TXCAN: U$2.6 ((TXCAN)PC2); also elsewhere on the board

Notes on the sheet:
Inputs
ADC
Digital-Supply

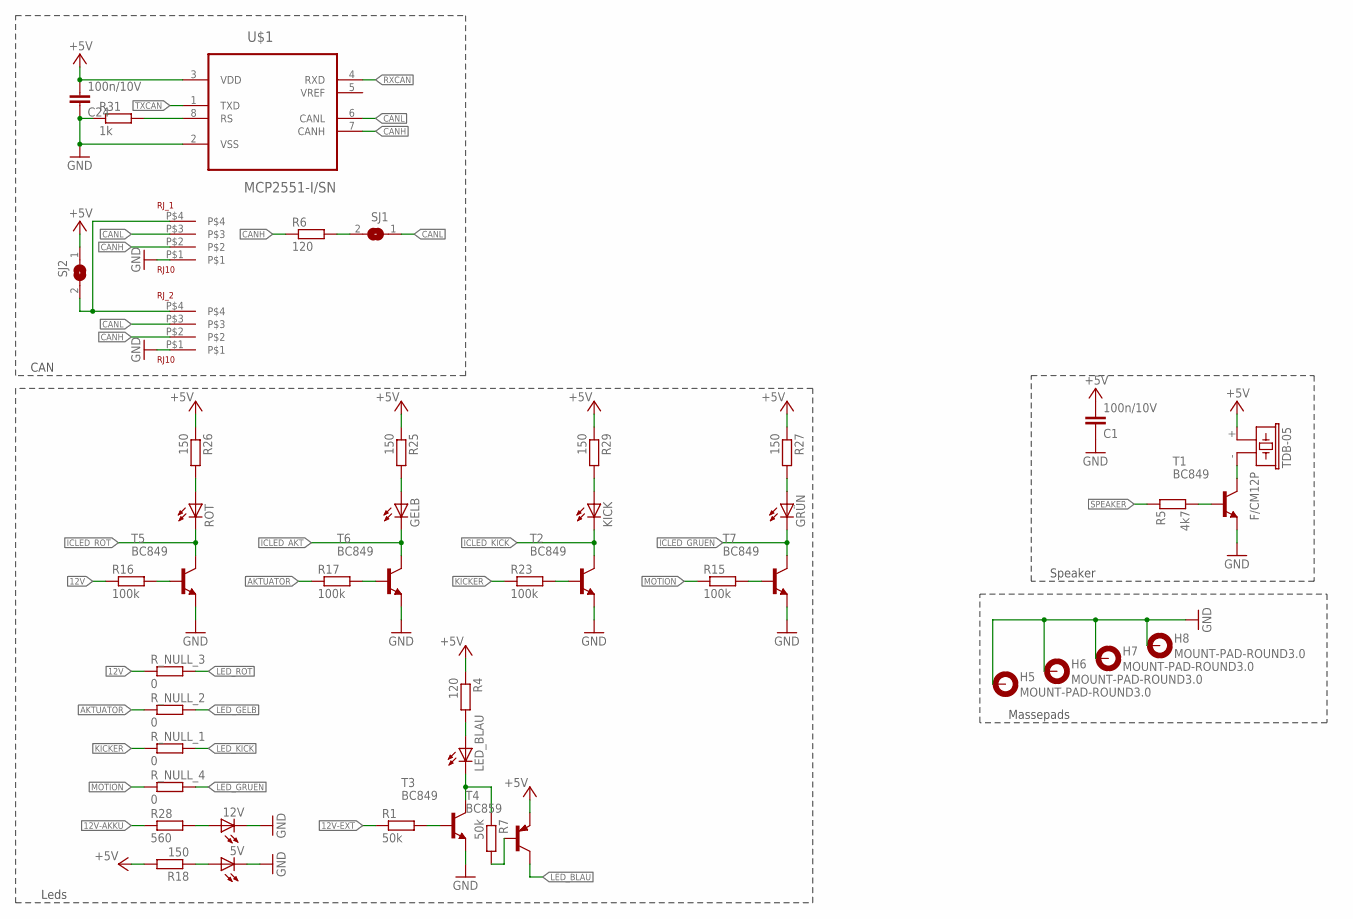
[picture p52: schematic CNC-PowerSwitch-2016-v0.92.sch, sheet 2]

Parts:
5V, 12V: LEDCHIPLED_0805; CHIPLED_0805
C1, C24: 100n/10V; C0603
GELB: LEDCHIPLED_0805; CHIPLED_0805
GRÜN: LEDCHIPLED_0805; CHIPLED_0805
H5, H6, H7, H8: MOUNT-PAD-ROUND3.0; 3,0-PAD
KICK: LEDCHIPLED_0805; CHIPLED_0805
LED_BLAU: LEDCHIPLED_0805; CHIPLED_0805
R1, R7: 50k; R0805
R4: 120; R0805
R5: 4k7; R0805
R6: 120; M0805
R15, R16, R17, R23: 100k; R0805
R18, R25, R26, R27, R29: 150; R0805
R28: 560; R0805
R31: 1k; R0805
RJ_1, RJ_2: RJ10
ROT: LEDCHIPLED_0805; CHIPLED_0805
R_NULL_1, R_NULL_2, R_NULL_3, R_NULL_4: 0; R0402
SJ1, SJ2: SJ
T1, T2, T3, T5, T6, T7: BC849; SOT23
T4: BC859; SOT23-BEC
TDB-05: F/CM12P
U$1: MCP2551-I/SN; SOIC127P600X175-8N

Connections:
12V: R16.1, R_NULL_3.1; also elsewhere on the board
12V-AKKU: R28.1; also elsewhere on the board
12V-EXT: R1.1; also elsewhere on the board
+5V: C1.2, C24.2, R4.1, R18.2, R25.1, R26.1, R27.1, R29.1, SJ2.1, T4.E, TDB-05.+ (1), U$1.3 (VDD); also elsewhere on the board
AKTUATOR: R17.1, R_NULL_2.1; also elsewhere on the board
CANH: R6.1, RJ_1.P$2, RJ_2.P$2, U$1.7 (CANH)
CANL: RJ_1.P$3, RJ_2.P$3, SJ1.1, U$1.6 (CANL)
GND: 5V.C, 12V.C, C1.1, C24.1, H5.B3,0, H6.B3,0, H7.B3,0, H8.B3,0, R31.1, RJ_1.P$1, RJ_2.P$1, T1.2 (E), T2.2 (E), T3.2 (E), T5.2 (E), T6.2 (E), T7.2 (E), U$1.2 (VSS); also elsewhere on the board
ICLED_AKT: GELB.C, T6.3 (C); also elsewhere on the board
ICLED_GRUEN: GRÜN.C, T7.3 (C); also elsewhere on the board
ICLED_KICK: KICK.C, T2.3 (C); also elsewhere on the board
ICLED_ROT: ROT.C, T5.3 (C); also elsewhere on the board
KICKER: R23.1, R_NULL_1.1; also elsewhere on the board
LED_BLAU: T4.C; also elsewhere on the board
LED_GELB: R_NULL_2.2; also elsewhere on the board
LED_GRUEN: R_NULL_4.2; also elsewhere on the board
LED_KICK: R_NULL_1.2; also elsewhere on the board
LED_ROT: R_NULL_3.2; also elsewhere on the board
MOTION: R15.1, R_NULL_4.1; also elsewhere on the board
unnamed: R5.2, T1.1 (B)
unnamed: RJ_1.P$4, RJ_2.P$4, SJ2.2
unnamed: R23.2, T2.1 (B)
unnamed: KICK.A, R29.2
unnamed: R31.2, U$1.8 (RS)
unnamed: R6.2, SJ1.2
unnamed: GELB.A, R25.2
unnamed: R26.2, ROT.A
unnamed: R1.2, T3.1 (B)
unnamed: LED_BLAU.A, R4.2
unnamed: LED_BLAU.C, R7.1, T3.3 (C)
unnamed: R7.2, T4.B
unnamed: T1.3 (C), TDB-05.- (2)
unnamed: GRÜN.A, R27.2
unnamed: 12V.A, R28.2
unnamed: R16.2, T5.1 (B)
unnamed: R17.2, T6.1 (B)
unnamed: R15.2, T7.1 (B)
unnamed: 5V.A, R18.1
RXCAN: U$1.4 (RXD); also elsewhere on the board
SPEAKER: R5.1; also elsewhere on the board
TXCAN: U$1.1 (TXD); also elsewhere on the board

Notes on the sheet:
CAN
Speaker
Massepads
Leds

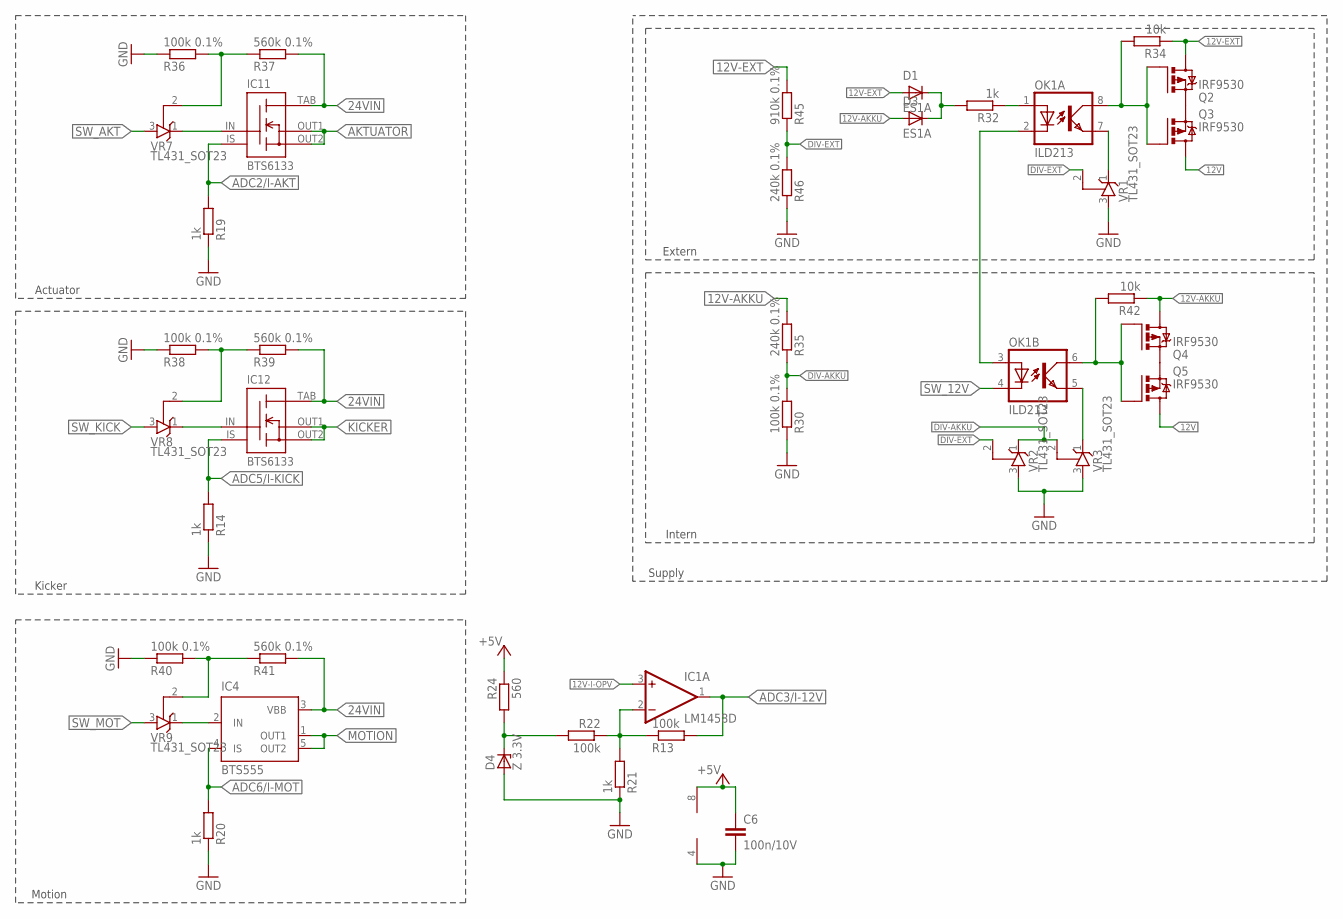
[picture p53: schematic CNC-PowerSwitch-2016-v0.92.sch, sheet 3]

Parts:
C6: 100n/10V; C0603
D1, D3: ES1A; SMA-DO214AC
D4: Z 3.3V; SOT23
IC1: LM1458D; SO08
IC4: BTS555; TO220-51
IC11, IC12: BTS6133; TO252-51
OK1: ILD213; SOIC08
Q2, Q3, Q4, Q5: IRF9530; TO220BV
R13, R22: 100k; R0805
R14, R19, R20, R21, R32: 1k; R0805
R24: 560; R0805
R30, R36, R38, R40: 100k 0.1%; R0805
R34, R42: 10k; R0805
R35, R46: 240k 0.1%; R0805
R37, R39, R41: 560k 0.1%; R0805
R45: 910k 0.1%; R0805
VR1, VR2, VR3, VR7, VR8, VR9: TL431_SOT23; SOT23

Connections:
12V: Q3.D, Q5.D; also elsewhere on the board
12V-AKKU: D3.A, Q4.D, R35.2, R42.1; also elsewhere on the board
12V-EXT: D1.A, Q2.D, R34.1, R45.2; also elsewhere on the board
12V-I-OPV: IC1.3 (+IN); also elsewhere on the board
24VIN: IC4.3 (VBB), IC11.TAB (VBB), IC12.TAB (VBB), R37.2, R39.2, R41.2; also elsewhere on the board
+5V: C6.1, IC1.8 (V+), R24.1; also elsewhere on the board
ADC2/I-AKT: IC11.IS, R19.2; also elsewhere on the board
ADC3/I-12V: IC1.1 (OUT), R13.2; also elsewhere on the board
ADC5/I-KICK: IC12.IS, R14.2; also elsewhere on the board
ADC6/I-MOT: IC4.4 (IS), R20.2; also elsewhere on the board
AKTUATOR: IC11.OUT1 (OUT), IC11.OUT2 (OUT); also elsewhere on the board
DIV-AKKU: R30.2, R35.1, VR2.1 (C), VR3.2 (R)
DIV-EXT: R45.1, R46.2, VR1.2 (R), VR2.2 (R)
GND: C6.2, D4.1 (A), IC1.4 (V-), R14.1, R19.1, R20.1, R21.1, R30.1, R36.1, R38.1, R40.1, R46.1, VR1.3 (A), VR2.3 (A), VR3.3 (A); also elsewhere on the board
KICKER: IC12.OUT1 (OUT), IC12.OUT2 (OUT); also elsewhere on the board
MOTION: IC4.1 (OUT1), IC4.5 (OUT2); also elsewhere on the board
unnamed: OK1.1 (A), R32.1
unnamed: OK1.7 (EMIT), VR1.1 (C)
unnamed: OK1.2 (C), OK1.3 (A)
unnamed: IC1.2 (-IN), R13.1, R21.2, R22.1
unnamed: D4.3 (C), R22.2, R24.2
unnamed: Q2.S, Q3.S
unnamed: OK1.6 (COL), Q4.G, Q5.G, R42.2
unnamed: Q4.S, Q5.S
unnamed: OK1.5 (EMIT), VR3.1 (C)
unnamed: D1.K (C), D3.K (C), R32.2
unnamed: IC12.IN, VR8.1 (C)
unnamed: IC4.2 (IN), VR9.1 (C)
unnamed: IC11.IN, VR7.1 (C)
unnamed: R36.2, R37.1, VR7.2 (R)
unnamed: R38.2, R39.1, VR8.2 (R)
unnamed: R40.2, R41.1, VR9.2 (R)
unnamed: OK1.8 (COL), Q2.G, Q3.G, R34.2
SW_12V: OK1.4 (C); also elsewhere on the board
SW_AKT: VR7.3 (A); also elsewhere on the board
SW_KICK: VR8.3 (A); also elsewhere on the board
SW_MOT: VR9.3 (A); also elsewhere on the board

Notes on the sheet:
Intern
Extern
Supply
Motion
Kicker
Actuator

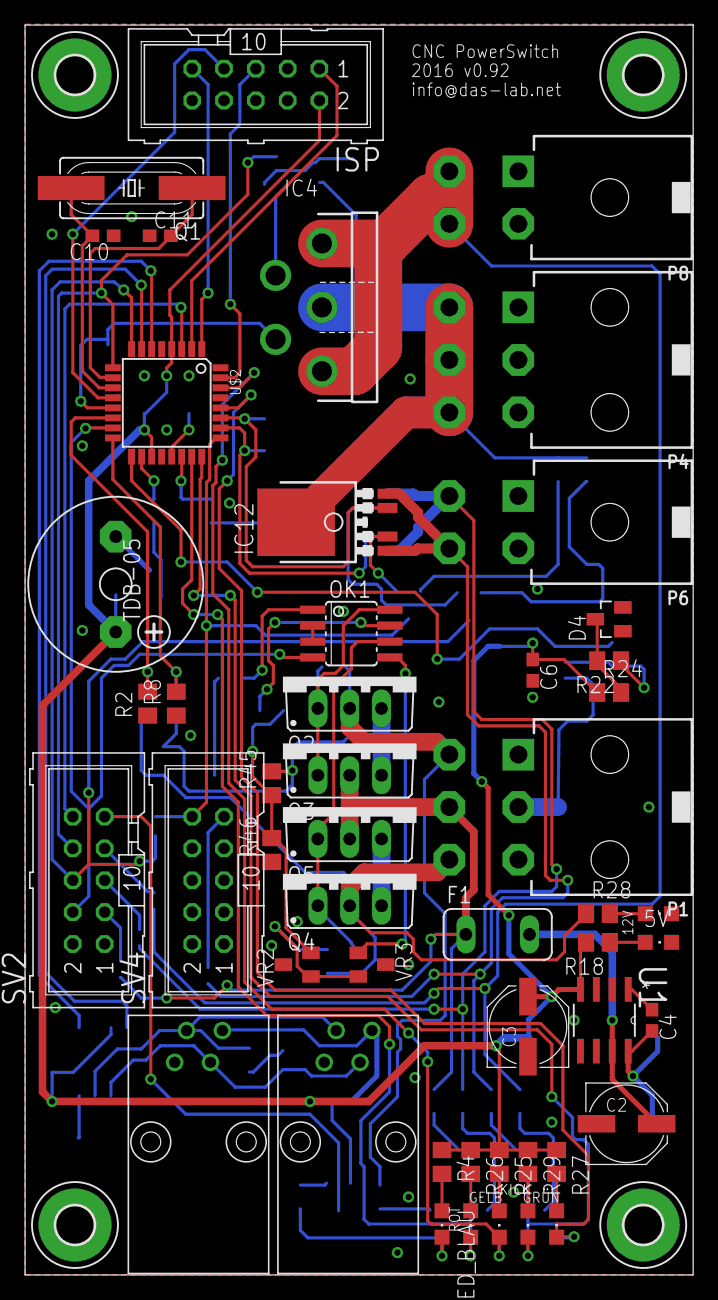
[picture p54: board CNC-PowerSwitch-2016-v0.92.brd from above]

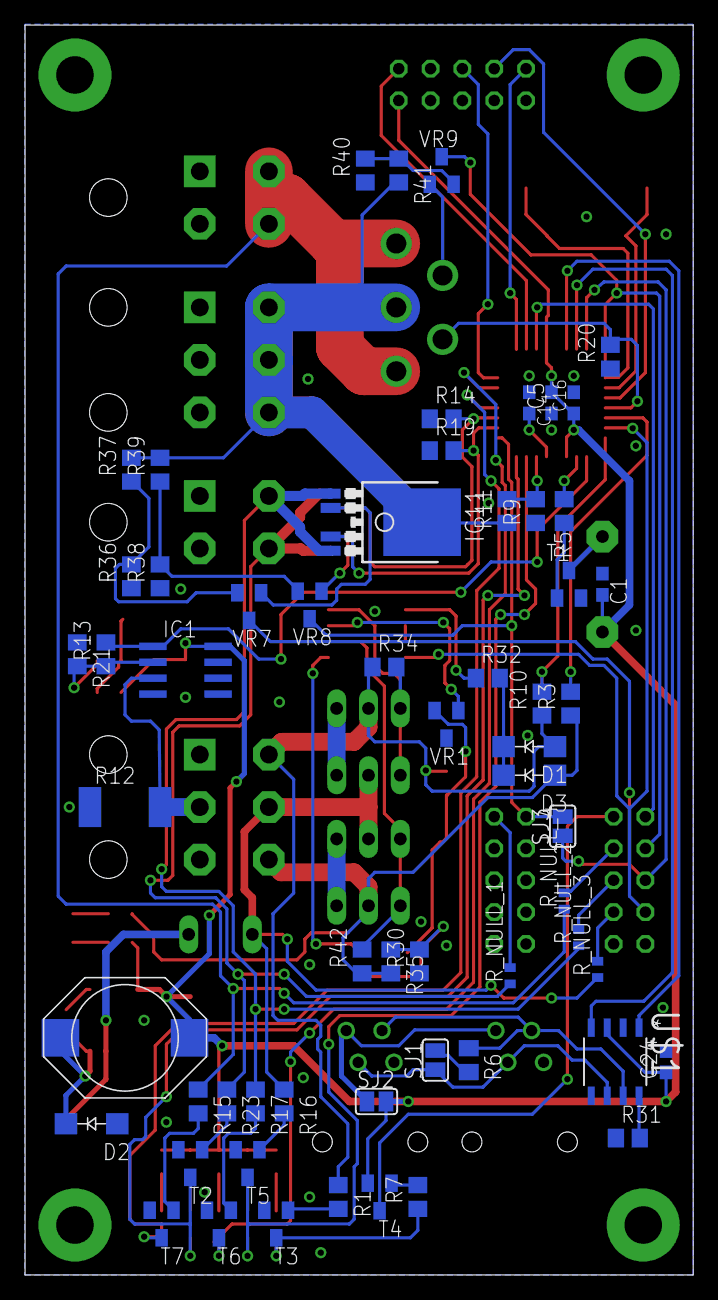
[picture p55: board CNC-PowerSwitch-2016-v0.92.brd from below]

Board: 2 copper layers, 53.3 x 99.7 mm, 114 parts (60 on the bottom side), 84 nets.
