carpe-noctem-cassel/cnc-circuit-boards/powerSwitch/pcb/Project-PowerSwitch-Final.brd

## EAGLE design powerSwitch/pcb/Project-PowerSwitch-Final.brd (2016-11-18)

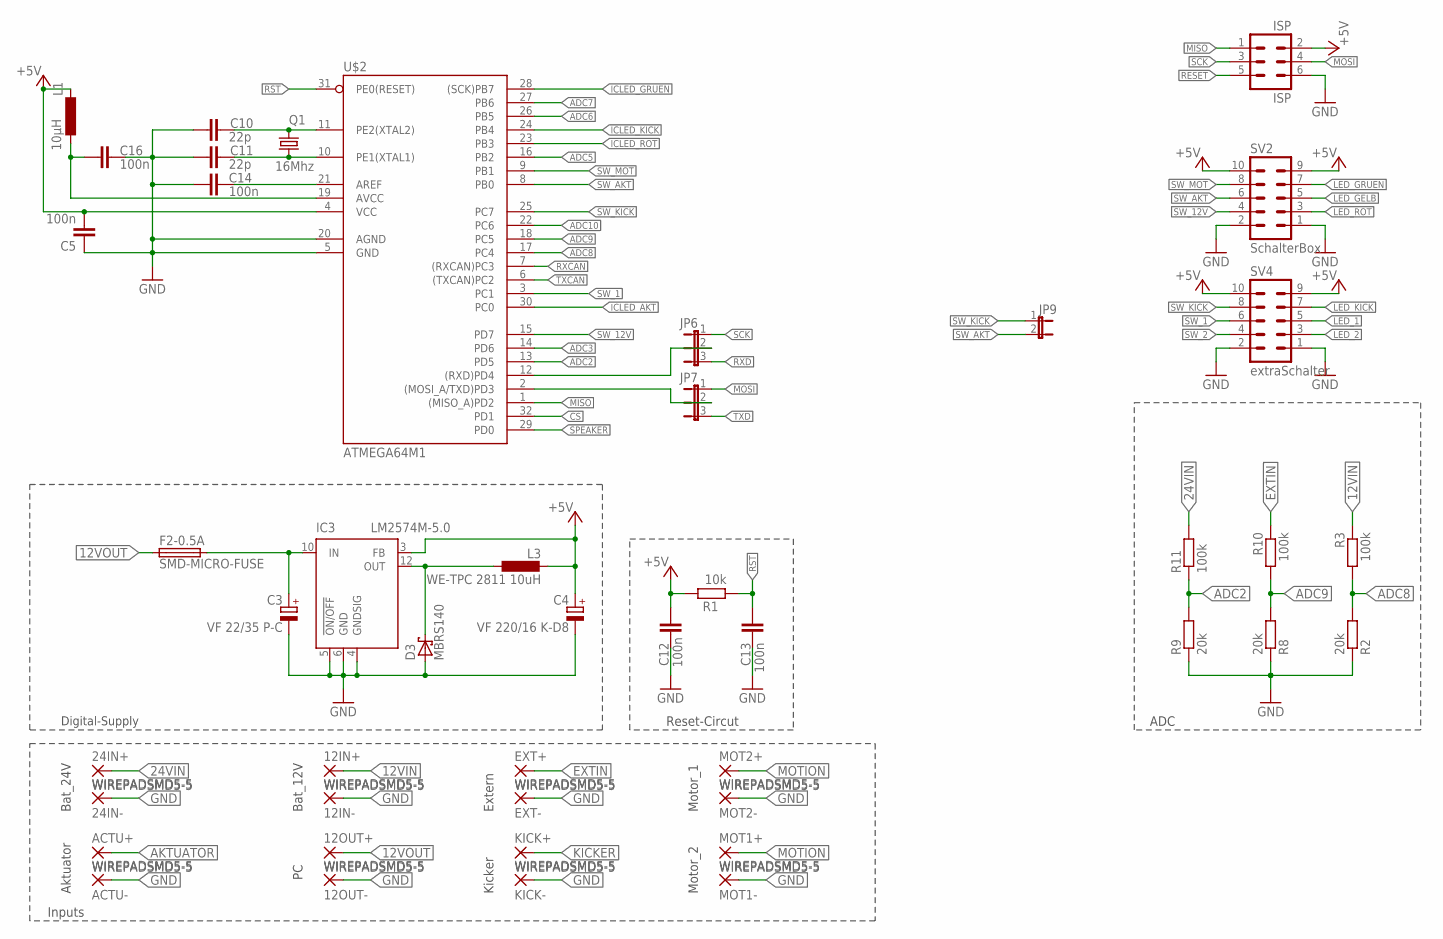
[picture p56: schematic Project-PowerSwitch-Final.sch, sheet 1]

Parts:
12IN+, 12IN-, 12OUT+, 12OUT-, 24IN+, 24IN-: WIREPADSMD5-5; 5-5
ACTU+: WIREPADSMD5-5; 5-5
ACTU-: WIREPADSMD5-5; 5-5
C3: VF 22/35 P-C; PANASONIC_C
C4: VF 220/16 K-D8; PANASONIC_D
C5, C12, C13, C14, C16: 100n; C0603K
C10, C11: 22p; C0603K
D3: MBRS140; SMB
EXT+: WIREPADSMD5-5; 5-5
EXT-: WIREPADSMD5-5; 5-5
F2-0.5A: SMD-MICRO-FUSE; SMD-6,1X2,6
IC3: LM2574M-5.0; SO14W
ISP: ISP; ML6
JP6, JP7: JP2E; JP2
JP9: JP1E; JP1
KICK+: WIREPADSMD5-5; 5-5
KICK-: WIREPADSMD5-5; 5-5
L1: 10µH; R0805
L3: WE-TPC 2811 10uH; POWER-CHOKE_WE-TPC
MOT1+, MOT1-, MOT2+, MOT2-: WIREPADSMD5-5; 5-5
Q1: 16Mhz; HC49U-V@1
R1: 10k; R0805
R2, R8, R9: 20k; R0805
R3, R10, R11: 100k; R0805
SV2: SchalterBox; ML10
SV4: extraSchalter; ML10
U$2: ATMEGA64M1; TQFP32-08

Connections:
12VIN: 12IN+.P$1, R3.1; also elsewhere on the board
12VOUT: 12OUT+.P$1, F2-0.5A.1; also elsewhere on the board
24VIN: 24IN+.P$1, R11.2; also elsewhere on the board
+5V: C4.+, C5.2, C12.2, IC3.3 (FB), ISP.2, L1.2, L3.2, R1.2, SV2.9, SV2.10, SV4.9, SV4.10, U$2.4 (VCC); also elsewhere on the board
ADC2: R9.2, R11.1, U$2.13 (PD5)
ADC3: U$2.14 (PD6); also elsewhere on the board
ADC5: U$2.16 (PB2); also elsewhere on the board
ADC6: U$2.26 (PB5); also elsewhere on the board
ADC7: U$2.27 (PB6); also elsewhere on the board
ADC8: R2.2, R3.2, U$2.17 (PC4)
ADC9: R8.2, R10.2, U$2.18 (PC5)
ADC10: U$2.22 (PC6); also elsewhere on the board
AKTUATOR: ACTU+.P$1; also elsewhere on the board
CS: U$2.32 (PD1)
EXTIN: EXT+.P$1, R10.1; also elsewhere on the board
GND: 12IN-.P$1, 12OUT-.P$1, 24IN-.P$1, ACTU-.P$1, C3.-, C4.-, C5.1, C10.1, C11.1, C12.1, C13.1, C14.1, C16.2, D3.A, EXT-.P$1, IC3.4 (GNDSIG), IC3.5 (!ON/OFF), IC3.6 (GND), ISP.6, KICK-.P$1, MOT1-.P$1, MOT2-.P$1, R2.1, R8.1, R9.1, SV2.1, SV2.2, SV4.1, SV4.2, U$2.5 (GND), U$2.20 (AGND); also elsewhere on the board
ICLED_AKT: U$2.30 (PC0); also elsewhere on the board
ICLED_GRUEN: U$2.28 ((SCK)PB7); also elsewhere on the board
ICLED_KICK: U$2.24 (PB4); also elsewhere on the board
ICLED_ROT: U$2.23 (PB3); also elsewhere on the board
KICKER: KICK+.P$1; also elsewhere on the board
LED_1: SV4.5
LED_2: SV4.3
LED_GELB: SV2.5; also elsewhere on the board
LED_GRUEN: SV2.7; also elsewhere on the board
LED_KICK: SV4.7; also elsewhere on the board
LED_ROT: SV2.3; also elsewhere on the board
MISO: ISP.1, U$2.1 ((MISO_A)PD2)
MOSI: ISP.4, JP7.1
MOTION: MOT1+.P$1, MOT2+.P$1; also elsewhere on the board
unnamed: C10.2, Q1.2, U$2.11 (PE2(XTAL2))
unnamed: C11.2, Q1.1, U$2.10 (PE1(XTAL1))
unnamed: C14.2, U$2.21 (AREF)
unnamed: C16.1, L1.1, U$2.19 (AVCC)
unnamed: JP6.2, U$2.12 ((RXD)PD4)
unnamed: JP7.2, U$2.2 ((MOSI_A/TXD)PD3)
unnamed: C3.+, F2-0.5A.2, IC3.10 (IN)
unnamed: D3.C, IC3.12 (OUT), L3.1
RESET: ISP.5
RST: C13.2, R1.1, U$2.31 (PE0(RESET))
RXCAN: U$2.7 ((RXCAN)PC3); also elsewhere on the board
RXD: JP6.3; also elsewhere on the board
SCK: ISP.3, JP6.1
SPEAKER: U$2.29 (PD0); also elsewhere on the board
SW_1: SV4.6, U$2.3 (PC1)
SW_2: SV4.4
SW_12V: SV2.4, U$2.15 (PD7); also elsewhere on the board
SW_AKT: JP9.2, SV2.6, U$2.8 (PB0); also elsewhere on the board
SW_KICK: JP9.1, SV4.8, U$2.25 (PC7); also elsewhere on the board
SW_MOT: SV2.8, U$2.9 (PB1); also elsewhere on the board
TXCAN: U$2.6 ((TXCAN)PC2); also elsewhere on the board
TXD: JP7.3; also elsewhere on the board

Notes on the sheet:
Reset-Circut
Inputs
ADC
Digital-Supply
Motor_1
Motor_2
Extern
Kicker
Bat_12V
Bat_24V
Aktuator

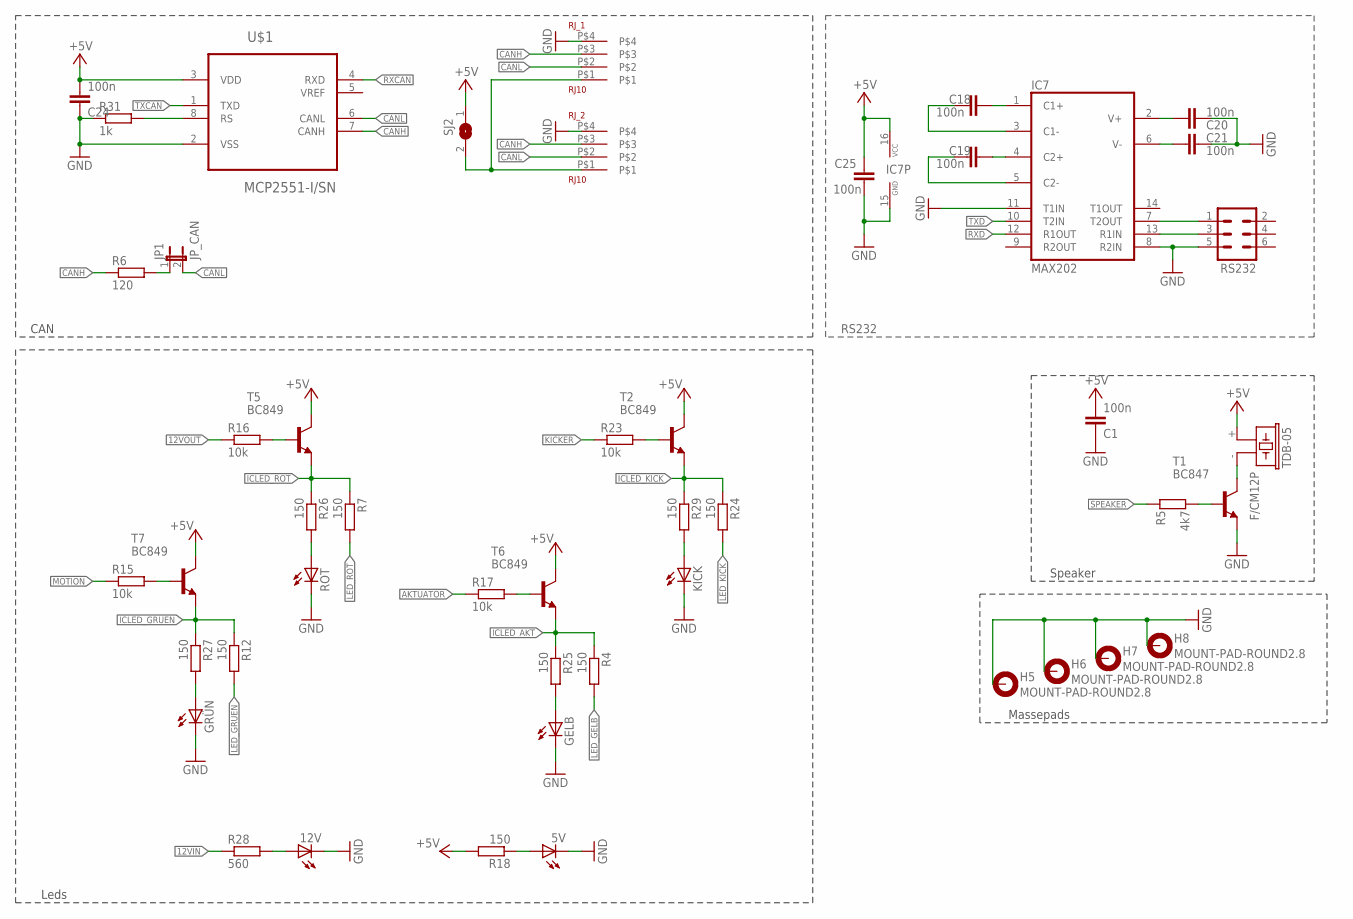
[picture p57: schematic Project-PowerSwitch-Final.sch, sheet 2]

Parts:
5V, 12V: LEDCHIPLED_0805; CHIPLED_0805
C1, C24: 100n; C0603
C18, C19, C20, C21, C25: 100n; C0603K
GELB: LEDCHIPLED_0805; CHIPLED_0805
GRÜN: LEDCHIPLED_0805; CHIPLED_0805
H5, H6, H7, H8: MOUNT-PAD-ROUND2.8; 2,8-PAD
IC7: MAX202; SO16
JP1: JP_CAN; JP1
KICK: LEDCHIPLED_0805; CHIPLED_0805
R4, R7, R12, R18, R24, R25, R26, R27, R29: 150; R0805
R5: 4k7; R0805
R6: 120; M0805
R15, R16, R17, R23: 10k; R0805
R28: 560; R0805
R31: 1k; R0805
RJ_1, RJ_2: RJ10
ROT: LEDCHIPLED_0805; CHIPLED_0805
RS232: ML6
SJ2: SJ
T1: BC847; SOT23
T2, T5, T6, T7: BC849; SOT23
TDB-05: F/CM12P
U$1: MCP2551-I/SN; SOIC127P600X175-8N

Connections:
12VIN: R28.1; also elsewhere on the board
12VOUT: R16.1; also elsewhere on the board
+5V: C1.2, C24.2, C25.1, IC7.16 (VCC), R18.2, SJ2.1, T2.3 (C), T5.3 (C), T6.3 (C), T7.3 (C), TDB-05.+ (1), U$1.3 (VDD); also elsewhere on the board
AKTUATOR: R17.1; also elsewhere on the board
CANH: R6.1, RJ_1.P$3, RJ_2.P$3, U$1.7 (CANH)
CANL: JP1.2, RJ_1.P$2, RJ_2.P$2, U$1.6 (CANL)
GND: 5V.C, 12V.C, C1.1, C20.2, C21.2, C24.1, C25.2, GELB.C, GRÜN.C, H5.B2,8, H6.B2,8, H7.B2,8, H8.B2,8, IC7.8 (R2IN), IC7.11 (T1IN), IC7.15 (GND), KICK.C, R31.1, RJ_1.P$4, RJ_2.P$4, ROT.C, RS232.5, T1.2 (E), U$1.2 (VSS); also elsewhere on the board
ICLED_AKT: R4.1, R25.1, T6.2 (E); also elsewhere on the board
ICLED_GRUEN: R12.1, R27.1, T7.2 (E); also elsewhere on the board
ICLED_KICK: R24.1, R29.1, T2.2 (E); also elsewhere on the board
ICLED_ROT: R7.1, R26.1, T5.2 (E); also elsewhere on the board
KICKER: R23.1; also elsewhere on the board
LED_GELB: R4.2; also elsewhere on the board
LED_GRUEN: R12.2; also elsewhere on the board
LED_KICK: R24.2; also elsewhere on the board
LED_ROT: R7.2; also elsewhere on the board
MOTION: R15.1; also elsewhere on the board
unnamed: R5.2, T1.1 (B)
unnamed: RJ_1.P$1, RJ_2.P$1, SJ2.2
unnamed: R23.2, T2.1 (B)
unnamed: KICK.A, R29.2
unnamed: R31.2, U$1.8 (RS)
unnamed: JP1.1, R6.2
unnamed: GELB.A, R25.2
unnamed: R26.2, ROT.A
unnamed: C18.2, IC7.1 (C1+)
unnamed: C19.2, IC7.4 (C2+)
unnamed: T1.3 (C), TDB-05.- (2)
unnamed: GRÜN.A, R27.2
unnamed: 12V.A, R28.2
unnamed: C18.1, IC7.3 (C1-)
unnamed: C19.1, IC7.5 (C2-)
unnamed: C20.1, IC7.2 (V+)
unnamed: C21.1, IC7.6 (V-)
unnamed: IC7.13 (R1IN), RS232.3
unnamed: IC7.7 (T2OUT), RS232.1
unnamed: R16.2, T5.1 (B)
unnamed: R17.2, T6.1 (B)
unnamed: R15.2, T7.1 (B)
unnamed: 5V.A, R18.1
RXCAN: U$1.4 (RXD); also elsewhere on the board
RXD: IC7.12 (R1OUT); also elsewhere on the board
SPEAKER: R5.1; also elsewhere on the board
TXCAN: U$1.1 (TXD); also elsewhere on the board
TXD: IC7.10 (T2IN); also elsewhere on the board

Notes on the sheet:
CAN
RS232
Speaker
Massepads
Leds

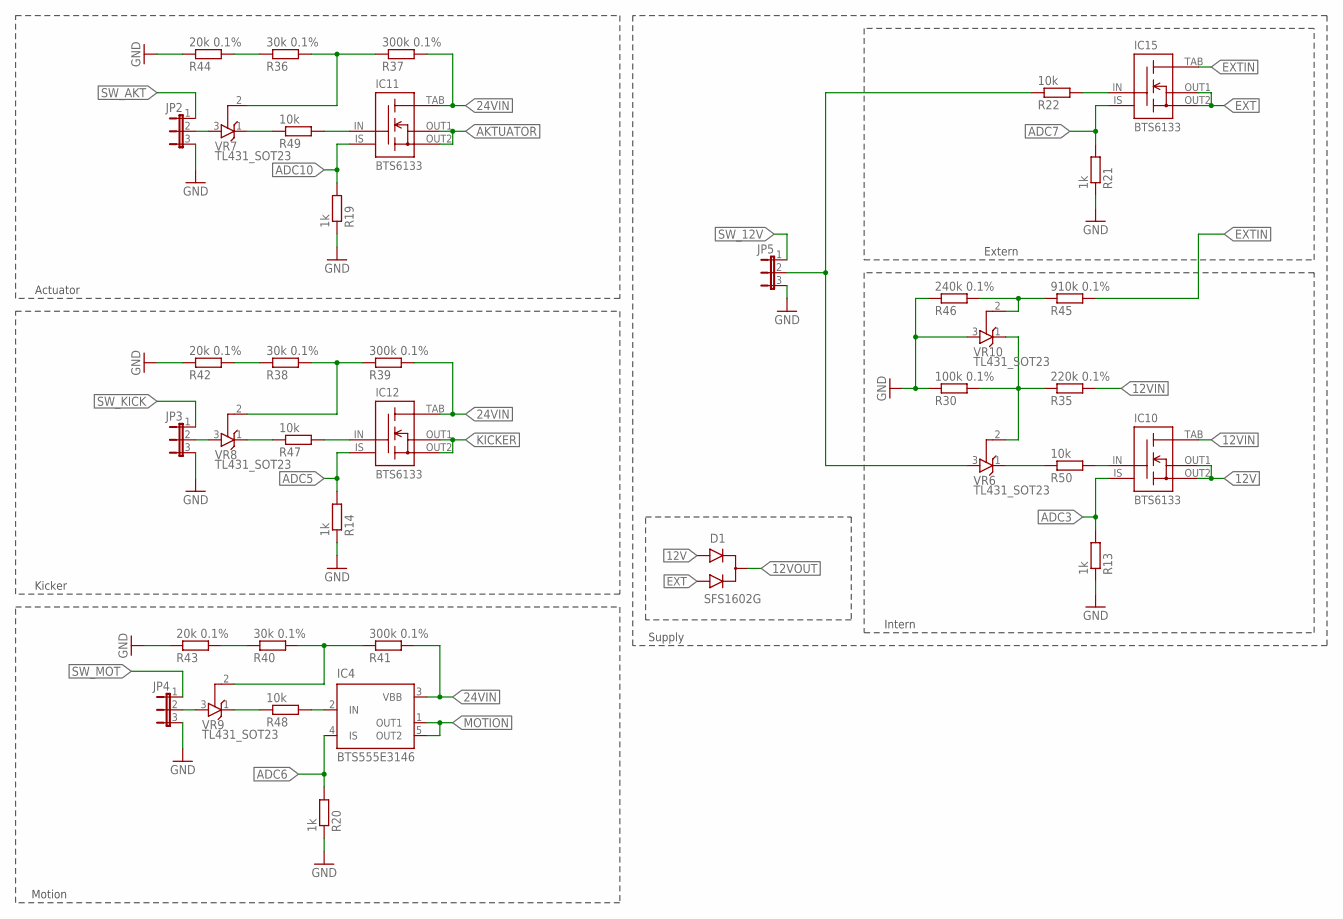
[picture p58: schematic Project-PowerSwitch-Final.sch, sheet 3]

Parts:
D1: SFS1602G; D2PAK
IC4: BTS555E3146; TO220-52
IC10, IC11, IC12, IC15: BTS6133; TO252-51
JP2, JP3, JP4, JP5: JP2E; JP2
R13, R14, R19, R20, R21: 1k; R0805
R22, R47, R48, R49, R50: 10k; R0805
R30: 100k 0.1%; R0805
R35: 220k 0.1%; R0805
R36, R38, R40: 30k 0.1%; R0805
R37, R39, R41: 300k 0.1%; R0805
R42, R43, R44: 20k 0.1%; R0805
R45: 910k 0.1%; R0805
R46: 240k 0.1%; R0805
VR6, VR7, VR8, VR9, VR10: TL431_SOT23; SOT23

Connections:
12V: D1.P$1, IC10.OUT1 (OUT), IC10.OUT2 (OUT)
12VIN: IC10.TAB (VBB), R35.2; also elsewhere on the board
12VOUT: D1.P$3; also elsewhere on the board
24VIN: IC4.3 (VBB), IC11.TAB (VBB), IC12.TAB (VBB), R37.2, R39.2, R41.2; also elsewhere on the board
ADC3: IC10.IS, R13.2; also elsewhere on the board
ADC5: IC12.IS, R14.2; also elsewhere on the board
ADC6: IC4.4 (IS), R20.2; also elsewhere on the board
ADC7: IC15.IS, R21.2; also elsewhere on the board
ADC10: IC11.IS, R19.2; also elsewhere on the board
AKTUATOR: IC11.OUT1 (OUT), IC11.OUT2 (OUT); also elsewhere on the board
EXT: D1.P$2, IC15.OUT1 (OUT), IC15.OUT2 (OUT)
EXTIN: IC15.TAB (VBB), R45.2; also elsewhere on the board
GND: JP2.3, JP3.3, JP4.3, JP5.3, R13.1, R14.1, R19.1, R20.1, R21.1, R30.1, R42.1, R43.1, R44.1, R46.1, VR10.3 (A); also elsewhere on the board
KICKER: IC12.OUT1 (OUT), IC12.OUT2 (OUT); also elsewhere on the board
MOTION: IC4.1 (OUT1), IC4.5 (OUT2); also elsewhere on the board
unnamed: IC15.IN, R22.2
unnamed: JP2.2, VR7.3 (A)
unnamed: JP4.2, VR9.3 (A)
unnamed: JP3.2, VR8.3 (A)
unnamed: JP5.2, R22.1, VR6.3 (A)
unnamed: IC10.IN, R50.2
unnamed: R30.2, R35.1, VR6.2 (R), VR10.1 (C)
unnamed: R49.1, VR7.1 (C)
unnamed: R36.2, R37.1, VR7.2 (R)
unnamed: IC12.IN, R47.2
unnamed: R38.2, R39.1, VR8.2 (R)
unnamed: R40.2, R41.1, VR9.2 (R)
unnamed: IC4.2 (IN), R48.2
unnamed: R38.1, R42.2
unnamed: R40.1, R43.2
unnamed: R36.1, R44.2
unnamed: R45.1, R46.2, VR10.2 (R)
unnamed: R47.1, VR8.1 (C)
unnamed: R48.1, VR9.1 (C)
unnamed: IC11.IN, R49.2
unnamed: R50.1, VR6.1 (C)
SW_12V: JP5.1; also elsewhere on the board
SW_AKT: JP2.1; also elsewhere on the board
SW_KICK: JP3.1; also elsewhere on the board
SW_MOT: JP4.1; also elsewhere on the board

Notes on the sheet:
Intern
Extern
Supply
Motion
Kicker
Actuator

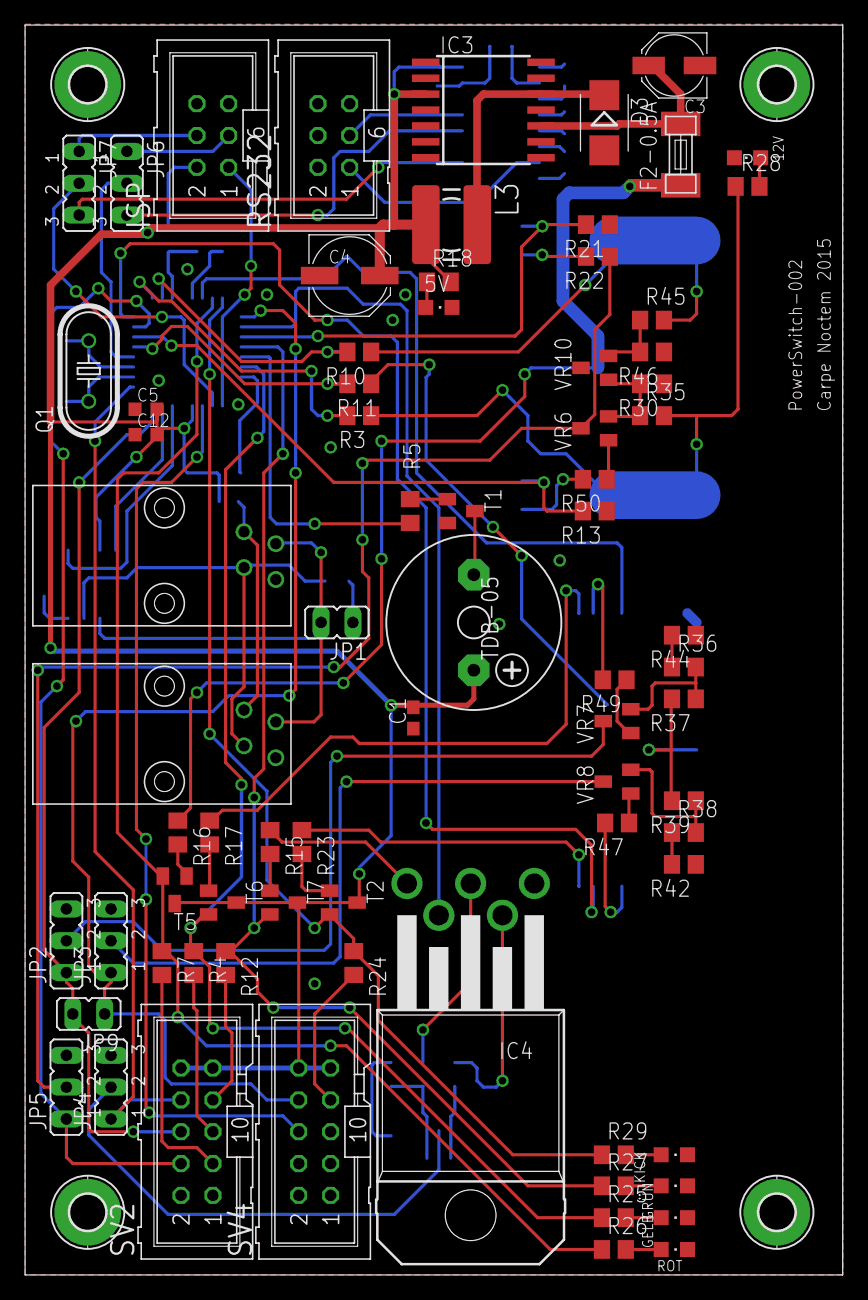
[picture p59: board Project-PowerSwitch-Final.brd from above]

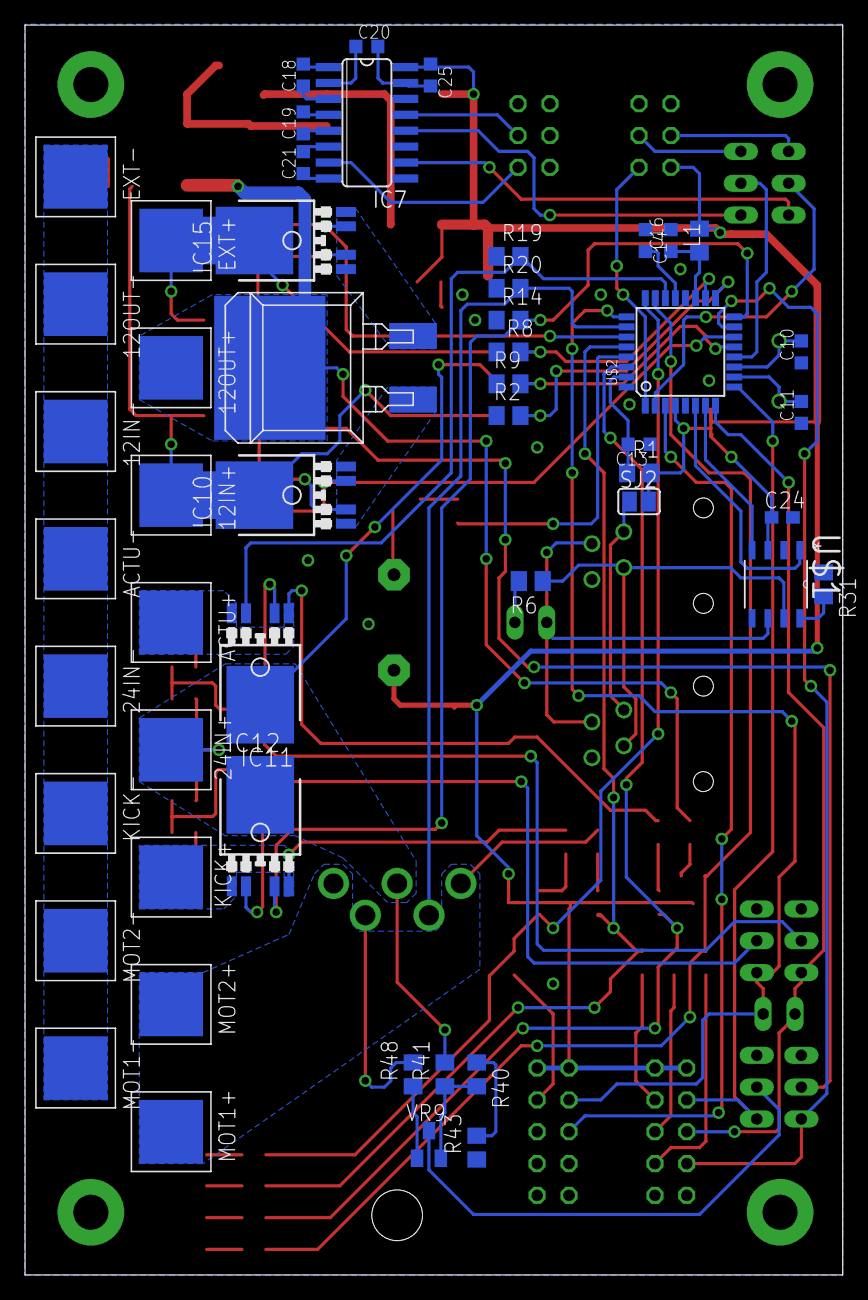
[picture p60: board Project-PowerSwitch-Final.brd from below]

Board: 4 copper layers, 65.3 x 99.7 mm, 130 parts (51 on the bottom side), 95 nets.
