carpe-noctem-cassel/cnc-circuit-boards/kicker/rekick2015/pcb/rekick2015-Resonant-Prototyp-fixed.brd

## EAGLE design kicker/rekick2015/pcb/rekick2015-Resonant-Prototyp-fixed.brd (2016-11-18)

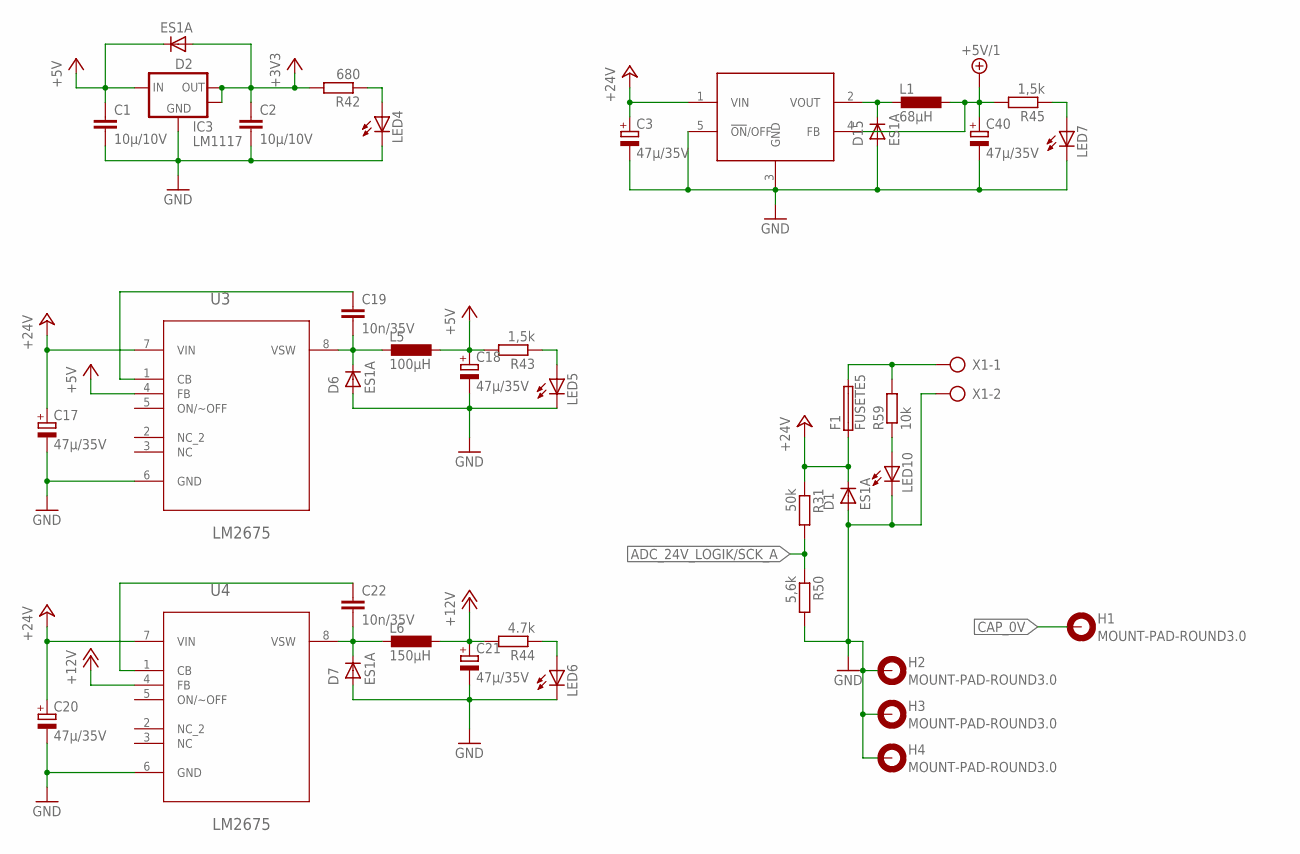
[picture p61: schematic rekick2015-Resonant-Prototyp-fixed.sch, sheet 1, Spannungsversorgung Primärseite]

Parts:
C1, C2: 10µ/10V; C0603
C3, C17, C18, C20, C21, C40: 47µ/35V; PANASONIC_D
C19, C22: 10n/35V; C0603
D1, D2, D6, D7, D15: ES1A; SMA-DO214AC
F1: FUSETE5; TE5
H1, H2, H3, H4: MOUNT-PAD-ROUND3.0; 3,0-PAD
IC3: LM1117; SOT223
L1: 68µH; PISM
L5: 100µH; PISM
L6: 150µH; PISM
LED4, LED5, LED6, LED7, LED10: LEDCHIP-LED0805; CHIP-LED0805
R31: 50k; R0805
R42: 680; R0805
R43, R45: 1,5k; R0805
R44: 4.7k; R0805
R50: 5,6k; R0805
R59: 10k; R0805
U3, U4: LM2675; SOIC127P620X175-8N
U$8: LM2576; TO220511
X1: AK500/2-H

Connections:
+3V3: C2.1, D2.A, IC3.2 (OUT), IC3.4 (OUT), R42.2; also elsewhere on the board
+5V: C1.1, C18.+, D2.K (C), IC3.3 (IN), L5.1, R43.2, U3.4 (FB); also elsewhere on the board
+5V/1: C40.+, L1.1, R45.2, U$8.4 (FB); also elsewhere on the board
+12V: C21.+, L6.1, R44.2, U4.4 (FB); also elsewhere on the board
+24V: C3.+, C17.+, C20.+, D1.K (C), F1.1, R31.1, U3.7 (VIN), U4.7 (VIN), U$8.1 (VIN); also elsewhere on the board
ADC_24V_LOGIK/SCK_A: R31.2, R50.1; also elsewhere on the board
CAP_0V: H1.B3,0; also elsewhere on the board
GND: C1.2, C2.2, C3.-, C17.-, C18.-, C20.-, C21.-, C40.-, D1.A, D6.A, D7.A, D15.A, H2.B3,0, H3.B3,0, H4.B3,0, IC3.1 (GND), LED4.C, LED5.C, LED6.C, LED7.C, LED10.C, R50.2, U3.6 (GND), U4.6 (GND), U$8.3 (GND), U$8.5 (!ON!/OFF), X1.2; also elsewhere on the board
unnamed: C19.2, D6.K (C), L5.2, U3.8 (VSW)
unnamed: C19.1, U3.1 (CB)
unnamed: C22.2, D7.K (C), L6.2, U4.8 (VSW)
unnamed: F1.2, R59.2, X1.1
unnamed: C22.1, U4.1 (CB)
unnamed: LED4.A, R42.1
unnamed: D15.K (C), L1.2, U$8.2 (VOUT)
unnamed: LED7.A, R45.1
unnamed: LED5.A, R43.1
unnamed: LED6.A, R44.1
unnamed: LED10.A, R59.1

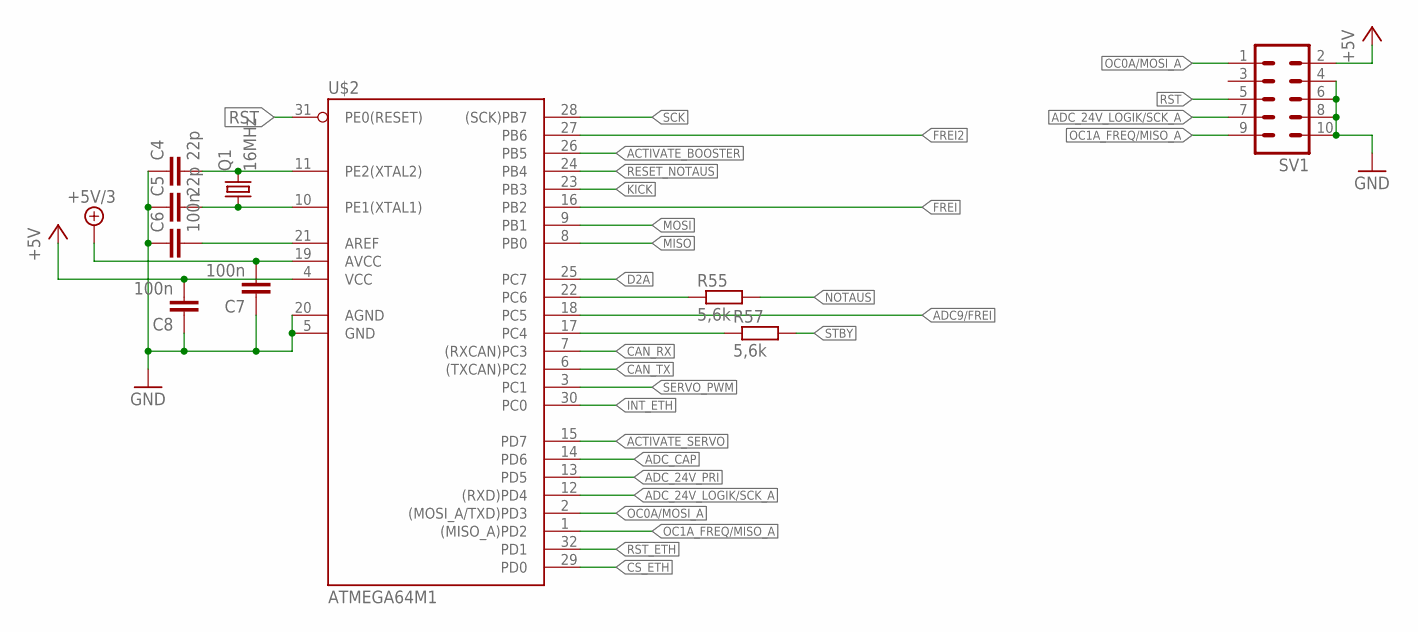
[picture p62: schematic rekick2015-Resonant-Prototyp-fixed.sch, sheet 2, MCU]

Parts:
C4, C5: 22p; C0603
C6, C7, C8: 100n; C0603
Q1: 16MHz; HC49UP
R55, R57: 5,6k; R0805
SV1: ML10
U$2: ATMEGA64M1; TQFP32-08

Connections:
+5V: C8.2, SV1.2, U$2.4 (VCC); also elsewhere on the board
+5V/3: C7.2, U$2.19 (AVCC); also elsewhere on the board
ACTIVATE_BOOSTER: U$2.26 (PB5); also elsewhere on the board
ACTIVATE_SERVO: U$2.15 (PD7); also elsewhere on the board
ADC9/FREI: U$2.18 (PC5)
ADC_24V_LOGIK/SCK_A: SV1.7, U$2.12 ((RXD)PD4); also elsewhere on the board
ADC_24V_PRI: U$2.13 (PD5); also elsewhere on the board
ADC_CAP: U$2.14 (PD6); also elsewhere on the board
CAN_RX: U$2.7 ((RXCAN)PC3); also elsewhere on the board
CAN_TX: U$2.6 ((TXCAN)PC2); also elsewhere on the board
CS_ETH: U$2.29 (PD0); also elsewhere on the board
D2A: U$2.25 (PC7); also elsewhere on the board
FREI: U$2.16 (PB2)
FREI2: U$2.27 (PB6)
GND: C4.1, C5.1, C6.1, C7.1, C8.1, SV1.4, SV1.6, SV1.8, SV1.10, U$2.5 (GND), U$2.20 (AGND); also elsewhere on the board
INT_ETH: U$2.30 (PC0); also elsewhere on the board
KICK: U$2.23 (PB3); also elsewhere on the board
MISO: U$2.8 (PB0); also elsewhere on the board
MOSI: U$2.9 (PB1); also elsewhere on the board
unnamed: C4.2, Q1.2, U$2.11 (PE2(XTAL2))
unnamed: C5.2, Q1.1, U$2.10 (PE1(XTAL1))
unnamed: C6.2, U$2.21 (AREF)
unnamed: R55.1, U$2.22 (PC6)
unnamed: R57.1, U$2.17 (PC4)
NOTAUS: R55.2; also elsewhere on the board
OC0A/MOSI_A: SV1.1, U$2.2 ((MOSI_A/TXD)PD3); also elsewhere on the board
OC1A_FREQ/MISO_A: SV1.9, U$2.1 ((MISO_A)PD2); also elsewhere on the board
RESET_NOTAUS: U$2.24 (PB4); also elsewhere on the board
RST: SV1.5, U$2.31 (PE0(RESET))
RST_ETH: U$2.32 (PD1); also elsewhere on the board
SCK: U$2.28 ((SCK)PB7); also elsewhere on the board
SERVO_PWM: U$2.3 (PC1); also elsewhere on the board
STBY: R57.2; also elsewhere on the board

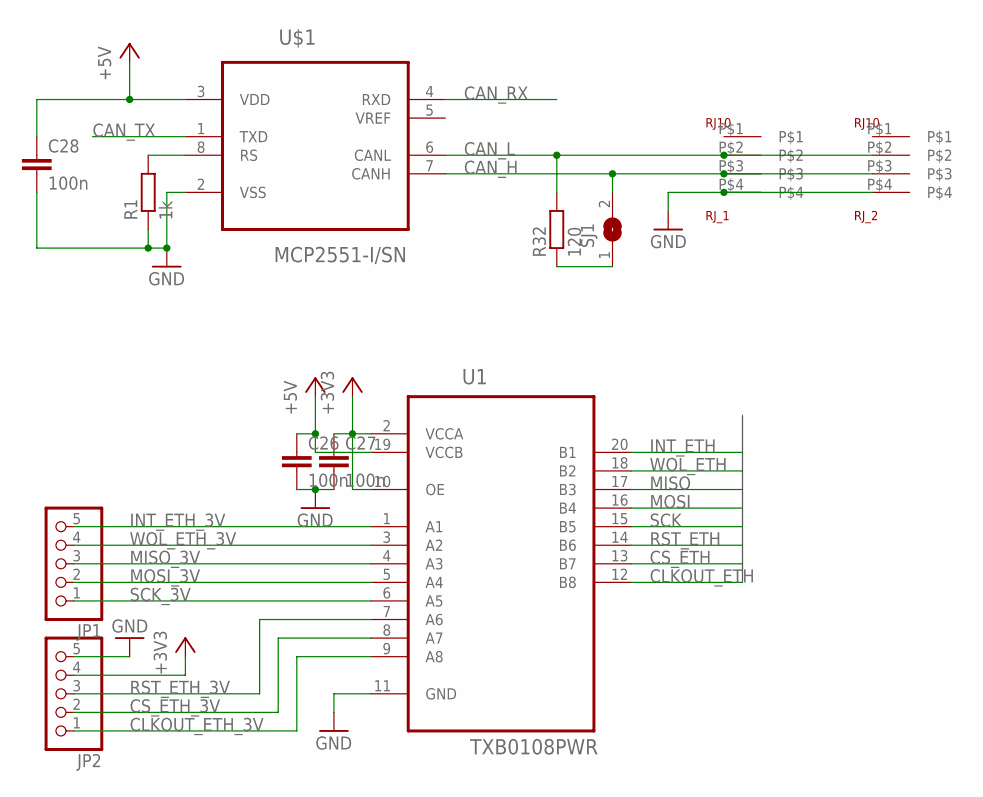
[picture p63: schematic rekick2015-Resonant-Prototyp-fixed.sch, sheet 3, Ethernet & CAN]

Parts:
C26, C27, C28: 100n; C0603
JP1, JP2: PINHD-1X5; 1X05
R1: 1k; R0805
R32: 120; R0805
RJ_1, RJ_2: RJ10
SJ1: SJ
U1: TXB0108PWR; SOP65P640X120-20N
U$1: MCP2551-I/SN; SOIC127P600X175-8N

Connections:
+3V3: C27.1, JP2.4, U1.2 (VCCA), U1.10 (OE); also elsewhere on the board
+5V: C26.1, C28.1, U1.19 (VCCB), U$1.3 (VDD); also elsewhere on the board
CAN_H: RJ_1.P$3, RJ_2.P$3, SJ1.2, U$1.7 (CANH)
CAN_L: R32.2, RJ_1.P$2, RJ_2.P$2, U$1.6 (CANL)
CAN_RX: U$1.4 (RXD); also elsewhere on the board
CAN_TX: U$1.1 (TXD); also elsewhere on the board
CLKOUT_ETH: U1.12 (B8)
CLKOUT_ETH_3V: JP2.1, U1.9 (A8)
CS_ETH: U1.13 (B7); also elsewhere on the board
CS_ETH_3V: JP2.2, U1.8 (A7)
GND: C26.2, C27.2, C28.2, JP2.5, R1.1, RJ_1.P$4, RJ_2.P$4, U1.11 (GND), U$1.2 (VSS); also elsewhere on the board
INT_ETH: U1.20 (B1); also elsewhere on the board
INT_ETH_3V: JP1.5, U1.1 (A1)
MISO: U1.17 (B3); also elsewhere on the board
MISO_3V: JP1.3, U1.4 (A3)
MOSI: U1.16 (B4); also elsewhere on the board
MOSI_3V: JP1.2, U1.5 (A4)
unnamed: R1.2, U$1.8 (RS)
unnamed: R32.1, SJ1.1
RST_ETH: U1.14 (B6); also elsewhere on the board
RST_ETH_3V: JP2.3, U1.7 (A6)
SCK: U1.15 (B5); also elsewhere on the board
SCK_3V: JP1.1, U1.6 (A5)
WOL_ETH: U1.18 (B2)
WOL_ETH_3V: JP1.4, U1.3 (A2)

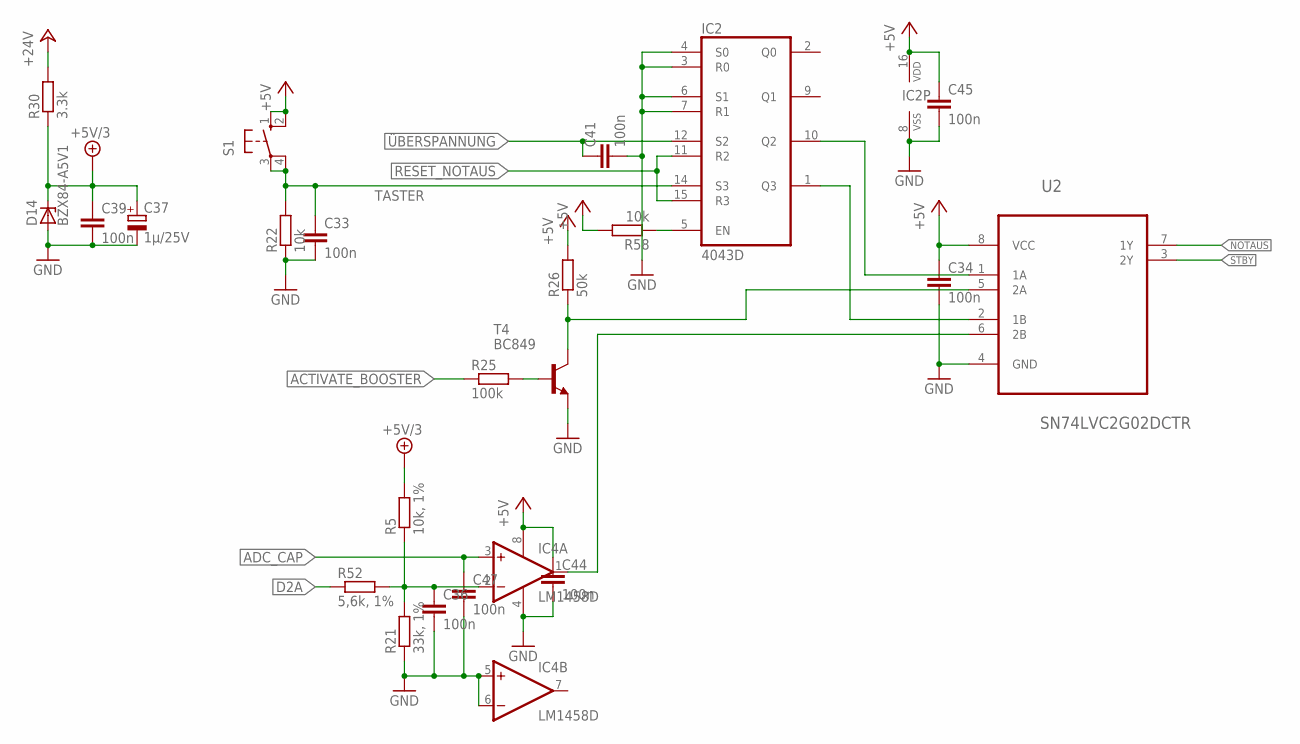
[picture p64: schematic rekick2015-Resonant-Prototyp-fixed.sch, sheet 4, Notaus- und Burst-Logik]

Parts:
C33, C34, C36, C39, C41, C44, C45, C47: 100n; C0603
C37: 1µ/25V; SMC_A
D14: BZX84-A5V1; TO236
IC2: 4043D; SO16
IC4: LM1458D; SO08
R5: 10k, 1%; R0805
R21: 33k, 1%; R0805
R22, R58: 10k; R0805
R25: 100k; R0805
R26: 50k; R0805
R30: 3.3k; R0805
R52: 5,6k, 1%; R0805
S1: 10-XX; B3F-10XX
T4: BC849; SOT23
U2: SN74LVC2G02DCTR; SOP65P400X130-8N

Connections:
+5V: C34.1, C44.1, C45.1, IC2.16 (VDD), IC4.8 (V+), R26.2, R58.2, S1.1 (S), S1.2 (S1), U2.8 (VCC); also elsewhere on the board
+5V/3: C37.+, C39.1, D14.C, R5.2, R30.1; also elsewhere on the board
+24V: R30.2; also elsewhere on the board
ACTIVATE_BOOSTER: R25.1; also elsewhere on the board
ADC_CAP: C47.1, IC4.3 (+IN); also elsewhere on the board
D2A: R52.1; also elsewhere on the board
GND: C33.2, C34.2, C36.2, C37.-, C39.2, C41.2, C44.2, C45.2, C47.2, D14.A, IC2.3 (R0), IC2.4 (S0), IC2.6 (S1), IC2.7 (R1), IC2.8 (VSS), IC4.4 (V-), IC4.5 (+IN), IC4.6 (-IN), R21.1, R22.1, T4.2 (E), U2.4 (GND); also elsewhere on the board
KICK_VOLTAGE: C36.1, IC4.2 (-IN), R5.1, R21.2, R52.2
unnamed: IC2.10 (Q2), U2.1 (1A)
unnamed: IC2.1 (Q3), U2.2 (1B)
unnamed: IC2.5 (EN), R58.1
unnamed: IC4.1 (OUT), U2.6 (2B)
unnamed: R25.2, T4.1 (B)
unnamed: R26.1, T4.3 (C), U2.5 (2A)
NOTAUS: U2.7 (1Y); also elsewhere on the board
RESET_NOTAUS: IC2.11 (R2), IC2.15 (R3); also elsewhere on the board
STBY: U2.3 (2Y); also elsewhere on the board
TASTER: C33.1, IC2.14 (S3), R22.2, S1.3, S1.4 (P1)
ÜBERSPANNUNG: C41.1, IC2.12 (S2); also elsewhere on the board

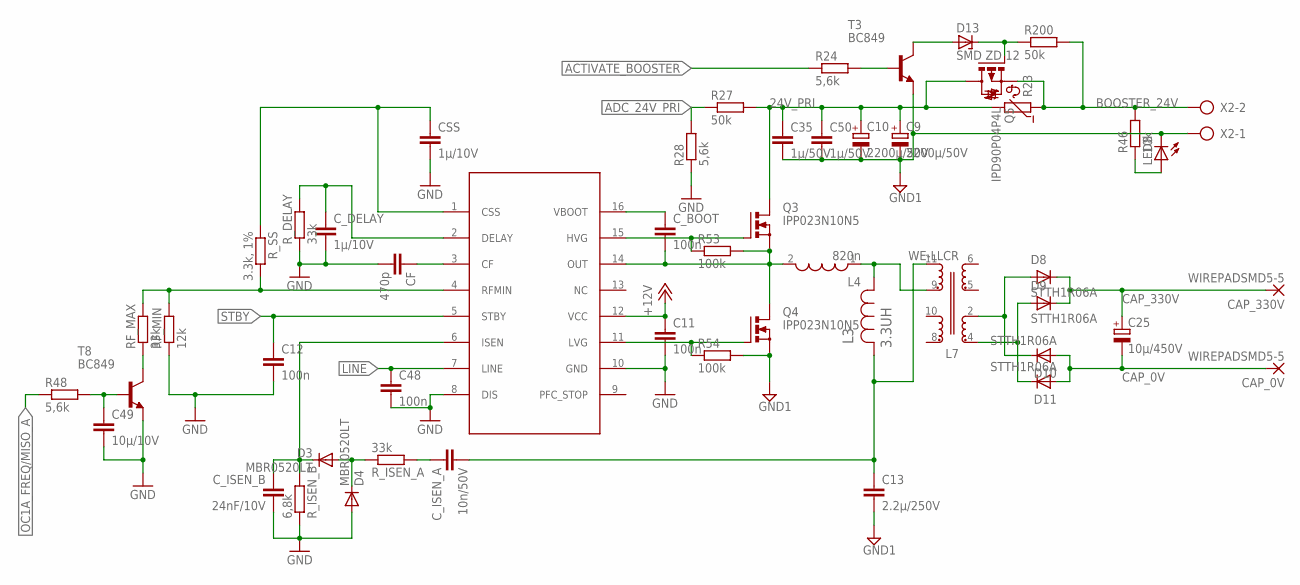
[picture p65: schematic rekick2015-Resonant-Prototyp-fixed.sch, sheet 5, Resonanz Controller]

Parts:
C9, C10: 2200µ/50V; E5-13
C11, C12, C48: 100n; C0603
C13: 2.2µ/250V; C2220K
C25: 10µ/450V; E5-10,5
C35, C50: 1µ/50V; C1206
C49: 10µ/10V; C0603
CAP_0V, CAP_330V: WIREPADSMD5-5; 5-5
CF: 470p; C0603
CSS: 1µ/10V; C0603
C_BOOT: 100n; C0603
C_DELAY: 1µ/10V; C0603
C_ISEN_A: 10n/50V; C0603
C_ISEN_B: 24nF/10V; C0603
D3, D4: MBR0520LT; SOD123
D8, D9, D10, D11: STTH1R06A; SMA-DO214AC
D13: SMD ZD 12; TO236
L3: 3.3UH; IND_ELLATP-B
L4: 820n; WE-HCI_1890
L7: WE-LLCR; WE-LLCR_ETD34
LED8: LEDCHIP-LED0805; CHIP-LED0805
Q3, Q4: IPP023N10N5; TO220BV
Q5: IPD90P04P4L; D-PAK_TO252AA
R23: NTC644A; N644A
R24, R28, R48: 5,6k; R0805
R27, R200: 50k; R0805
R46: 10k; R0805
R53, R54: 100k; R0805
RF_MAX: 33k; R0805
RF_MIN: 12k; R0805
R_DELAY: 33k; R0805
R_ISEN_A: 33k; R0805
R_ISEN_B: 6,8k; R0805
R_SS: 3.3k, 1%; R0805
T3, T8: BC849; SOT23
U$3: L6599; SO16
X2: AK500/2-H

Connections:
24V_PRI: C9.+, C10.+, C35.1, C50.1, Q3.D, Q5.4 (D), R23.2, R27.2
+12V: C11.1, U$3.12 (VCC); also elsewhere on the board
ACTIVATE_BOOSTER: R24.1; also elsewhere on the board
ADC_24V_PRI: R27.1, R28.2; also elsewhere on the board
BOOSTER_24V: Q5.3 (S), R23.1, R46.2, R200.2, X2.2
CAP_0V: C25.-, CAP_0V.P$1, D10.A, D11.A; also elsewhere on the board
CAP_330V: C25.+, CAP_330V.P$1, D8.K (C), D9.K (C); also elsewhere on the board
GND: C11.2, C12.2, C48.2, C49.2, CF.2, CSS.2, C_DELAY.2, C_ISEN_B.2, D4.A, R28.1, RF_MIN.1, R_DELAY.1, R_ISEN_B.1, T8.2 (E), U$3.8 (DIS), U$3.10 (GND); also elsewhere on the board
GND1: C9.-, C10.-, C13.2, C35.2, C50.2, LED8.C, Q4.S, R54.2, T3.2 (E), X2.1
LINE: C48.1, U$3.7 (LINE); also elsewhere on the board
unnamed: RF_MAX.1, T8.3 (C)
unnamed: RF_MAX.2, RF_MIN.2, R_SS.2, U$3.4 (RFMIN)
unnamed: CF.1, U$3.3 (CF)
unnamed: Q3.G, R53.1, U$3.15 (HVG)
unnamed: Q4.G, R54.1, U$3.11 (LVG)
unnamed: CSS.1, R_SS.1, U$3.1 (CSS)
unnamed: C_BOOT.1, U$3.16 (VBOOT)
unnamed: C_DELAY.1, R_DELAY.2, U$3.2 (DELAY)
unnamed: C_ISEN_B.1, D3.C, R_ISEN_B.2, U$3.6 (ISEN)
unnamed: L3.1, L4.1, L7.9 (4)
unnamed: D3.A, D4.C, R_ISEN_A.1
unnamed: C_ISEN_A.1, R_ISEN_A.2
unnamed: D8.A, D10.K (C), L7.2 (8)
unnamed: D9.A, D11.K (C), L7.4 (1)
unnamed: D13.C, Q5.1 (G), R200.1
unnamed: D13.A, T3.3 (C)
unnamed: R24.2, T3.1 (B)
unnamed: LED8.A, R46.1
unnamed: C49.1, R48.2, T8.1 (B)
OC1A_FREQ/MISO_A: R48.1; also elsewhere on the board
STBY: C12.1, U$3.5 (STBY); also elsewhere on the board
TRAFO1: C_BOOT.2, L4.2, Q3.S, Q4.D, R53.2, U$3.14 (OUT)
TRAFO2: C13.1, C_ISEN_A.2, L3.2, L7.11 (5)
