carpe-noctem-cassel/cnc-circuit-boards/kicker/rekick2015/pcb/rekick2015-Resonant-Prototyp-fixed.brd

## EAGLE design kicker/rekick2015/pcb/rekick2015-Resonant-Prototyp-fixed.brd (continued)

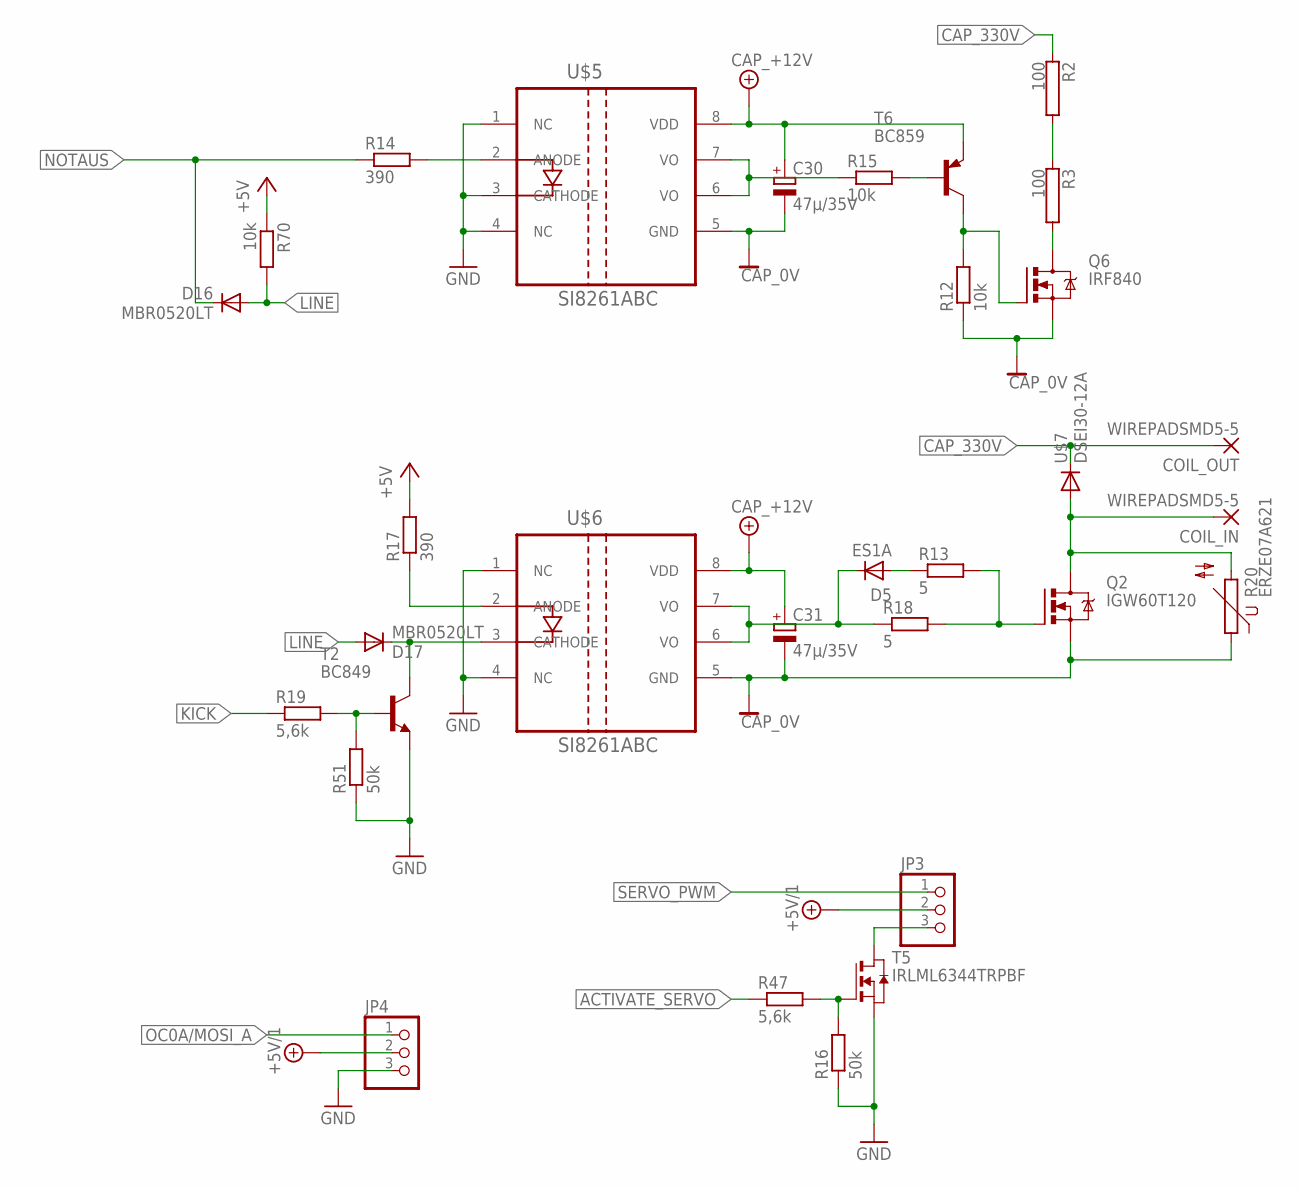
[picture p66: schematic rekick2015-Resonant-Prototyp-fixed.sch, sheet 6, Notaus, Kicker, Servo]

Parts:
C30, C31: 47µ/35V; E2-5
COIL_IN: WIREPADSMD5-5; 5-5
COIL_OUT: WIREPADSMD5-5; 5-5
D5: ES1A; SMA-DO214AC
D16, D17: MBR0520LT; SOD123
JP3, JP4: PINHD-1X3; 1X03
Q2: IGW60T120; TO247BV
Q6: IRF840; TO220BV
R2, R3: 100; HS25
R12, R15, R70: 10k; R0805
R13, R18: 5; R2512
R14, R17: 390; R0805
R16, R51: 50k; R0805
R19, R47: 5,6k; R0805
R20: ERZE07A621; S10K385
T2: BC849; SOT23
T5: IRLML6344TRPBF; SOT-23
T6: BC859; SOT23-BEC
U$5, U$6: SI8261ABC; SOIC-8
U$7: DSEI30-12A; TO247AD

Connections:
+5V: R17.2, R70.1; also elsewhere on the board
+5V/1: JP3.2, JP4.2; also elsewhere on the board
ACTIVATE_SERVO: R47.1; also elsewhere on the board
CAP_0V: C30.-, C31.-, Q2.S, Q6.S, R12.1, R20.1, U$5.5 (GND), U$6.5 (GND); also elsewhere on the board
CAP_330V: COIL_OUT.P$1, R2.1, U$7.C; also elsewhere on the board
CAP_+12V: C30.+, C31.+, T6.E, U$5.8 (VDD), U$6.8 (VDD); also elsewhere on the board
GND: JP4.3, R16.1, R51.1, T2.2 (E), T5.2 (S), U$5.1 (NC), U$5.3 (CATHODE), U$5.4 (NC), U$6.1 (NC), U$6.4 (NC); also elsewhere on the board
KICK: R19.1; also elsewhere on the board
LINE: D16.A, D17.A, R70.2; also elsewhere on the board
unnamed: R2.2, R3.1
unnamed: Q6.D, R3.2
unnamed: Q6.G, R12.2, T6.C
unnamed: R14.2, U$5.2 (ANODE)
unnamed: R15.1, U$5.6 (VO), U$5.7 (VO)
unnamed: R17.1, U$6.2 (ANODE)
unnamed: D5.K (C), R18.1, U$6.6 (VO), U$6.7 (VO)
unnamed: D17.C, T2.3 (C), U$6.3 (CATHODE)
unnamed: R15.2, T6.B
unnamed: R19.2, R51.2, T2.1 (B)
unnamed: Q2.G, R13.2, R18.2
unnamed: COIL_IN.P$1, Q2.D, R20.2, U$7.A
unnamed: D5.A, R13.1
unnamed: JP3.3, T5.1 (D)
unnamed: R16.2, R47.2, T5.3 (G)
NOTAUS: D16.C, R14.1; also elsewhere on the board
OC0A/MOSI_A: JP4.1; also elsewhere on the board
SERVO_PWM: JP3.1; also elsewhere on the board

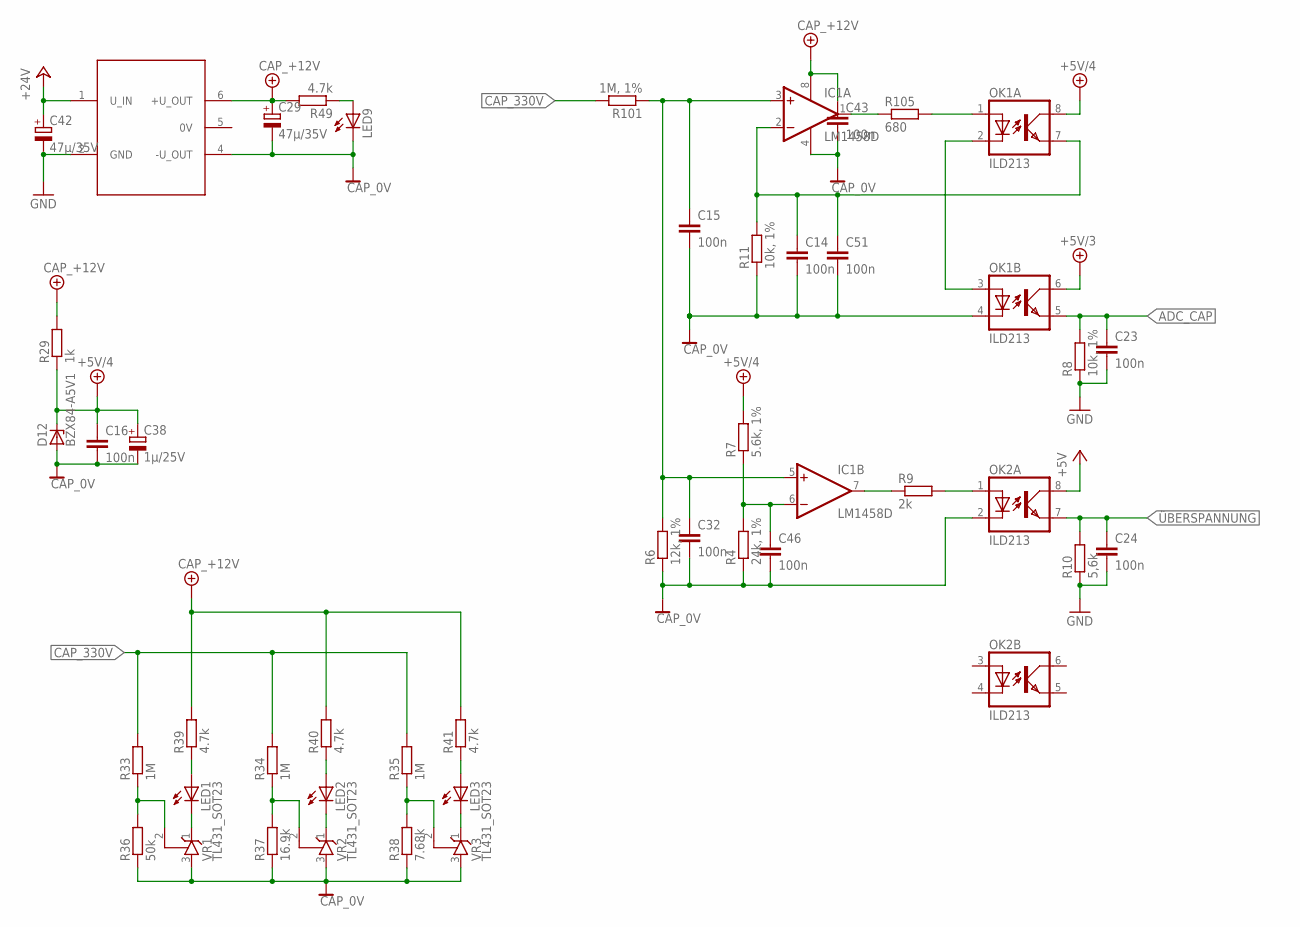
[picture p67: schematic rekick2015-Resonant-Prototyp-fixed.sch, sheet 7, Überwachung/Monitoring]

Parts:
C14, C15, C16, C23, C24, C32, C43, C46, C51: 100n; C0603
C29, C42: 47µ/35V; PANASONIC_D
C38: 1µ/25V; SMC_A
D12: BZX84-A5V1; TO236
IC1: LM1458D; SO08
LED1, LED2, LED3, LED9: LEDCHIP-LED0805; CHIP-LED0805
OK1, OK2: ILD213; SOIC08
R4: 24k, 1%; R0805
R6: 12k, 1%; R0805
R7: 5.6k, 1%; R0805
R8, R11: 10k, 1%; R0805
R9: 2k; R0805
R10: 5,6k; R0805
R29: 1k; R0805
R33, R34, R35: 1M; R2512
R36: 50k; R0805
R37: 16.9k; R0805
R38: 7.68k; R0805
R39, R40, R41, R49: 4.7k; R0805
R101: 1M, 1%; R2512
R105: 680; R0805
U$4: TMH-D
VR1, VR2, VR3: TL431_SOT23; SOT23

Connections:
+5V: OK2.8 (COL); also elsewhere on the board
+5V/3: OK1.6 (COL); also elsewhere on the board
+5V/4: C16.1, C38.+, D12.C, OK1.8 (COL), R7.2, R29.1
+24V: C42.+, U$4.1 (U_IN); also elsewhere on the board
ADC_CAP: C23.1, OK1.5 (EMIT), R8.2; also elsewhere on the board
CAP_0V: C14.2, C15.2, C16.2, C29.-, C32.2, C38.-, C43.2, C46.2, C51.2, D12.A, IC1.4 (V-), LED9.C, OK1.4 (C), OK2.2 (C), R4.1, R6.1, R11.1, R36.1, R37.1, R38.1, U$4.4 (-U_OUT), VR1.3 (A), VR2.3 (A), VR3.3 (A); also elsewhere on the board
CAP_330V: R33.2, R34.2, R35.2, R101.2; also elsewhere on the board
CAP_+12V: C29.+, C43.1, IC1.8 (V+), R29.2, R39.2, R40.2, R41.2, R49.2, U$4.6 (+U_OUT); also elsewhere on the board
GND: C23.2, C24.2, C42.-, R8.1, R10.1, U$4.2 (GND); also elsewhere on the board
unnamed: LED1.C, VR1.1 (C)
unnamed: R33.1, R36.2, VR1.2 (R)
unnamed: IC1.1 (OUT), R105.1
unnamed: C14.1, C51.1, IC1.2 (-IN), OK1.7 (EMIT), R11.2
unnamed: C15.1, C32.1, IC1.3 (+IN), IC1.5 (+IN), R6.2, R101.1
unnamed: OK1.1 (A), R105.2
unnamed: OK1.2 (C), OK1.3 (A)
unnamed: IC1.7 (OUT), R9.1
unnamed: C46.1, IC1.6 (-IN), R4.2, R7.1
unnamed: OK2.1 (A), R9.2
unnamed: R34.1, R37.2, VR2.2 (R)
unnamed: R35.1, R38.2, VR3.2 (R)
unnamed: LED2.C, VR2.1 (C)
unnamed: LED3.C, VR3.1 (C)
unnamed: LED1.A, R39.1
unnamed: LED2.A, R40.1
unnamed: LED3.A, R41.1
unnamed: LED9.A, R49.1
ÜBERSPANNUNG: C24.1, OK2.7 (EMIT), R10.2; also elsewhere on the board

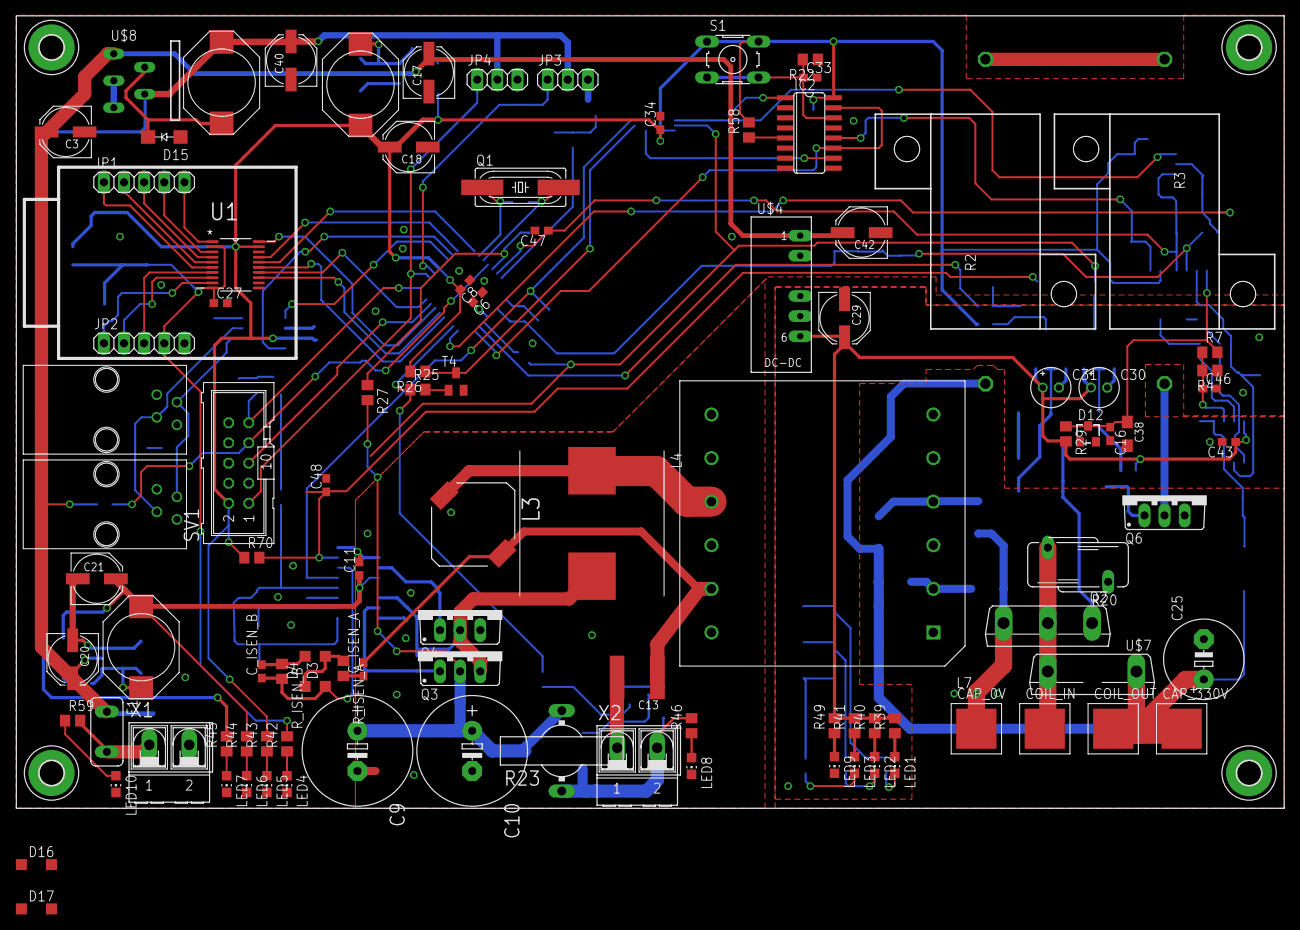
[picture p68: board rekick2015-Resonant-Prototyp-fixed.brd from above]

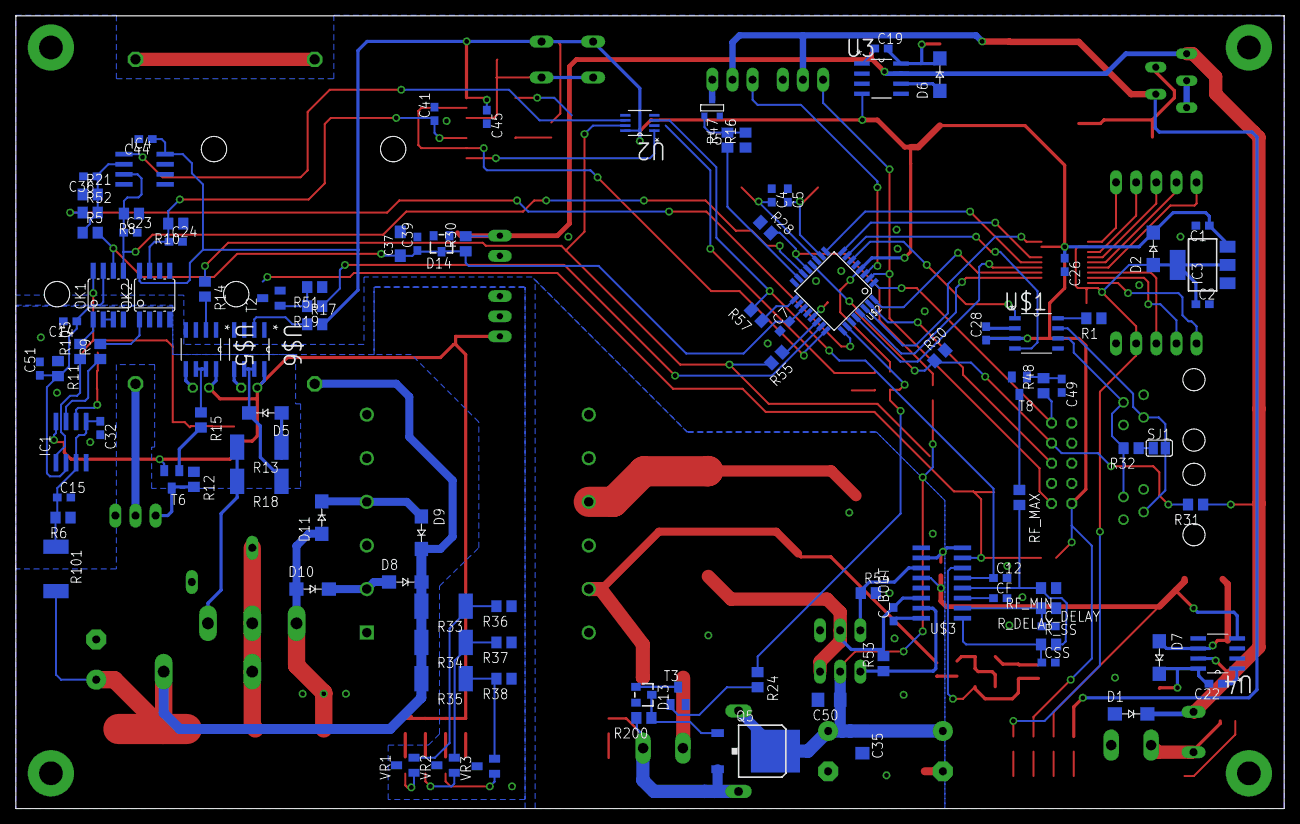
[picture p69: board rekick2015-Resonant-Prototyp-fixed.brd from below]

Board: 2 copper layers, 160.0 x 100.0 mm, 211 parts (106 on the bottom side), 128 nets.
