carpe-noctem-cassel/cnc-circuit-boards/actuator/BBB_Cape/pcb/CN-Cape005-via08.brd

## EAGLE design actuator/BBB_Cape/pcb/CN-Cape005-via08.brd (2016-11-18)

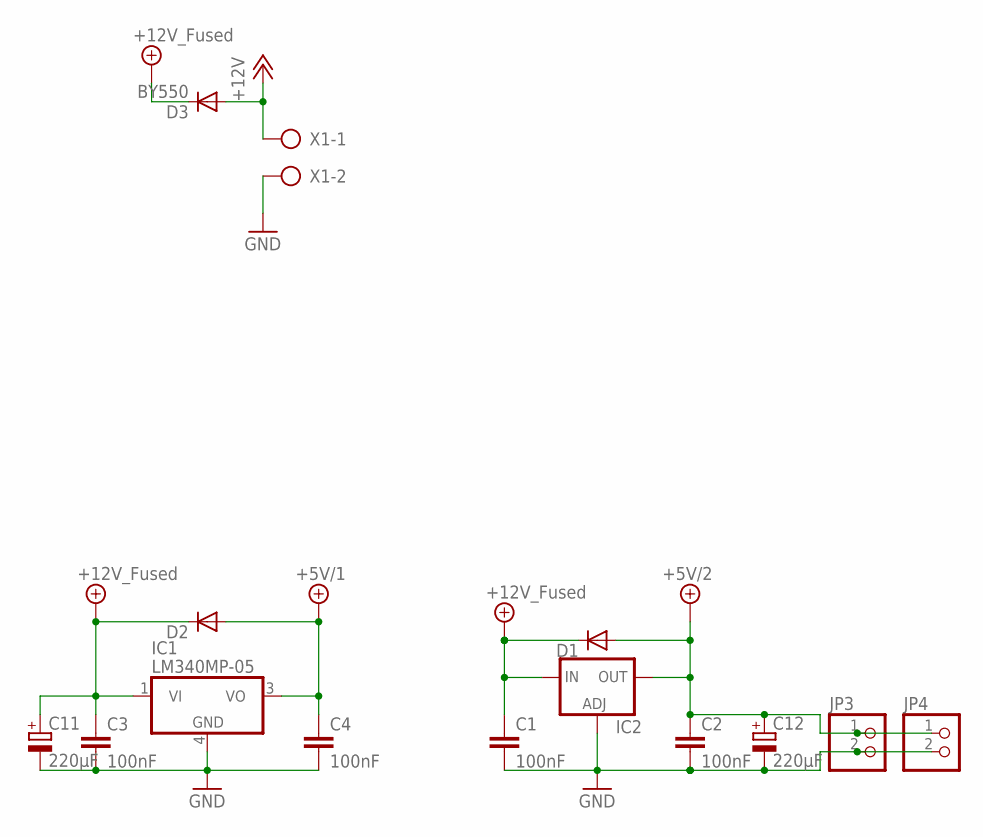
[picture p70: schematic CN-Cape005-via08.sch, sheet 1, Spannungsversorgung Verpolungsschutz ? Größe der Sicherung …]

Parts:
C1, C2, C3, C4: 100nF; C0603
C11, C12: 220µF; E3,5-8
D1, D2: DIODE-SOD123; SOD123
D3: BY550; DO27-15
IC1: LM340MP-05; SOT223
IC2: LM138-TL; TO220L1
JP3, JP4: PINHD-1X2; 1X02
X1: AK500/2-H

Connections:
+5V/1: C4.1, D2.A, IC1.3 (VO); also elsewhere on the board
+5V/2: C2.1, C12.+, D1.A, IC2.2 (OUT), JP3.1, JP4.1; also elsewhere on the board
+10V: C1.1, C3.1, C11.+, D1.C, D2.C, D3.C, IC1.1 (VI), IC2.3 (IN)
+12V: D3.A, X1.1
GND: C1.2, C2.2, C3.2, C4.2, C11.-, C12.-, IC1.4 (GND), IC2.1 (ADJ), JP3.2, JP4.2, X1.2; also elsewhere on the board

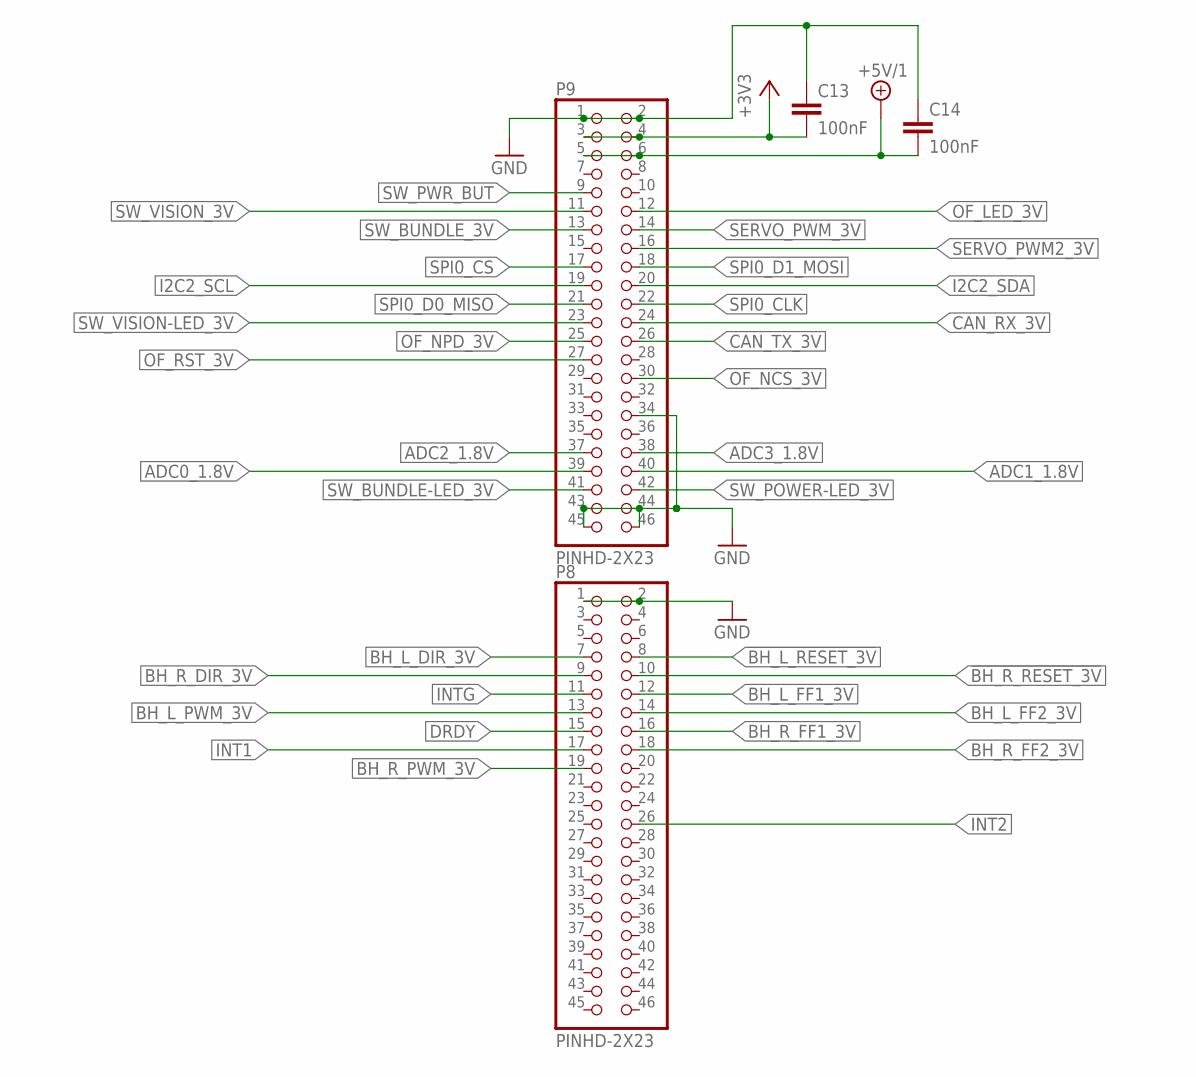
[picture p71: schematic CN-Cape005-via08.sch, sheet 2, BeagleBoard Black Expansion Header]

Parts:
C13, C14: 100nF; C0603
P8, P9: PINHD-2X23; 2X23

Connections:
!BH_L_RESET_3V: P8.8; also elsewhere on the board
!BH_R_RESET_3V: P8.10; also elsewhere on the board
+3V3: C13.2, P9.3, P9.4; also elsewhere on the board
+5V/1: C14.2, P9.5, P9.6; also elsewhere on the board
ADC0_1.8V: P9.39; also elsewhere on the board
ADC1_1.8V: P9.40; also elsewhere on the board
ADC2_1.8V: P9.37; also elsewhere on the board
ADC3_1.8V: P9.38; also elsewhere on the board
BH_L_DIR_3V: P8.7; also elsewhere on the board
BH_L_FF1_3V: P8.12; also elsewhere on the board
BH_L_FF2_3V: P8.14; also elsewhere on the board
BH_L_PWM_3V: P8.13; also elsewhere on the board
BH_R_DIR_3V: P8.9; also elsewhere on the board
BH_R_FF1_3V: P8.16; also elsewhere on the board
BH_R_FF2_3V: P8.18; also elsewhere on the board
BH_R_PWM_3V: P8.19; also elsewhere on the board
CAN_RX_3V: P9.24; also elsewhere on the board
CAN_TX_3V: P9.26; also elsewhere on the board
DRDY: P8.15; also elsewhere on the board
GND: C13.1, C14.1, P8.1, P8.2, P9.1, P9.2, P9.34, P9.43, P9.44, P9.45, P9.46; also elsewhere on the board
I2C2_SCL: P9.19; also elsewhere on the board
I2C2_SDA: P9.20; also elsewhere on the board
INT1: P8.17; also elsewhere on the board
INT2: P8.26; also elsewhere on the board
INTG: P8.11; also elsewhere on the board
OF_LED_3V: P9.12; also elsewhere on the board
OF_NCS_3V: P9.30; also elsewhere on the board
OF_NPD_3V: P9.25; also elsewhere on the board
OF_RST_3V: P9.27; also elsewhere on the board
SERVO_PWM2_3V: P9.16; also elsewhere on the board
SERVO_PWM_3V: P9.14; also elsewhere on the board
SPI0_CLK: P9.22; also elsewhere on the board
SPI0_CS: P9.17; also elsewhere on the board
SPI0_D0_MISO: P9.21; also elsewhere on the board
SPI0_D1_MOSI: P9.18; also elsewhere on the board
SW_BUNDLE-LED_3V: P9.41; also elsewhere on the board
SW_BUNDLE_3V: P9.13; also elsewhere on the board
SW_POWER-LED_3V: P9.42; also elsewhere on the board
SW_PWR_BUT: P9.9; also elsewhere on the board
SW_VISION-LED_3V: P9.23; also elsewhere on the board
SW_VISION_3V: P9.11; also elsewhere on the board

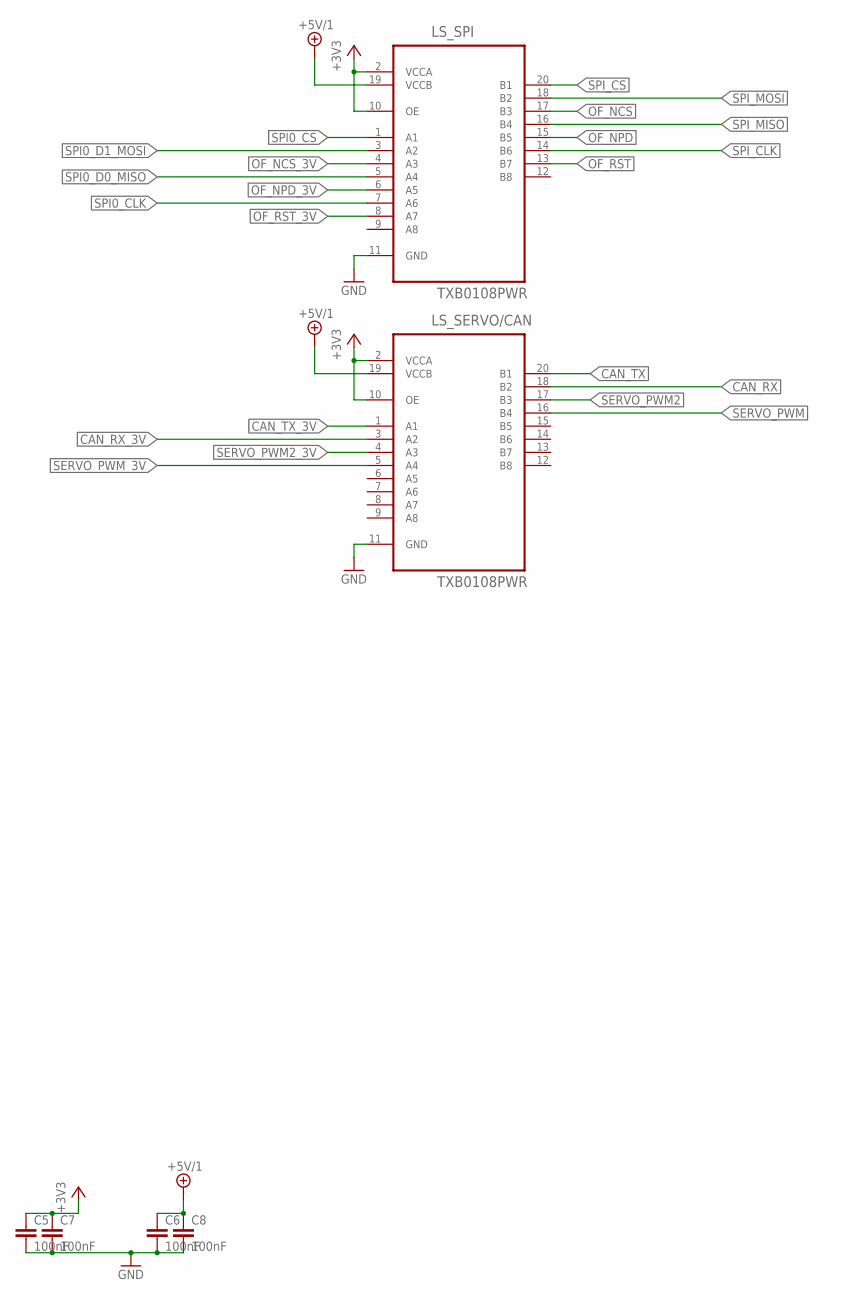
[picture p72: schematic CN-Cape005-via08.sch, sheet 3, Level Shifter]

Parts:
C5, C6, C7, C8: 100nF; C0603
LS_SERVO/CAN: TXB0108PWR; SOP65P640X120-20N
LS_SPI: TXB0108PWR; SOP65P640X120-20N

Connections:
+3V3: C5.1, C7.1, LS_SERVO/CAN.2 (VCCA), LS_SERVO/CAN.10 (OE), LS_SPI.2 (VCCA), LS_SPI.10 (OE); also elsewhere on the board
+5V/1: C6.1, C8.1, LS_SERVO/CAN.19 (VCCB), LS_SPI.19 (VCCB); also elsewhere on the board
CAN_RX: LS_SERVO/CAN.18 (B2); also elsewhere on the board
CAN_RX_3V: LS_SERVO/CAN.3 (A2); also elsewhere on the board
CAN_TX: LS_SERVO/CAN.20 (B1); also elsewhere on the board
CAN_TX_3V: LS_SERVO/CAN.1 (A1); also elsewhere on the board
GND: C5.2, C6.2, C7.2, C8.2, LS_SERVO/CAN.11 (GND), LS_SPI.11 (GND); also elsewhere on the board
OF_NCS: LS_SPI.17 (B3); also elsewhere on the board
OF_NCS_3V: LS_SPI.4 (A3); also elsewhere on the board
OF_NPD: LS_SPI.15 (B5); also elsewhere on the board
OF_NPD_3V: LS_SPI.6 (A5); also elsewhere on the board
OF_RST: LS_SPI.13 (B7); also elsewhere on the board
OF_RST_3V: LS_SPI.8 (A7); also elsewhere on the board
SERVO_PWM: LS_SERVO/CAN.16 (B4); also elsewhere on the board
SERVO_PWM2: LS_SERVO/CAN.17 (B3); also elsewhere on the board
SERVO_PWM2_3V: LS_SERVO/CAN.4 (A3); also elsewhere on the board
SERVO_PWM_3V: LS_SERVO/CAN.5 (A4); also elsewhere on the board
SPI0_CLK: LS_SPI.7 (A6); also elsewhere on the board
SPI0_CS: LS_SPI.1 (A1); also elsewhere on the board
SPI0_D0_MISO: LS_SPI.5 (A4); also elsewhere on the board
SPI0_D1_MOSI: LS_SPI.3 (A2); also elsewhere on the board
SPI_CLK: LS_SPI.14 (B6); also elsewhere on the board
SPI_CS: LS_SPI.20 (B1); also elsewhere on the board
SPI_MISO: LS_SPI.16 (B4); also elsewhere on the board
SPI_MOSI: LS_SPI.18 (B2); also elsewhere on the board

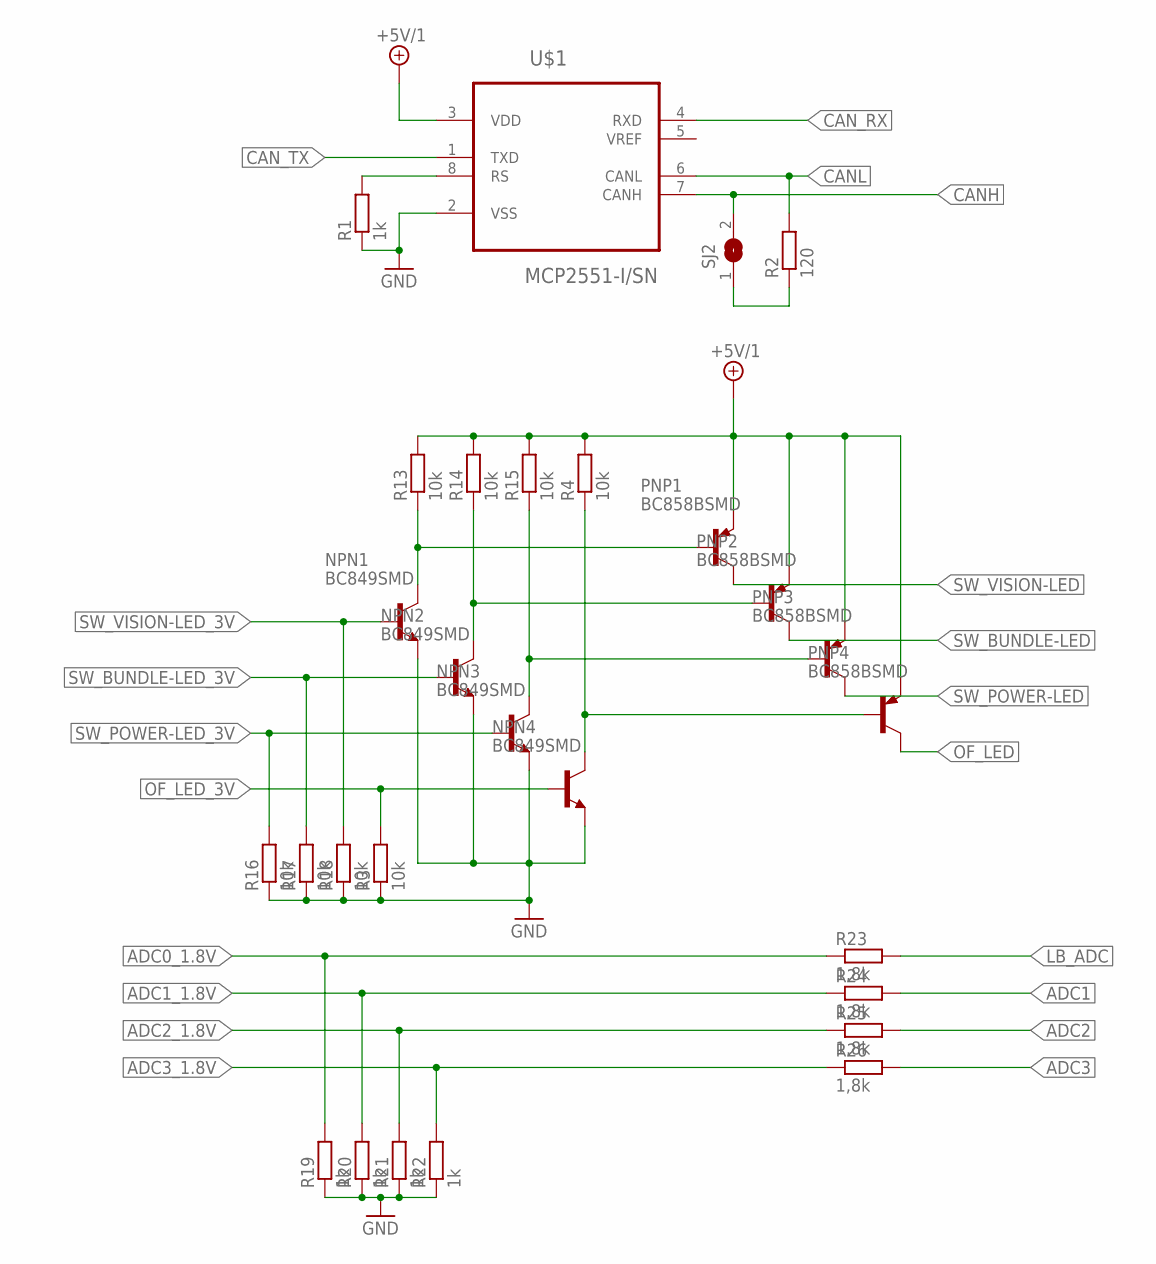
[picture p73: schematic CN-Cape005-via08.sch, sheet 4, CAN- Bus & LED Transistoren]

Parts:
NPN1, NPN2, NPN3, NPN4: BC849SMD; SOT23-BEC
PNP1, PNP2, PNP3, PNP4: BC858BSMD; SOT23-BEC
R1, R19, R20, R21, R22: 1k; R0805
R2: 120; R0805
R3, R4, R13, R14, R15, R16, R17, R18: 10k; R0805
R23, R24, R25, R26: 1,8k; R0805
SJ2: SJ
U$1: MCP2551-I/SN; SOIC127P600X175-8N

Connections:
+5V/1: PNP1.E, PNP2.E, PNP3.E, PNP4.E, R4.2, R13.2, R14.2, R15.2, U$1.3 (VDD); also elsewhere on the board
ADC0_1.8V: R19.2, R23.1; also elsewhere on the board
ADC1: R24.2; also elsewhere on the board
ADC1_1.8V: R20.2, R24.1; also elsewhere on the board
ADC2: R25.2; also elsewhere on the board
ADC2_1.8V: R21.2, R25.1; also elsewhere on the board
ADC3: R26.2; also elsewhere on the board
ADC3_1.8V: R22.2, R26.1; also elsewhere on the board
CANH: SJ2.2, U$1.7 (CANH); also elsewhere on the board
CANL: R2.2, U$1.6 (CANL); also elsewhere on the board
CAN_RX: U$1.4 (RXD); also elsewhere on the board
CAN_TX: U$1.1 (TXD); also elsewhere on the board
GND: NPN1.E, NPN2.E, NPN3.E, NPN4.E, R1.1, R3.1, R16.1, R17.1, R18.1, R19.1, R20.1, R21.1, R22.1, U$1.2 (VSS); also elsewhere on the board
LB_ADC: R23.2; also elsewhere on the board
unnamed: NPN1.C, PNP1.B, R13.1
unnamed: NPN2.C, PNP2.B, R14.1
unnamed: NPN4.C, PNP4.B, R4.1
unnamed: NPN3.C, PNP3.B, R15.1
unnamed: R1.2, U$1.8 (RS)
unnamed: R2.1, SJ2.1
OF_LED: PNP4.C; also elsewhere on the board
OF_LED_3V: NPN4.B, R3.2; also elsewhere on the board
SW_BUNDLE-LED: PNP2.C; also elsewhere on the board
SW_BUNDLE-LED_3V: NPN2.B, R17.2; also elsewhere on the board
SW_POWER-LED: PNP3.C; also elsewhere on the board
SW_POWER-LED_3V: NPN3.B, R16.2; also elsewhere on the board
SW_VISION-LED: PNP1.C; also elsewhere on the board
SW_VISION-LED_3V: NPN1.B, R18.2; also elsewhere on the board

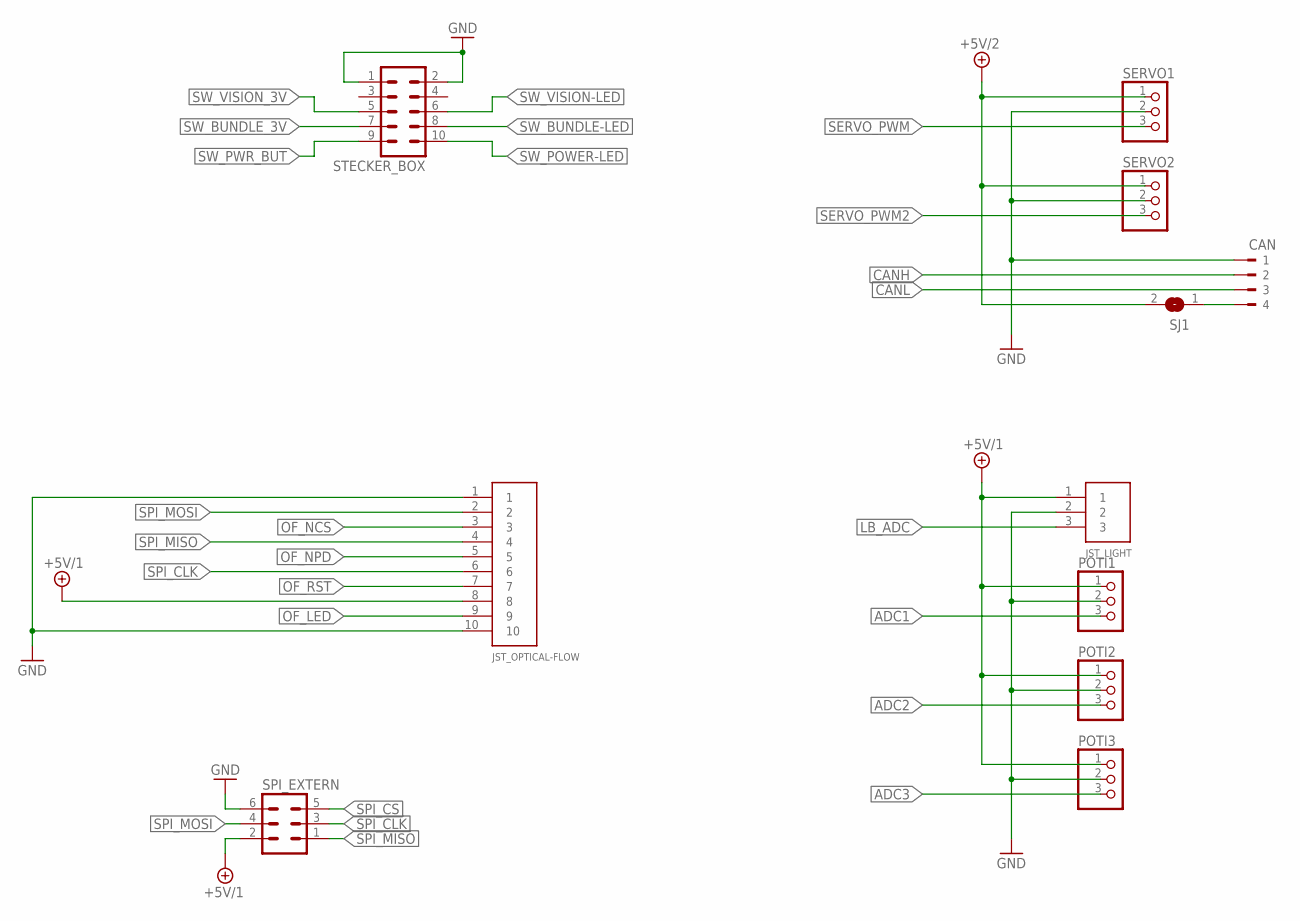
[picture p74: schematic CN-Cape005-via08.sch, sheet 5, Connector]

Parts:
CAN: 90-4
JST_LIGHT: S3PIN; S3B-EH
JST_OPTICAL-FLOW: S10PIN; S10B-EH
POTI1, POTI2, POTI3: PINHD-1X3; 1X03
SERVO1, SERVO2: PINHD-1X3; 1X03
SJ1: SJ
SPI_EXTERN: ML6
STECKER_BOX: ML10

Connections:
5V/2_F&J: CAN.4, SJ1.1
+5V/1: JST_LIGHT.1, JST_OPTICAL-FLOW.8, POTI1.1, POTI2.1, POTI3.1, SPI_EXTERN.2; also elsewhere on the board
+5V/2: SERVO1.1, SERVO2.1, SJ1.2; also elsewhere on the board
ADC1: POTI1.3; also elsewhere on the board
ADC2: POTI2.3; also elsewhere on the board
ADC3: POTI3.3; also elsewhere on the board
CANH: CAN.2; also elsewhere on the board
CANL: CAN.3; also elsewhere on the board
GND: CAN.1, JST_LIGHT.2, JST_OPTICAL-FLOW.1, JST_OPTICAL-FLOW.10, POTI1.2, POTI2.2, POTI3.2, SERVO1.2, SERVO2.2, SPI_EXTERN.6, STECKER_BOX.1, STECKER_BOX.2; also elsewhere on the board
LB_ADC: JST_LIGHT.3; also elsewhere on the board
OF_LED: JST_OPTICAL-FLOW.9; also elsewhere on the board
OF_NCS: JST_OPTICAL-FLOW.3; also elsewhere on the board
OF_NPD: JST_OPTICAL-FLOW.5; also elsewhere on the board
OF_RST: JST_OPTICAL-FLOW.7; also elsewhere on the board
SERVO_PWM: SERVO1.3; also elsewhere on the board
SERVO_PWM2: SERVO2.3; also elsewhere on the board
SPI_CLK: JST_OPTICAL-FLOW.6, SPI_EXTERN.3; also elsewhere on the board
SPI_CS: SPI_EXTERN.5; also elsewhere on the board
SPI_MISO: JST_OPTICAL-FLOW.4, SPI_EXTERN.1; also elsewhere on the board
SPI_MOSI: JST_OPTICAL-FLOW.2, SPI_EXTERN.4; also elsewhere on the board
SW_BUNDLE-LED: STECKER_BOX.8; also elsewhere on the board
SW_BUNDLE_3V: STECKER_BOX.7; also elsewhere on the board
SW_POWER-LED: STECKER_BOX.10; also elsewhere on the board
SW_PWR_BUT: STECKER_BOX.9; also elsewhere on the board
SW_VISION-LED: STECKER_BOX.6; also elsewhere on the board
SW_VISION_3V: STECKER_BOX.5; also elsewhere on the board

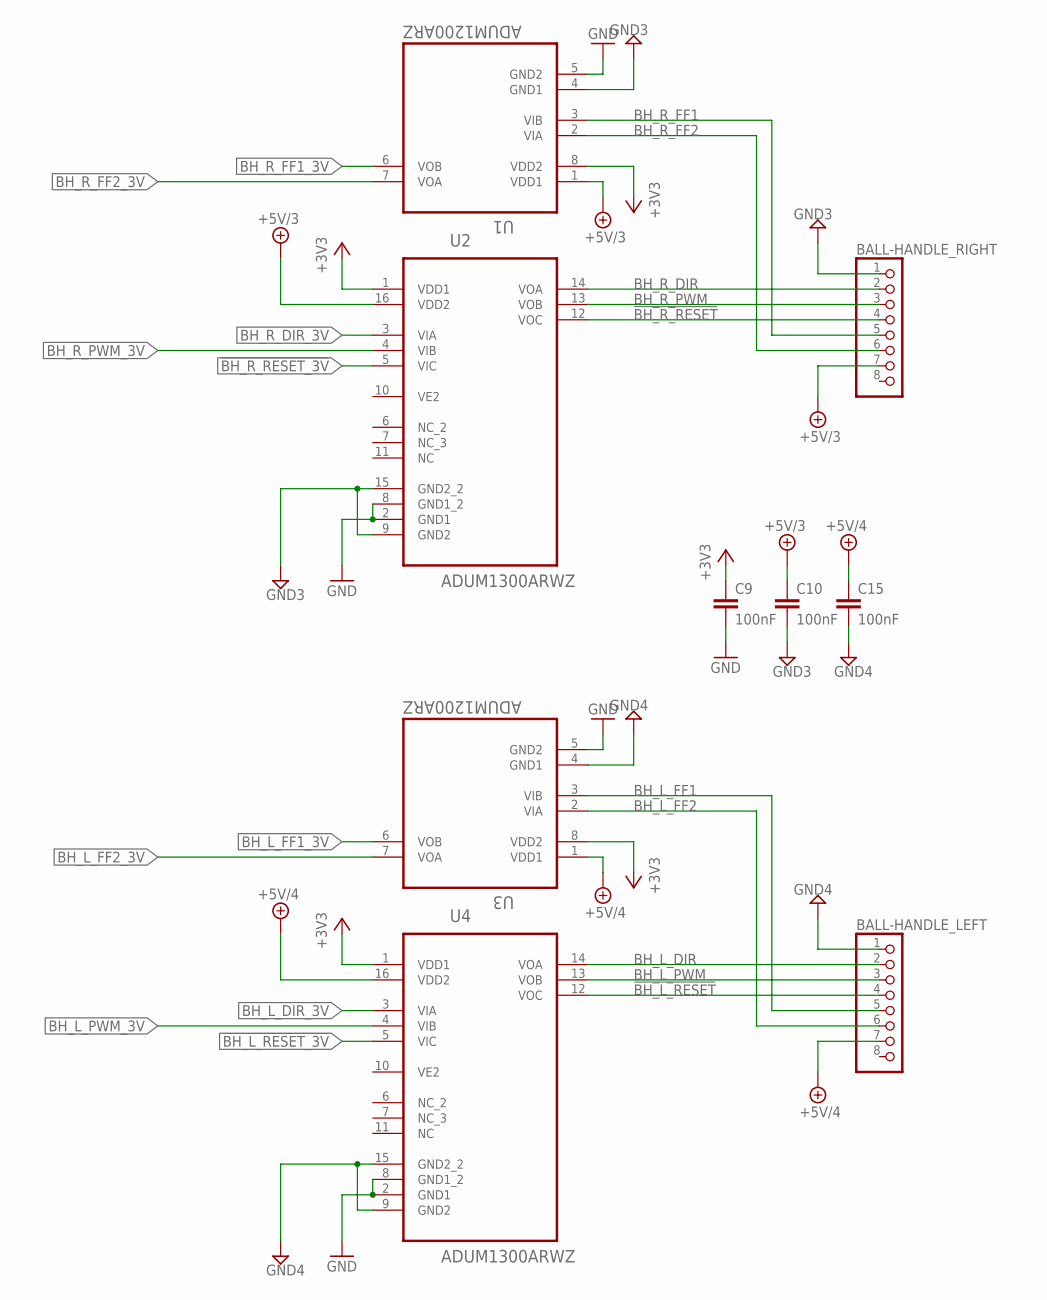
[picture p75: schematic CN-Cape005-via08.sch, sheet 6, BallHandle]

Parts:
BALL-HANDLE_LEFT: PINHD-1X8; 1X08
BALL-HANDLE_RIGHT: PINHD-1X8; 1X08
C9, C10, C15: 100nF; C0603
U1, U3: ADUM1200ARZ; SOIC127P600X175-8N
U2, U4: ADUM1300ARWZ; SOIC127P1032X265-16N

Connections:
!BH_L_RESET: BALL-HANDLE_LEFT.4, U4.12 (VOC)
!BH_L_RESET_3V: U4.5 (VIC); also elsewhere on the board
!BH_R_RESET: BALL-HANDLE_RIGHT.4, U2.12 (VOC)
!BH_R_RESET_3V: U2.5 (VIC); also elsewhere on the board
+3V3: C9.1, U1.8 (VDD2), U2.1 (VDD1), U3.8 (VDD2), U4.1 (VDD1); also elsewhere on the board
+5V/3: BALL-HANDLE_RIGHT.7, C10.1, U1.1 (VDD1), U2.16 (VDD2)
+5V/4: BALL-HANDLE_LEFT.7, C15.1, U3.1 (VDD1), U4.16 (VDD2)
BH_L_DIR: BALL-HANDLE_LEFT.2, U4.14 (VOA)
BH_L_DIR_3V: U4.3 (VIA); also elsewhere on the board
BH_L_FF1: BALL-HANDLE_LEFT.5, U3.3 (VIB)
BH_L_FF1_3V: U3.6 (VOB); also elsewhere on the board
BH_L_FF2: BALL-HANDLE_LEFT.6, U3.2 (VIA)
BH_L_FF2_3V: U3.7 (VOA); also elsewhere on the board
BH_L_PWM: BALL-HANDLE_LEFT.3, U4.13 (VOB)
BH_L_PWM_3V: U4.4 (VIB); also elsewhere on the board
BH_R_DIR: BALL-HANDLE_RIGHT.2, U2.14 (VOA)
BH_R_DIR_3V: U2.3 (VIA); also elsewhere on the board
BH_R_FF1: BALL-HANDLE_RIGHT.5, U1.3 (VIB)
BH_R_FF1_3V: U1.6 (VOB); also elsewhere on the board
BH_R_FF2: BALL-HANDLE_RIGHT.6, U1.2 (VIA)
BH_R_FF2_3V: U1.7 (VOA); also elsewhere on the board
BH_R_PWM: BALL-HANDLE_RIGHT.3, U2.13 (VOB)
BH_R_PWM_3V: U2.4 (VIB); also elsewhere on the board
GND: C9.2, U1.5 (GND2), U2.2 (GND1), U2.8 (GND1_2), U3.5 (GND2), U4.2 (GND1), U4.8 (GND1_2); also elsewhere on the board
GND3: BALL-HANDLE_RIGHT.1, C10.2, U1.4 (GND1), U2.9 (GND2), U2.15 (GND2_2)
GND4: BALL-HANDLE_LEFT.1, C15.2, U3.4 (GND1), U4.9 (GND2), U4.15 (GND2_2)

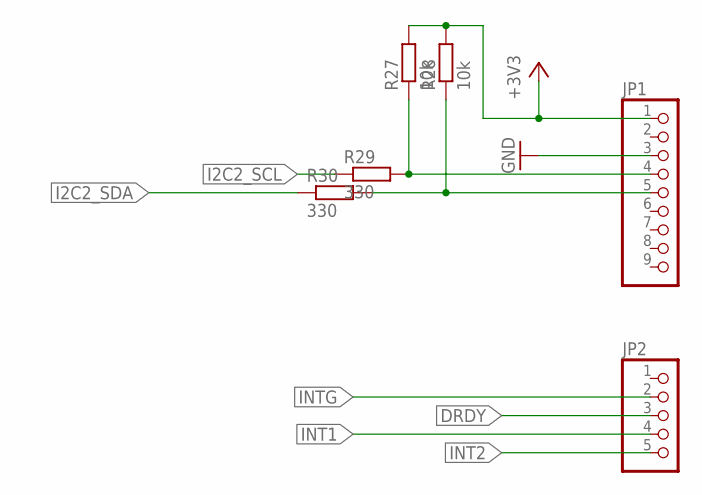
[picture p76: schematic CN-Cape005-via08.sch, sheet 7]

Parts:
JP1: PINHD-1X9; 1X09
JP2: PINHD-1X5; 1X05
R27, R28: 10k; R0805
R29, R30: 330; R0805

Connections:
+3V3: JP1.1, R27.2, R28.2; also elsewhere on the board
DRDY: JP2.3; also elsewhere on the board
GND: JP1.3; also elsewhere on the board
I2C2_SCL: R29.1; also elsewhere on the board
I2C2_SDA: R30.1; also elsewhere on the board
INT1: JP2.4; also elsewhere on the board
INT2: JP2.5; also elsewhere on the board
INTG: JP2.2; also elsewhere on the board
SCL: JP1.4, R27.1, R29.2
SDA: JP1.5, R28.1, R30.2
