carpe-noctem-cassel/cnc-circuit-boards/actuator/BBB_Cape/pcb/CN-Cape005-via08.brd

## EAGLE design actuator/BBB_Cape/pcb/CN-Cape005-via08.brd (continued)

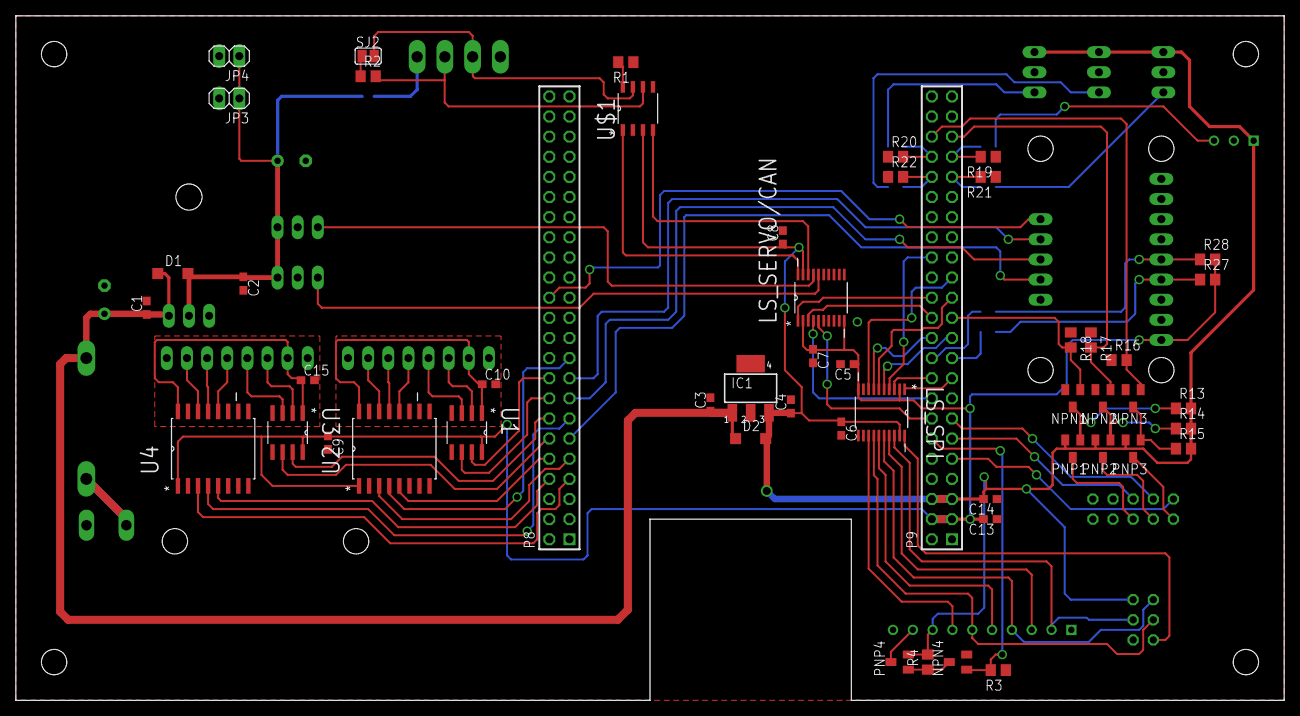
[picture p77: board CN-Cape005-via08.brd from above]

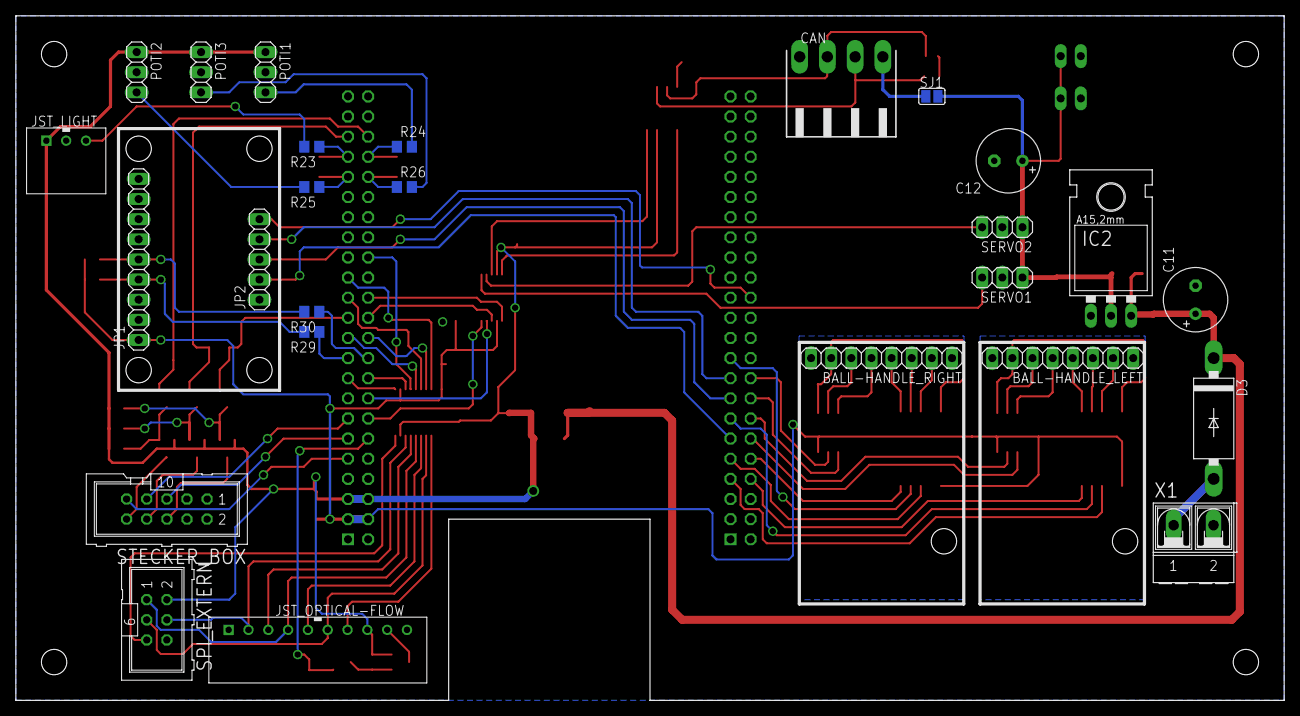
[picture p78: board CN-Cape005-via08.brd from below]

Board: 2 copper layers, 160.0 x 86.4 mm, 78 parts (26 on the bottom side), 88 nets.
