carpe-noctem-cassel/cnc-circuit-boards/kicker/rekick2015/pcb/rekick2016-Flyback-v2-extra-boards.brd

## EAGLE design kicker/rekick2015/pcb/rekick2016-Flyback-v2-extra-boards.brd (2016-11-18)

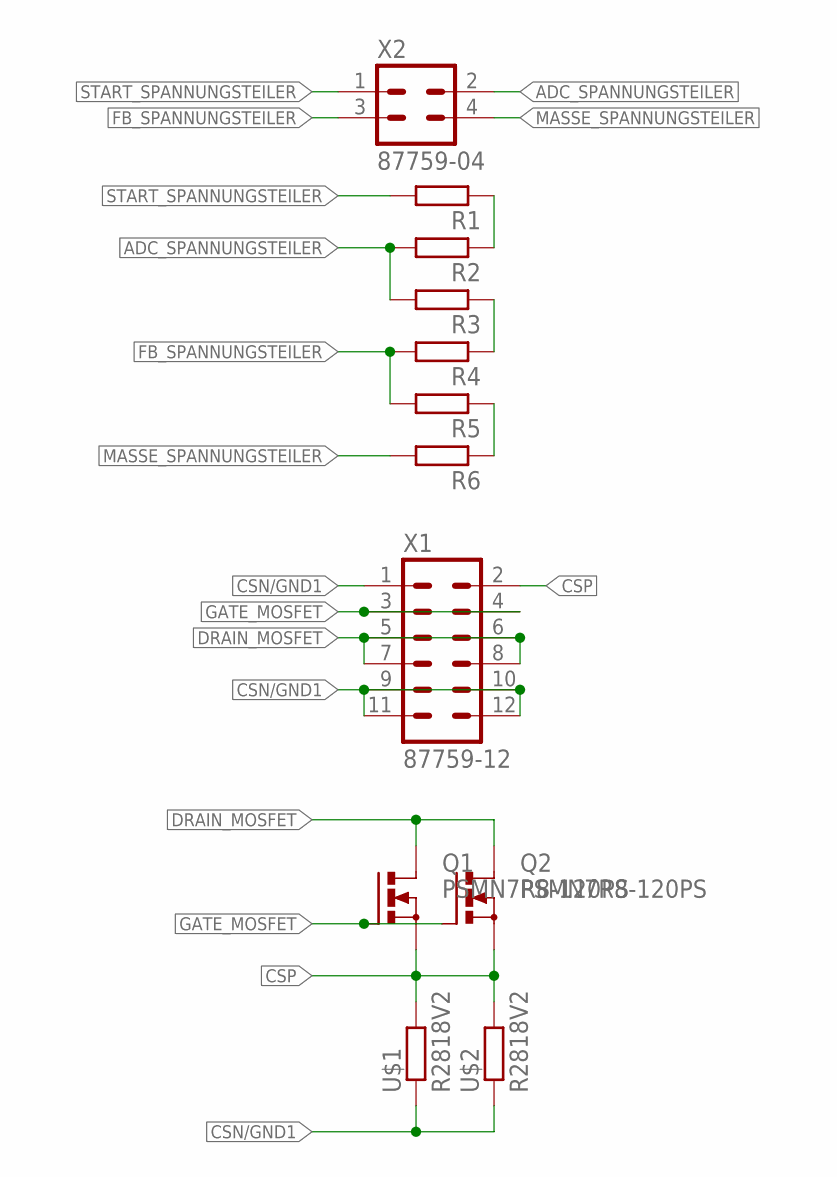
[picture p79: schematic rekick2016-Flyback-v2-extra-boards.sch]

Parts:
Q1, Q2: PSMN7R8-120PS; TO220BV
R1, R2, R3, R4, R5, R6: R-EU_R0805; R0805
U$1, U$2: R2818V2; R2818
X1: 87759-12
X2: 87759-04

Connections:
ADC_SPANNUNGSTEILER: R2.2, R3.2, X2.2
CSN/GND1: U$1.1, U$2.1, X1.1, X1.9, X1.10, X1.11, X1.12
CSP: Q1.S, Q2.S, U$1.2, U$2.2, X1.2
DRAIN_MOSFET: Q1.D, Q2.D, X1.5, X1.6, X1.7, X1.8
FB_SPANNUNGSTEILER: R4.2, R5.2, X2.3
GATE_MOSFET: Q1.G, Q2.G, X1.3, X1.4
MASSE_SPANNUNGSTEILER: R6.2, X2.4
unnamed: R1.1, R2.1
unnamed: R3.1, R4.1
unnamed: R5.1, R6.1
START_SPANNUNGSTEILER: R1.2, X2.1

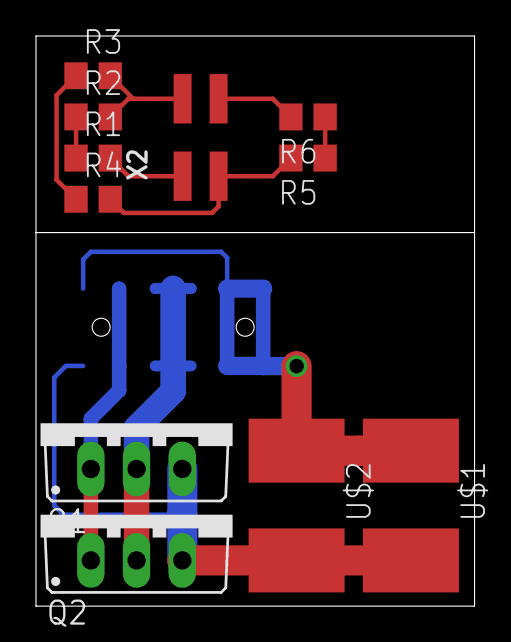
[picture p80: board rekick2016-Flyback-v2-extra-boards.brd from above]

Board: 2 copper layers, 24.4 x 31.7 mm, 12 parts (1 on the bottom side), 11 nets.
