carpe-noctem-cassel/cnc-circuit-boards/kicker/rekick2015/src/rekick - resonanz/main.c

// rekick
//
// Firmware for the Kicking Device 2015/2016
//
//
// Author: Lukas Will <lukas.will@gmail.com>

#include <avr/io.h>
#include <util/delay.h>

#include "defaults.h"
#include "global.h"


int main(void) {
	DDRB = 0x00;
	DDRC = 0x00;
	DDRD = 0x00;


	
	SET_OUTPUT(ACTIVATE_BOOSTER);
	RESET(ACTIVATE_BOOSTER);
	SET_OUTPUT(ACTIVATE_SERVO);
	RESET(ACTIVATE_SERVO);
	SET_OUTPUT(KICK);
	RESET(KICK);
	SET_OUTPUT(RESET_NOTAUS);
	RESET(RESET_NOTAUS);
	SET_OUTPUT(CS_ETH);
	RESET(CS_ETH);

	// enable interrupts
	// sei();

	// ADC
	// CAN
	// ETHERNET

	// BOOSTER
	// KICKER

	for(int i = 0; i <= 5000; i++)
		_delay_ms(1);

	SET(RESET_NOTAUS);

	for(int i = 0; i <= 500; i++)
		_delay_ms(1);

	RESET(RESET_NOTAUS);

	for(int i = 0; i <= 5000; i++)
		_delay_ms(1);
/*
	TOGGLE(KICK);
	for(int i = 0; i <= 200; i++)
		_delay_ms(1);
	TOGGLE(KICK);

	for(int i = 0; i <= 200; i++)
		_delay_ms(1);
*/

	SET(ACTIVATE_BOOSTER);

	for(int i = 0; i <= 25000; i++)
			_delay_ms(1);

	RESET(ACTIVATE_BOOSTER);
	
	while(1) {
		for(int i = 0; i <= 1000; i++)
			_delay_ms(1);
		TOGGLE(KICK);
	}
	return 0;
}
