carpe-noctem-cassel/cnc-circuit-boards/actuator/actuator/src/mcp2515.c

/* Copyright (c) 2007 Fabian Greif
 * All rights reserved.
 *
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
 * 1. Redistributions of source code must retain the above copyright
 *    notice, this list of conditions and the following disclaimer.
 * 2. Redistributions in binary form must reproduce the above copyright
 *    notice, this list of conditions and the following disclaimer in the
 *    documentation and/or other materials provided with the distribution.
 *
 * THIS SOFTWARE IS PROVIDED BY THE AUTHOR AND CONTRIBUTORS "AS IS" AND
 * ANY EXPRESS OR IMPLIED WARRANTIES, INCLUDING, BUT NOT LIMITED TO, THE
 * IMPLIED WARRANTIES OF MERCHANTABILITY AND FITNESS FOR A PARTICULAR PURPOSE
 * ARE DISCLAIMED.  IN NO EVENT SHALL THE AUTHOR OR CONTRIBUTORS BE LIABLE
 * FOR ANY DIRECT, INDIRECT, INCIDENTAL, SPECIAL, EXEMPLARY, OR CONSEQUENTIAL
 * DAMAGES (INCLUDING, BUT NOT LIMITED TO, PROCUREMENT OF SUBSTITUTE GOODS
 * OR SERVICES; LOSS OF USE, DATA, OR PROFITS; OR BUSINESS INTERRUPTION)
 * HOWEVER CAUSED AND ON ANY THEORY OF LIABILITY, WHETHER IN CONTRACT, STRICT
 * LIABILITY, OR TORT (INCLUDING NEGLIGENCE OR OTHERWISE) ARISING IN ANY WAY
 * OUT OF THE USE OF THIS SOFTWARE, EVEN IF ADVISED OF THE POSSIBILITY OF
 * SUCH DAMAGE.
 */
// ----------------------------------------------------------------------------


#include <avr/io.h>
#include <util/delay.h>
#include <avr/pgmspace.h>

#include "mcp2515.h"
#include "mcp2515_defs.h"

#include "global.h"
#include "defaults.h"

// -------------------------------------------------------------------------
// Schreibt/liest ein Byte ueber den Hardware SPI Bus

uint8_t spi_putc( uint8_t data )
{
	// put byte in send-buffer
	SPDR = data;
	
	// wait until byte was send
	while( !( SPSR & (1<<SPIF) ) )
		;
	
	return SPDR;
}

// -------------------------------------------------------------------------
void mcp2515_write_register( uint8_t adress, uint8_t data )
{
	RESET(MCP2515_CS);
	
	spi_putc(SPI_WRITE);
	spi_putc(adress);
	spi_putc(data);
	
	SET(MCP2515_CS);
}

// -------------------------------------------------------------------------
uint8_t mcp2515_read_register(uint8_t adress)
{
	uint8_t data;
	
	RESET(MCP2515_CS);
	
	spi_putc(SPI_READ);
	spi_putc(adress);
	
	data = spi_putc(0xff);	
	
	SET(MCP2515_CS);
	
	return data;
}

// -------------------------------------------------------------------------
void mcp2515_bit_modify(uint8_t adress, uint8_t mask, uint8_t data)
{
	RESET(MCP2515_CS);
	
	spi_putc(SPI_BIT_MODIFY);
	spi_putc(adress);
	spi_putc(mask);
	spi_putc(data);
	
	SET(MCP2515_CS);
}

// ----------------------------------------------------------------------------
uint8_t mcp2515_read_status(uint8_t type)
{
	uint8_t data;
	
	RESET(MCP2515_CS);
	
	spi_putc(type);
	data = spi_putc(0xff);
	
	SET(MCP2515_CS);
	
	return data;
}

// -------------------------------------------------------------------------
bool mcp2515_init(void)
{
	SET(MCP2515_CS);
	SET_OUTPUT(MCP2515_CS);
	
	RESET(P_SCK);
	RESET(P_MOSI);
	RESET(P_MISO);
	
	SET_OUTPUT(P_SCK);
	SET_OUTPUT(P_MOSI);
	SET_INPUT(P_MISO);
	
	SET_INPUT(MCP2515_INT);
	SET(MCP2515_INT);
	
	// active SPI master interface
	SPCR = (1<<SPE) | (1<<MSTR) | (0<<SPR1) | (1<<SPR0) | (1<<CPOL) | (1<<CPHA);
//	SPCR = (1<<SPE) | (1<<MSTR) | (0<<SPR1) | (1<<SPR0);
//	SPSR = 0;
	SPSR = (1<<SPI2X);
	
	// reset MCP2515 by software reset.
	// After this he is in configuration mode.
	RESET(MCP2515_CS);
	spi_putc(SPI_RESET);
	_delay_ms(5);
	SET(MCP2515_CS);
	
	// wait a little bit until the MCP2515 has restarted
	_delay_us(10);
	
	// load CNF1..3 Register
	RESET(MCP2515_CS);
	spi_putc(SPI_WRITE);
	spi_putc(CNF3);
	
	spi_putc((1<<PHSEG21));		// Bitrate 125 kbps at 16 MHz
	spi_putc((1<<BTLMODE)|(1<<PHSEG11));

	//ENDY: Hier kann man Bitrate ändern -> einfach ersten 2 Klammren weg
	spi_putc(0);
	
	// activate interrupts
	spi_putc((1<<RX1IE)|(1<<RX0IE));
	SET(MCP2515_CS);
	
	// test if we could read back the value => is the chip accessible?
	if (mcp2515_read_register(CNF1) != 0) {
		return false;
	}
	
	// deaktivate the RXnBF Pins (High Impedance State)
	mcp2515_write_register(BFPCTRL, 0);
	
	// set TXnRTS as inputs
	mcp2515_write_register(TXRTSCTRL, 0);
	
	// turn off filters => receive any message
	//mcp2515_write_register(RXB0CTRL, (1<<RXM1)|(1<<RXM0));
	//mcp2515_write_register(RXB1CTRL, (1<<RXM1)|(1<<RXM0));

	// FILTERING ENABLED
	// RXM1 && !RXM0: Receive only valid messages with extended identifiers that meet filter criteria
	// BUKT: Rollover Enable bit -> Data from buffer 0 to buffer1
	// ONLY FILTER 0 is enabled
	mcp2515_write_register(RXB0CTRL, (1<<RXM1)|(1<<BUKT));
	mcp2515_write_register(RXB1CTRL, (1<<RXM1));
	
	// reset device to normal mode
	mcp2515_write_register(CANCTRL, 0);
	
	return true;
}

// ----------------------------------------------------------------------------
// check if there are any new messages waiting

uint8_t mcp2515_check_message(void) {
	return (!IS_SET(MCP2515_INT));
}

// ----------------------------------------------------------------------------
// check if there is a free buffer to send messages

bool mcp2515_check_free_buffer(void)
{
	uint8_t status = mcp2515_read_status(SPI_READ_STATUS);
	
	if ((status & 0x54) == 0x54) {
		// all buffers used
		return false;
	}
	
	return true;
}

// ----------------------------------------------------------------------------
uint8_t mcp2515_get_message(tCAN *message)
{
	// read status
	uint8_t status = mcp2515_read_status(SPI_RX_STATUS);
	uint8_t addr;
	
	if (bit_is_set(status,6)) {
		// message in buffer 0
		addr = SPI_READ_RX;
	}
	else if (bit_is_set(status,7)) {
		// message in buffer 1
		addr = SPI_READ_RX | 0x04;
	}
	else {
		// Error: no message available
		return 0;
	}

	RESET(MCP2515_CS);
	spi_putc(addr);
	
	// read id
	message->id  = (uint16_t) spi_putc(0xff) << 3;
	message->id |=            spi_putc(0xff) >> 5;
	
	spi_putc(0xff);
	spi_putc(0xff);
	
	// read DLC
	uint8_t length = spi_putc(0xff) & 0x0f;
	
	message->header.length = length;
	message->header.rtr = (bit_is_set(status, 3)) ? 1 : 0;
	
	// read data
	for (uint8_t i=0;i<length;i++) {
		message->data[i] = spi_putc(0xff);
	}
	SET(MCP2515_CS);
	
	// clear interrupt flag
	if (bit_is_set(status, 6)) {
		mcp2515_bit_modify(CANINTF, (1<<RX0IF), 0);
	}
	else {
		mcp2515_bit_modify(CANINTF, (1<<RX1IF), 0);
	}
	
	return (status & 0x07) + 1;
}

uint8_t mcp2515_get_extmessage(tExtendedCAN *message)
{
	// read status
	uint8_t status = mcp2515_read_status(SPI_RX_STATUS);
	uint8_t addr;
	
	if (bit_is_set(status,6)) {
		// message in buffer 0
		addr = SPI_READ_RX;
	}
	else if (bit_is_set(status,7)) {
		// message in buffer 1
		addr = SPI_READ_RX | 0x04;
	}
	else {
		// Error: no message available
		return 0;
	}

	RESET(MCP2515_CS);
	spi_putc(addr);
	
	// read id
	message->id[0]  = (char) spi_putc(0xff);
	message->id[1]  = (char) spi_putc(0xff);
	
	message->id[2] = spi_putc(0xff);
	message->id[3] = spi_putc(0xff);
	
	// read DLC
	uint8_t length = spi_putc(0xff) & 0x0f;
	
	message->header.length = length;
	message->header.rtr = (bit_is_set(status, 3)) ? 1 : 0;
	
	// read data
	for (uint8_t i=0;i<length;i++) {
		message->data[i] = spi_putc(0xff);
	}
	SET(MCP2515_CS);
	
	// clear interrupt flag
	if (bit_is_set(status, 6)) {
		mcp2515_bit_modify(CANINTF, (1<<RX0IF), 0);
	}
	else {
		mcp2515_bit_modify(CANINTF, (1<<RX1IF), 0);
	}
	
	return (status & 0x07) + 1;
}

// ----------------------------------------------------------------------------
uint8_t mcp2515_send_message(tCAN *message)
{
	uint8_t status = mcp2515_read_status(SPI_READ_STATUS);
	
	/* Statusbyte:
	 *
	 * Bit	Function
	 *  2	TXB0CNTRL.TXREQ
	 *  4	TXB1CNTRL.TXREQ
	 *  6	TXB2CNTRL.TXREQ
	 */
	uint8_t address;
	if (bit_is_clear(status, 2)) {
		address = 0x00;
	}
	else if (bit_is_clear(status, 4)) {
		address = 0x02;
	} 
	else if (bit_is_clear(status, 6)) {
		address = 0x04;
	}
	else {
		// all buffer used => could not send message
		return 0;
	}
	
	RESET(MCP2515_CS);
	spi_putc(SPI_WRITE_TX | address);
	
	spi_putc(message->id >> 3);
    spi_putc(message->id << 5);
	
	spi_putc(0);
	spi_putc(0);
	
	uint8_t length = message->header.length & 0x0f;
	
	if (message->header.rtr) {
		// a rtr-frame has a length, but contains no data
		spi_putc((1<<RTR) | length);
	}
	else {
		// set message length
		spi_putc(length);
		
		// data
		for (uint8_t i=0;i<length;i++) {
			spi_putc(message->data[i]);
		}
	}
	SET(MCP2515_CS);
	
	_delay_us(1);
	
	// send message
	RESET(MCP2515_CS);
	address = (address == 0) ? 1 : address;
	spi_putc(SPI_RTS | address);
	SET(MCP2515_CS);
	
	return address;
}

/*
uint8_t mcp2515_send_extmessage(tExtendedCAN *message)
{
	// Verschickt eine Nachricht ueber Puffer 0
	//  * 2 Datenbytes (0x04, 0xf3)
	//   * Standard ID: 0x0123
	//    
	//uint16_t id = 0x0123;

	// Nachrichten Puffer auf Hoechste Prioritaet einstellen
	//    (braucht man nicht wenn man nur mit einem Puffer sendet, siehe Text) 
	mcp2515_bit_modify( TXB0CTRL, (1<<TXP1)|(1<<TXP0), (1<<TXP1)|(1<<TXP0) );

	// ID einstellen
	mcp2515_write_register(TXB0SIDH, (uint8_t) (message->id[0]));
	mcp2515_write_register(TXB0SIDL, (uint8_t) (message->id[1]));
	mcp2515_write_register(TXB0EID8, (uint8_t) (message->id[2]));
	mcp2515_write_register(TXB0EID0, (uint8_t) (message->id[3]));
	//
	//
	// // Nachrichten Laenge + RTR einstellen
	mcp2515_write_register(TXB0DLC, 2);
	//
	// // Daten
	mcp2515_write_register(TXB0D0, 0x04);
	mcp2515_write_register(TXB0D1, 0xf3);
	//
	// // CAN Nachricht verschicken
	RESET(MCP2515_CS);
	spi_putc(SPI_RTS | 0x01);
	SET(MCP2515_CS);

}*/

void generate_extCAN_ID(uint8_t *bytes, char *resultchars) {

	resultchars[0] = (bytes[0] << 3) | (bytes[1] >> 5);
	resultchars[1] = (bytes[1] & 0x03) | 0x0C | ((bytes[1] & 0xFC) << 3);
	resultchars[2] = bytes[2];
	resultchars[3] = bytes[3];

}


uint8_t mcp2515_send_extmessage(tExtendedCAN *message)
{
	uint8_t status = mcp2515_read_status(SPI_READ_STATUS);
	
	/* Statusbyte:
	 *
	 * Bit	Function
	 *  2	TXB0CNTRL.TXREQ
	 *  4	TXB1CNTRL.TXREQ
	 *  6	TXB2CNTRL.TXREQ
	 */
	uint8_t address;
	if (bit_is_clear(status, 2)) {
		address = 0x00;
	}
	else if (bit_is_clear(status, 4)) {
		address = 0x02;
	} 
	else if (bit_is_clear(status, 6)) {
		address = 0x04;
	}
	else {
		// all buffer used => could not send message
		return 0;
	}

	RESET(MCP2515_CS);
	spi_putc(SPI_WRITE_TX | address);
	
	spi_putc(message->id[0]);
	spi_putc(message->id[1]);
	
	spi_putc(message->id[2]);
	spi_putc(message->id[3]);
	
	uint8_t length = message->header.length & 0x0f;
	
	if (message->header.rtr) {
		// a rtr-frame has a length, but contains no data
		spi_putc((1<<RTR) | length);
	}
	else {
		// set message length
		spi_putc(length);
		
		// data
		for (uint8_t i=0;i<length;i++) {
			spi_putc(message->data[i]);
		}
	}
	SET(MCP2515_CS);
	
	_delay_us(1);
	
	// send message
	RESET(MCP2515_CS);
	address = (address == 0) ? 1 : address;
	spi_putc(SPI_RTS | address);
	SET(MCP2515_CS);
	
	return address;
}

void mcp2515_static_filter(PGM_P filter)
{
	mcp2515_bit_modify(CANCTRL, 0xe0, (1<<REQOP2));
	
	uint8_t index = 0;
	for (uint8_t i=0;i<3;i++)
	{
		RESET(MCP2515_CS);
		spi_putc(SPI_WRITE);
		spi_putc(RXF0SIDH + i*0x10);
		
		for (uint8_t j=0;j<12;j++) 
		{
			if (i == 2 && j >= 0x08)
				break;
			
			spi_putc(pgm_read_byte(&filter[index]));
			index++;
		}
		
		SET(MCP2515_CS);
	}
	
	mcp2515_bit_modify(CANCTRL, 0xe0, 0);
}
