carpe-noctem-cassel/cnc-circuit-boards/optical_flow_sensor/src/OpticalFlowSensor_3DRobotics/AP_OpticalFlow.h

#ifndef AP_OPTICALFLOW_H
#define AP_OPTICALFLOW_H

/*
 *       AP_OpticalFlow.cpp - OpticalFlow Base Class for Ardupilot Mega
 *       Code by Randy Mackay. DIYDrones.com
 *
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
 *       Methods:
 *               init()           : initializate sensor and library.
 *               read             : reads latest value from OpticalFlow and stores values in x,y, surface_quality parameter
 *               read_register()  : reads a value from the sensor (will be sensor specific)
 *               write_register() : writes a value to one of the sensor's register (will be sensor specific)
 */

#include <FastSerial.h>
#include <AP_Math.h>
#include <AP_Common.h>
#include <AP_PeriodicProcess.h>
#include <AP_Semaphore.h>

#define AP_OPTICALFLOW_NUM_CALLS_FOR_10HZ     100         // timer process runs at 1khz.  100 iterations = 10hz
#define AP_OPTICALFLOW_NUM_CALLS_FOR_20HZ     50          // timer process runs at 1khz.  50 iterations = 20hz
#define AP_OPTICALFLOW_NUM_CALLS_FOR_50HZ     20          // timer process runs at 1khz.  20 iterations = 50hz

class AP_OpticalFlow
{
public:
    int                     raw_dx, raw_dy; // raw sensor change in x and y position (i.e. unrotated)
    int                     surface_quality; // image quality (below 15 you really can't trust the x,y values returned)
    int                     x,y; // total x,y position
    int                     dx,dy; // rotated change in x and y position
    float                   vlon, vlat; // position as offsets from original position
    unsigned long           last_update; // millis() time of last update
    float                   field_of_view; // field of view in Radians
    float                   scaler; // number returned from sensor when moved one pixel
    int                     num_pixels; // number of pixels of resolution in the sensor
    // temp variables - delete me!
    float                   exp_change_x, exp_change_y;
    float                   change_x, change_y;
    float                   x_cm, y_cm;
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
