carpe-noctem-cassel/cnc-circuit-boards/(commit log)

2016-11-18 moved from msl_electronic_boards to new repository
    [Bestellliste_Reichelt.xls, Bestellliste_Reichelt02.xls, CN-Cape-1.0.brd, CN-Cape-1.0.sch, CN-Cape-1.1.brd, CN-Cape-1.1.sch, CN-Cape005-via08.brd, CN-Cape005-via08.sch]
2016-11-18 PowerSwitch PartList
    [2016-v0.9.ods, CNC-PowerSwitch-2016-v0.9.brd, CNC-PowerSwitch-2016-v0.9.sch]
2016-11-24 powerswitch final version and partlist
    [2016-v0.92.ods, CNC-PowerSwitch-2016-v0.92.brd, CNC-PowerSwitch-2016-v0.92.sch]
2016-12-05 PowerSwitch with Ethernet
    [2016-v0.95.ods, CNC-PowerSwitch-2016-v0.95.brd, CNC-PowerSwitch-2016-v0.95.sch]
2016-12-06 powerswitch added ethernet, next step design
    [2016-v0.95.ods, CNC-PowerSwitch-2016-v0.95.brd, CNC-PowerSwitch-2016-v0.95.sch]
2016-12-14 powerswitch layout
    [CNC-PowerSwitch-2016-v0.95.brd]
2016-12-15 PowerSwitch Layout near finish
    [CNC-PowerSwitch-2016-v0.95.brd, CNC-PowerSwitch-2016-v0.95.sch]
2016-12-28 PowerSwitch Layout finished
    [CNC-PowerSwitch-2016-v0.95.brd, CNC-PowerSwitch-2016-v0.95.sch]
2016-12-29 start beagle2can board
    [beagle2can.brd, beagle2can.sch]
2016-12-30 beagle2can layout finished
    [beagle2can.brd, beagle2can.sch]
2017-01-12 little changes and part list for beagle2can, cape1.1
    [2016-v0.95.ods, CN-Cape-1.1.brd, CN-Cape1.1.ods, beagle2can.brd, beagle2can.ods, beagle2can.sch]
2017-01-27 cut-off for ethernet
    [beagle2can.brd]
2017-02-09 small fixes powerswitch
    [CNC-PowerSwitch-2016-v0.96.brd, CNC-PowerSwitch-2016-v0.96.sch]
2017-10-25 kicker new version
    [rekick2017-v0.1.brd, rekick2017-v0.1.sch]
2017-12-16 Kicker - Layout halb fertig
    [rekick2017-v0.1.brd, rekick2017-v0.1.sch]
2017-12-20 Kicker 2017
    [rekick2017-v0.1.brd, rekick2017-v0.1.sch]
2018-01-10 rekick2017 final version?
    [rekick2017-v0.1.brd]
2018-03-05 adding kicker BOM
    [BOM rekick 2017.ods]
2018-03-27 new BOM and board files
    [BOM-rekick2017-v0.1.ods, BOM-rekick2017-v0.2.ods, rekick2017-v0.2.brd, rekick2017-v0.2.sch]
2018-03-28 modified parameter for kick voltage calculation
2018-03-28 corrected fb-loop
    [rekick2017-v0.2.brd, rekick2017-v0.2.sch]
2018-03-29 kicker 2017 v0.2 final
    [rekick2017-v0.2.brd, rekick2017-v0.2.sch]
2018-04-11 rekick2017 0.2 (TODO: finish layout)
    [rekick2017-v0.2.brd, rekick2017-v0.2.sch]
