carpe-noctem-cassel/cnc-circuit-boards/(notices)

Notices in the files:
parts and their libraries:
con-molex-mini-fit: Copyright (C) 2011, Bob Starr
recom-intl: Copyright (C) 2010, Bob Starr
EagleLibrary_Wuerth_Elektronik_eiSos_rev: Copyright: Würth Elektronik
r-78xx_10: (c) 2015 Samuel Lourenço
